orku/course_project_dmm/с одной зубчатой передчей/ЛИР-119А.docx

ЛИР-119А

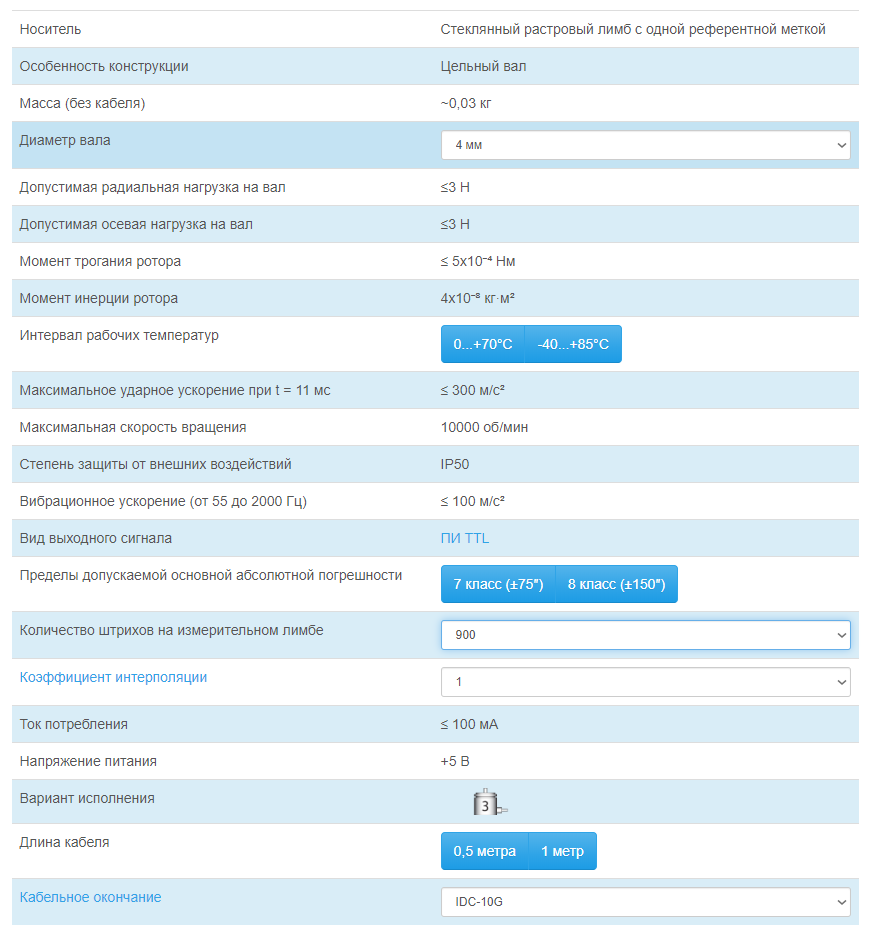
[picture p18: figure]
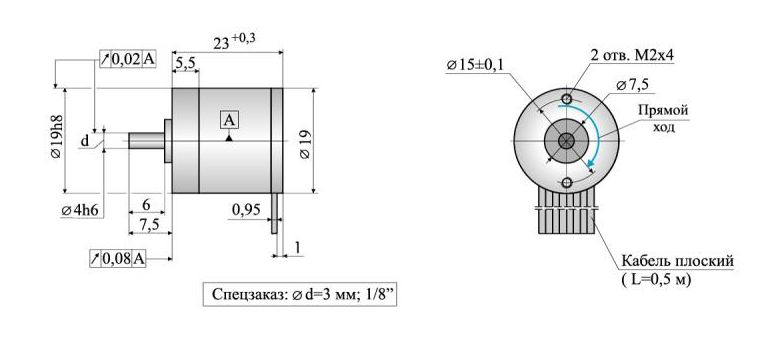
[picture p19: figure]
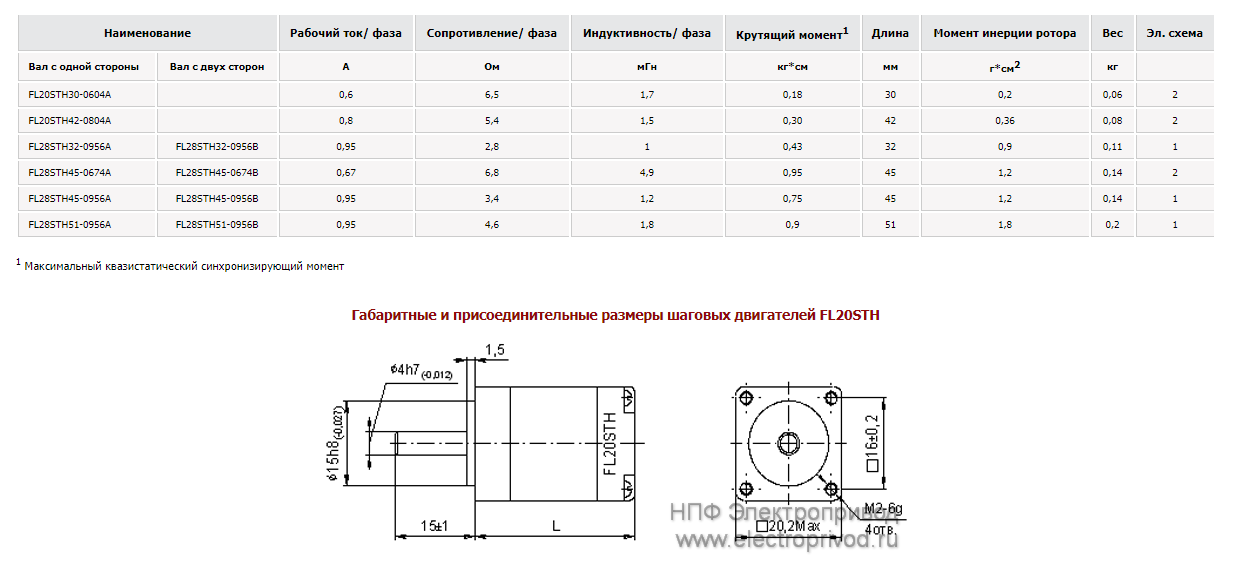
[picture p20: figure]
