orku/course_project_dmm/с одной зубчатой передчей/val/на жёчткость.docx

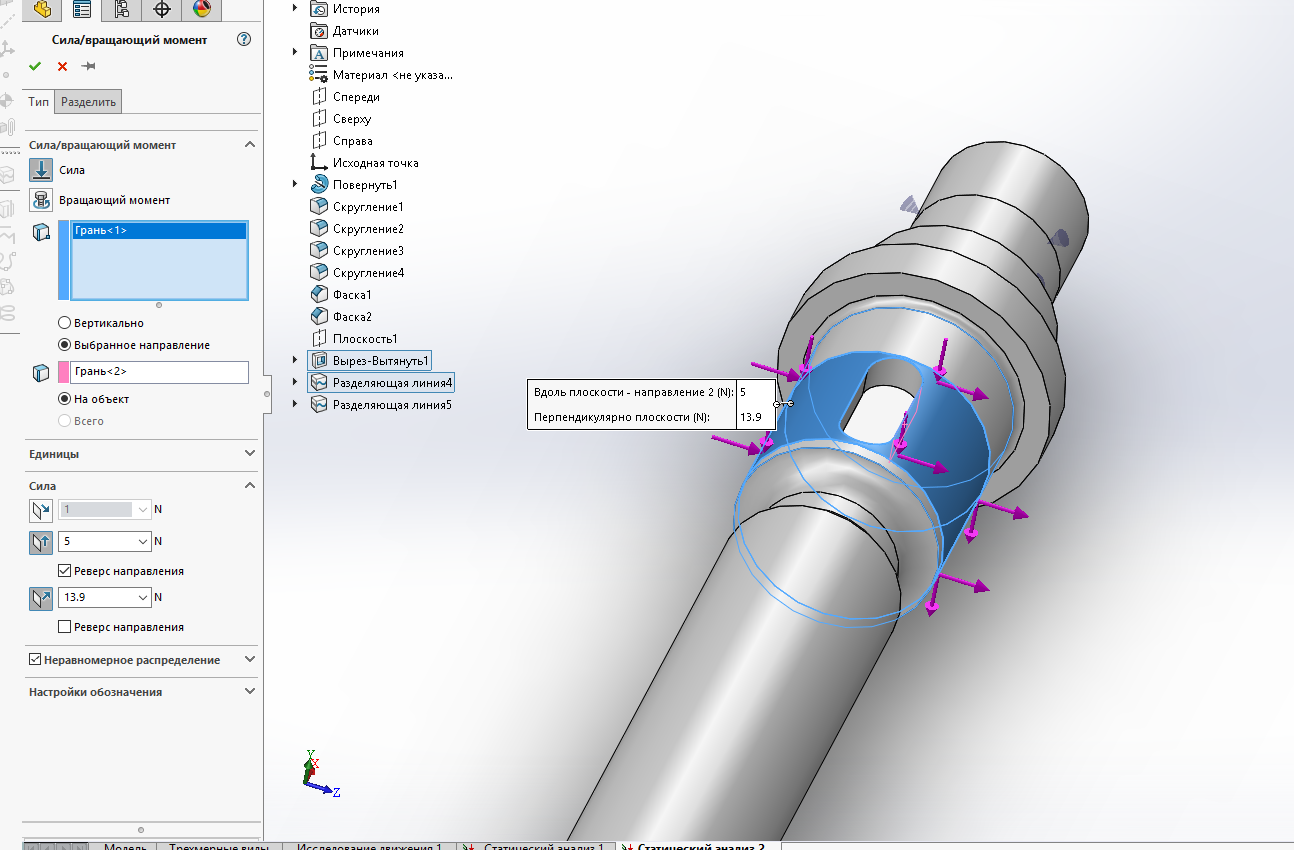
[picture p33: figure]
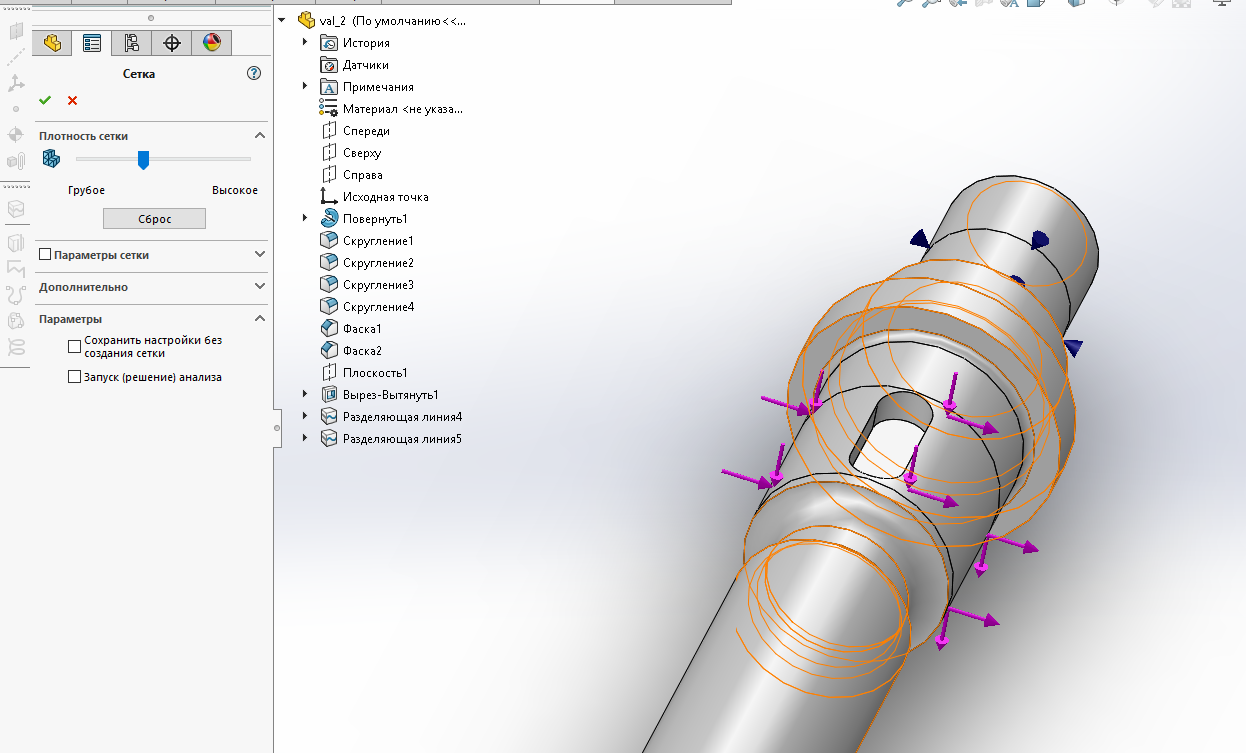
[picture p34: figure]
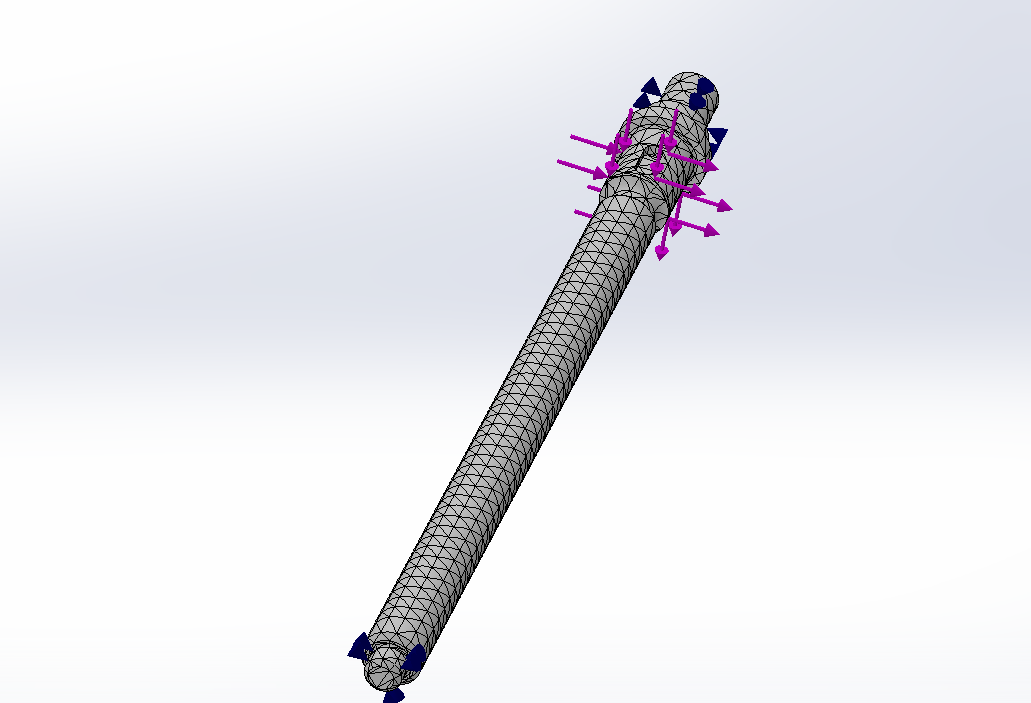
[picture p35: figure]
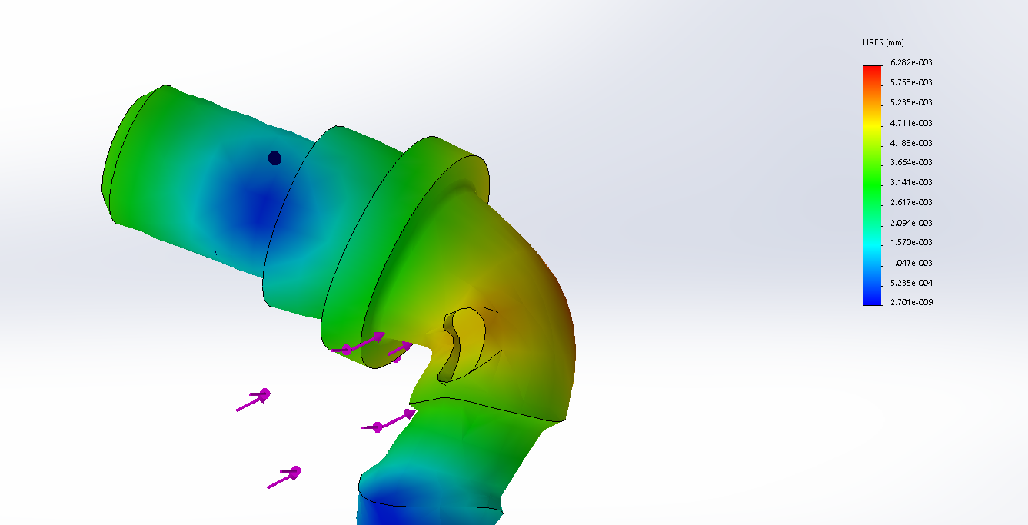
[picture p36: figure]
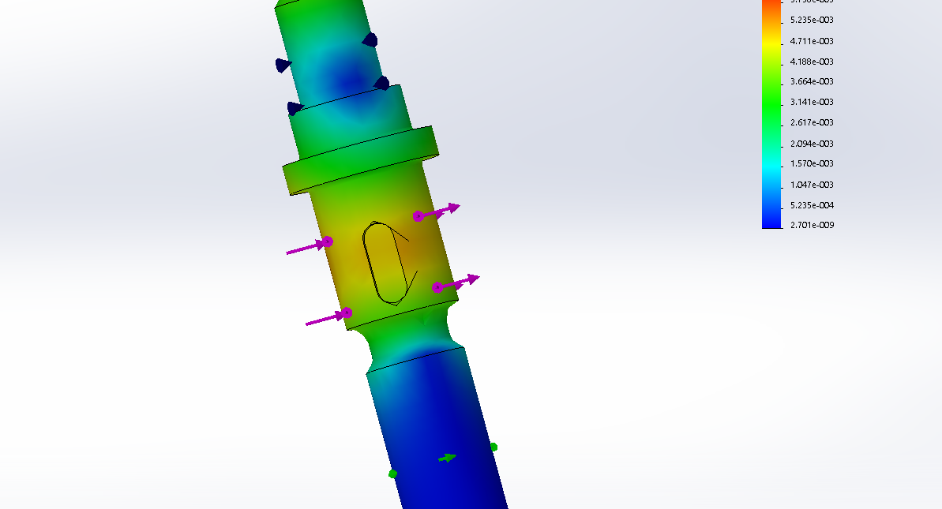
[picture p37: figure]
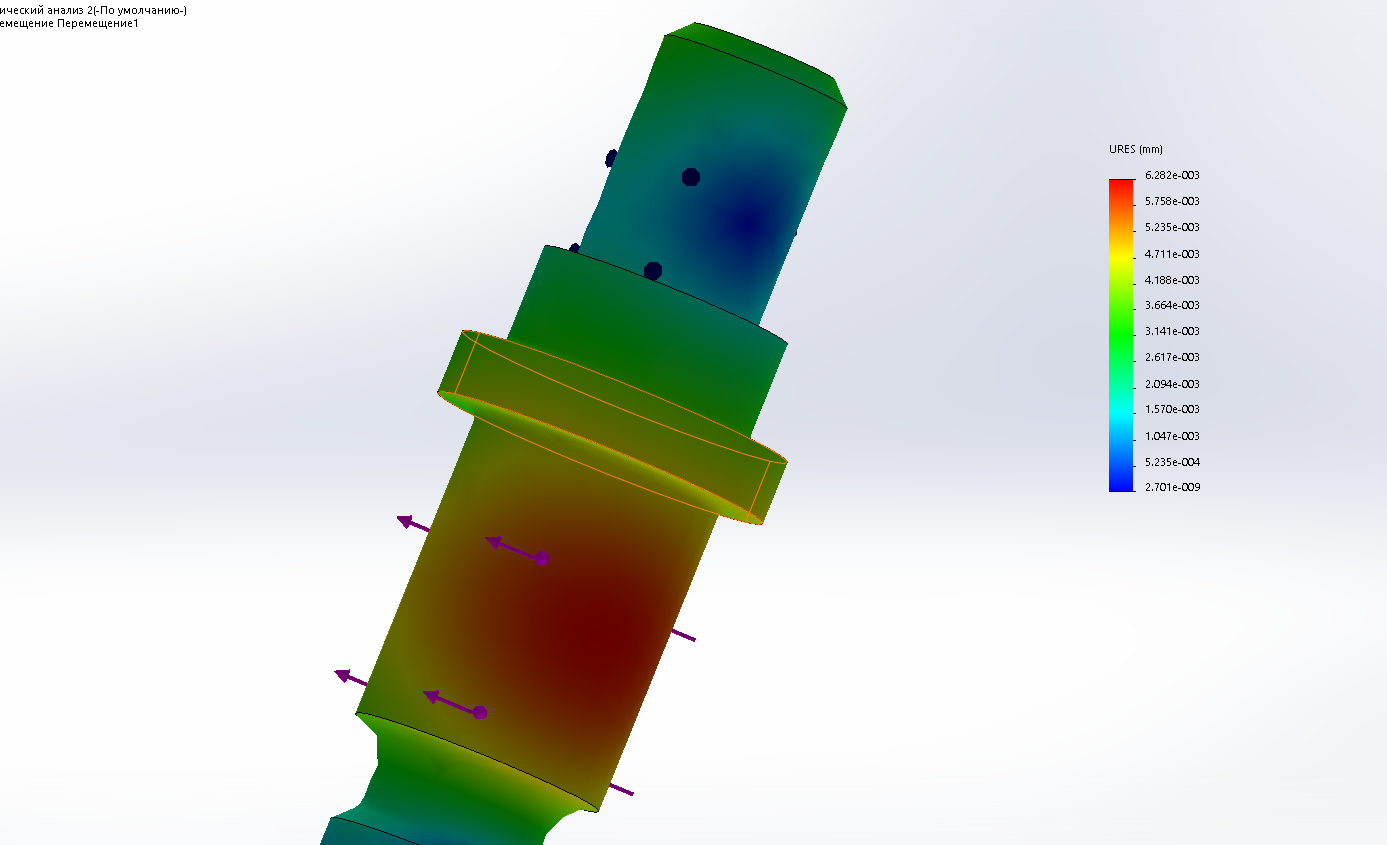
[picture p38: figure]
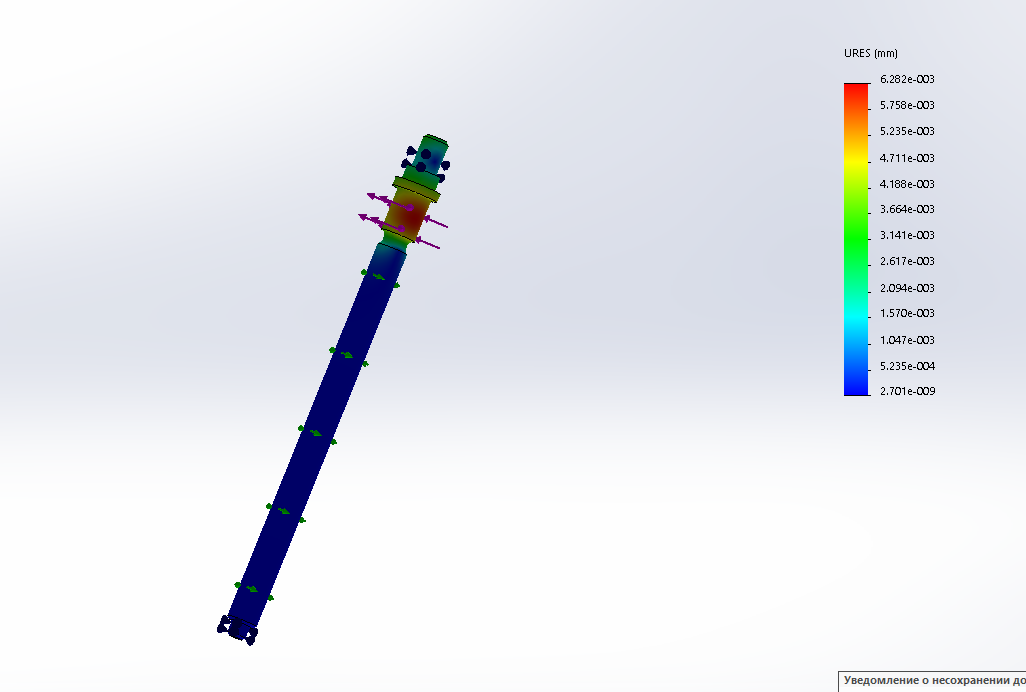
[picture p39: figure]
