orku/course_project_dmm/с одной зубчатой передчей/val/val_2-Статический анализ 1-1.docx

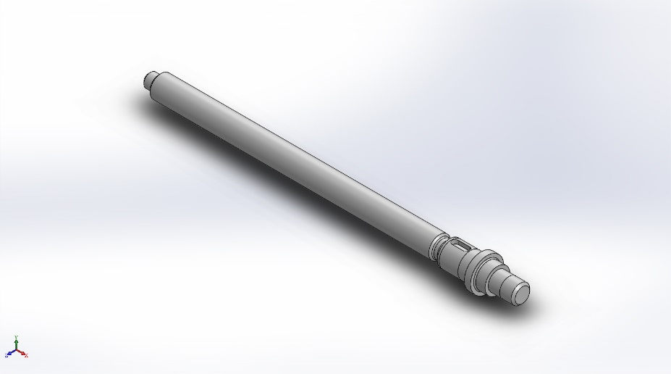
[picture p40: figure]

Симуляция val_2

Date: 21 мая 2020 г.
Создатель:: Шестаков А, А,

Имя исследования: Статический анализ 1

Тип анализа: Статический анализ
Описание Данные отсутствуют

# Допущения

# Информация о модели

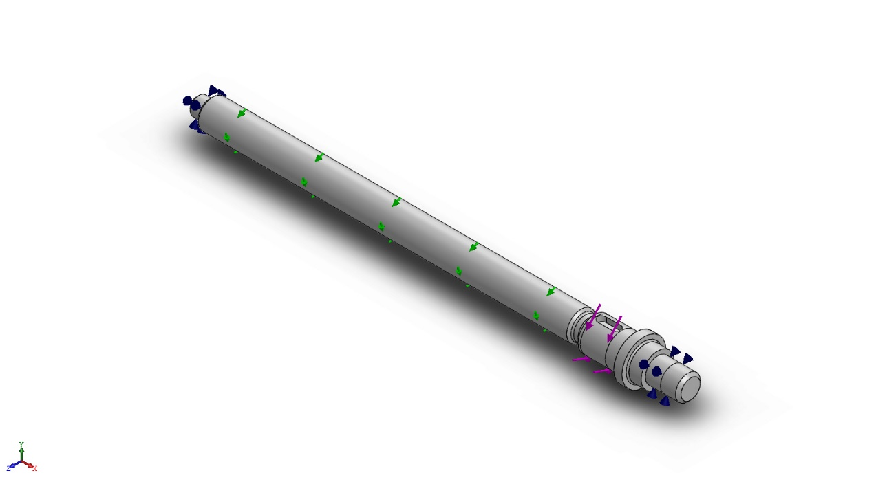
[picture p41: figure]

Имя модели: val_2

Активная конфигурация: По умолчанию

Твердые тела
Имя и ссылки документа | Рассматривается как | Объемные свойства | Путь документа/Дата изменения

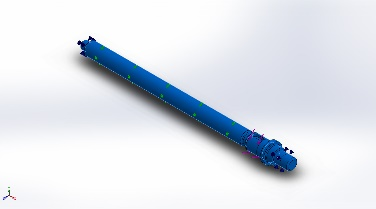
[picture p42: figure]

Разделяющая линия5 | Твердое тело | Масса:0.119673 kg Объем:1.57568e-005 m^3 Плотность:7595 kg/m^3 Масса:1.1728 N | C:\Users\asus\OneDrive\Курсач ДММ\course_project_dmm\с одной зубчатой передчей\val\val_2.SLDPRT May 21 02:11:37 2020

# Свойства исследования

Имя исследования | Статический анализ 1
Тип анализа | Статический анализ
Тип сетки | Сетка на твердом теле
Тепловой эффект: | Вкл
Термический параметр | Включить тепловые нагрузки
Температура при нулевом напряжении | 298 Kelvin
Включить эффекты давления жидкости из SOLIDWORKS Flow Simulation | Выкл
Тип решающей программы | FFEPlus
Влияние нагрузок на собственные частоты: | Выкл
Мягкая пружина: | Выкл
Инерционная разгрузка: | Выкл
Несовместимые параметры связи | Авто
Большие перемещения | Выкл
Вычислить силы свободных тел | Вкл
Трение | Выкл
Использовать адаптивный метод: | Выкл
Папка результатов | Документ SOLIDWORKS (C:\Users\asus\OneDrive\Курсач ДММ\course_project_dmm\с одной зубчатой передчей\val)

# Единицы

Система единиц измерения: | СИ (MKS)
Длина/Перемещение | mm
Температура | Kelvin
Угловая скорость | Рад/сек
Давление/Напряжение | N/m^2

# Свойства материала

Ссылка на модель | Свойства | Компоненты

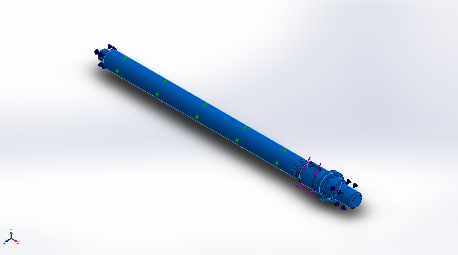
[picture p43: figure]

| Имя: Сталь 45 ГОСТ 1050-2013 Тип модели: Линейный Упругий Изотропный Критерий прочности по умолчанию: Максимальное напряжение von Mises Предел текучести: 6.4e+008 N/m^2 Предел прочности при растяжении: 5.9e+008 N/m^2 Предел прочности при сжатии: 3.75e+008 N/m^2 Модуль упругости: 2e+009 N/m^2 Коэффициент Пуассона: 0.394 Массовая плотность: 7595 kg/m^3 Модуль сдвига: 7.8e+009 N/m^2 | Твердое тело 1(Разделяющая линия5)(val_2)

Данные кривой:N/A

# Нагрузки и крепления

Имя крепления | Изображение крепления | Данные крепления

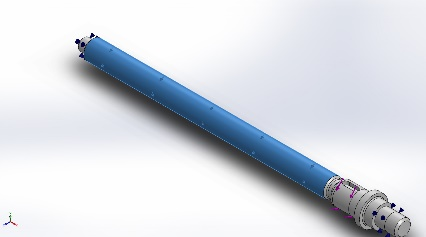
[picture p44: figure]

На цилиндрических гранях-1 | | Объекты: 1 грани Тип: На цилиндрических гранях Смещение: ---, 0 рад., --- Единицы измерения: mm

Результирующие силы

Компоненты | X | Y | Z | Результирующая
Сила реакции(N) | -2.80074e-007 | -0.0234661 | 4.933 | 4.93306
Реактивный момент(N.m) | 0 | 0 | 0 | 0

Имя нагрузки | Загрузить изображение | Загрузить данные

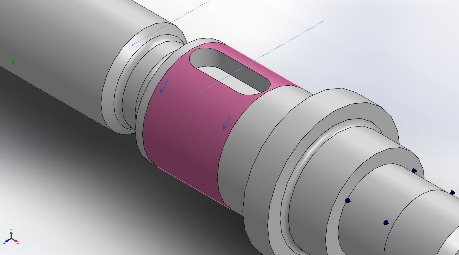
[picture p45: figure]

Вращающий момент-1 | | Справочный: Грань< 1 > Тип: Приложить вращающий момент Значение: 0.52 N.m

# Определения соединителей

Соединитель-шпилька/болт/подшипник

Ссылка на модель | Данные соединителя | Данные силы

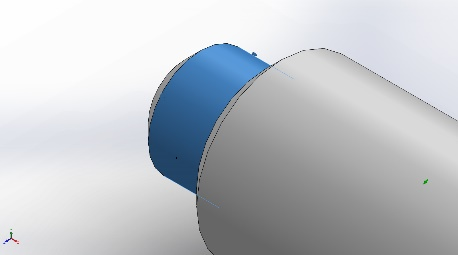
[picture p46: figure]

Опора подшипника-1 | Объекты: 1 грани Тип: Подшипник | Данные отсутствуют

Силы соединителя

Тип | X-составляющая | Y-составляющая | Z-составляющая | Результирующая
Осевое усилие (N) | 0.0024335 | 0 | 0 | 0.0024335
Поперечная сила (N) | 0 | -2.885e-006 | 4.2127e-006 | 5.1182e-006
Изгибающий момент (N.m) | 0 | 0 | 0 | 0

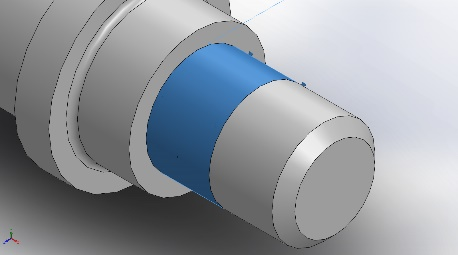
[picture p47: figure]

Опора подшипника-2 | Объекты: 1 грани Тип: Подшипник | Данные отсутствуют

Силы соединителя

Тип | X-составляющая | Y-составляющая | Z-составляющая | Результирующая
Осевое усилие (N) | -0.0024332 | -0 | -0 | -0.0024332
Поперечная сила (N) | 0 | 0.014527 | 1.9899 | 1.9899
Изгибающий момент (N.m) | 0 | 0 | 0 | 0

# Данные контакта

Данные отсутствуют

# Информация о сетке

Тип сетки | Сетка на твердом теле
Используемое разбиение: | Стандартная сетка
Автоматическое уплотнение сетки: | Выкл
Включить автоциклы сетки: | Выкл
Точки Якобиана | 4 Точки
Размер элемента | 3.38571 mm
Допуск | 0.169286 mm
Эпюра качества сетки | Высокая

## Информация о сетке - Детализация

Всего узлов | 6861
Всего элементов | 4013
Максимальное соотношение сторон | 10.452
% элементов с соотношением сторон < 3 | 91.3
% элементов с соотношением сторон > 10 | 0.0249
% искаженных элементов (Якобиан) | 0
Время для завершения сетки (hh;mm;ss): | 00:00:03
Имя компьютера:

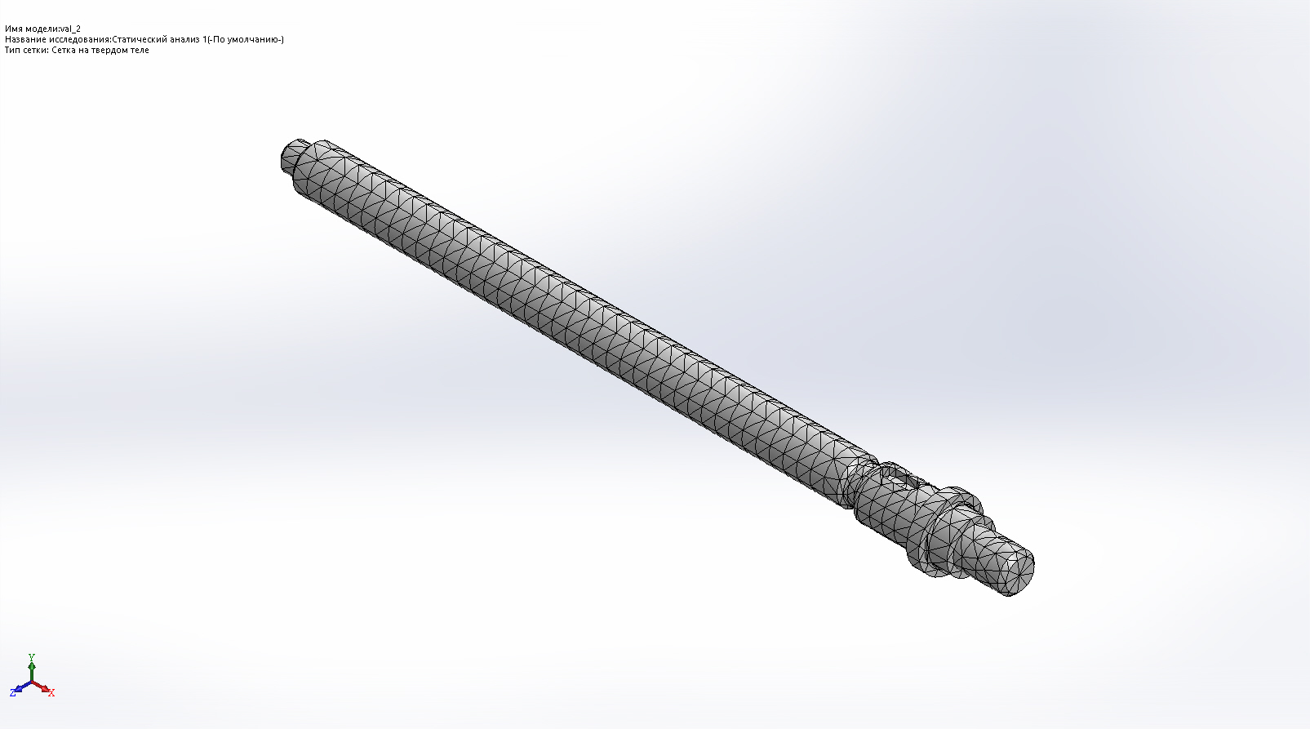
[picture p48: figure]

# Данные датчиков

Данные отсутствуют

# Результирующие силы

## Силы реакции

Выбранный набор | Единицы | Сумма X | Сумма Y | Сумма Z | Результирующая
всей модели | N | -2.80074e-007 | -0.0234661 | 4.933 | 4.93306

## Моменты реакции

Выбранный набор | Единицы | Сумма X | Сумма Y | Сумма Z | Результирующая
всей модели | N.m | 0 | 0 | 0 | 0

# Балки

Данные отсутствуют

# Результаты исследования

Имя | Тип | Мин | Макс
Напряжение1 | VON: Напряжение Von Mises | 2.979e+000N/m^2 Узел: 1397 | 1.019e+007N/m^2 Узел: 500

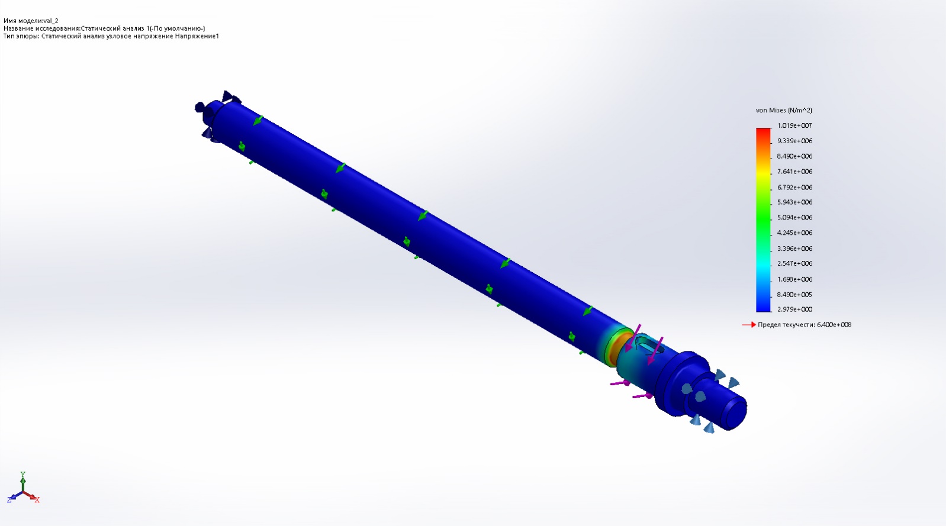
[picture p49: figure]

val_2-Статический анализ 1-Напряжение-Напряжение1

Имя | Тип | Мин | Макс
Перемещение1 | URES: Результирующее перемещение | 2.345e-010mm Узел: 507 | 7.798e-002mm Узел: 2746

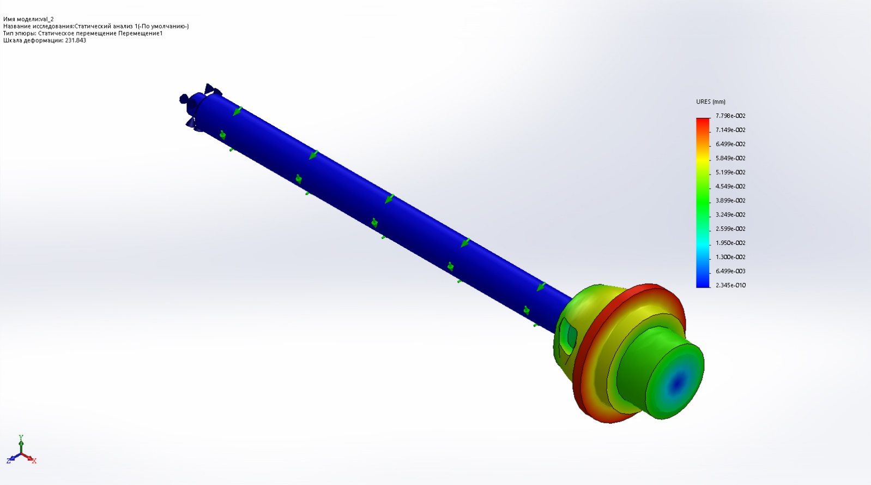
[picture p50: figure]

val_2-Статический анализ 1-Перемещение-Перемещение1

Имя | Тип | Мин | Макс
Деформация1 | ESTRN: Эквивалентная деформация | 2.664e-009 Элемент: 2767 | 3.871e-003 Элемент: 2362

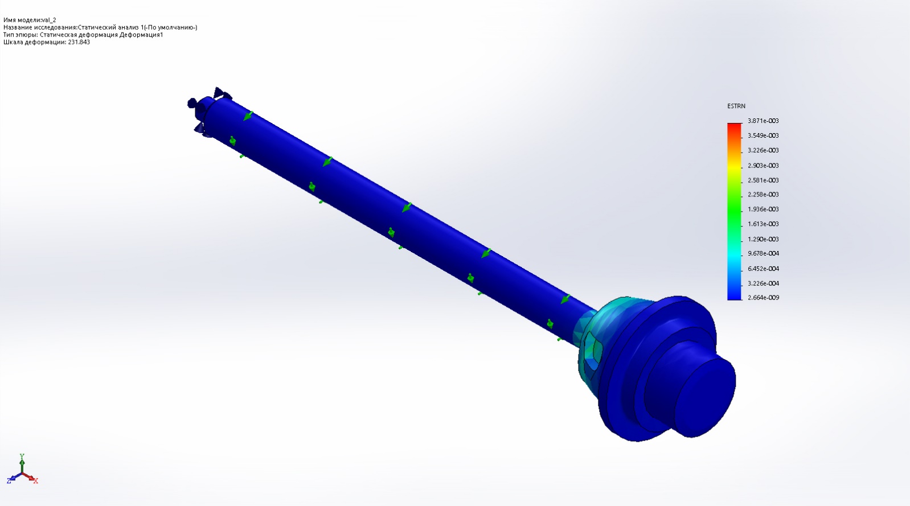
[picture p51: figure]

val_2-Статический анализ 1-Деформация-Деформация1

# Вывод

Проанализировано с помощью SOLIDWORKS Simulation Симуляция val_2 7

Проанализировано с помощью SOLIDWORKS Simulation Симуляция val_2 1

МГТУ им. Н. Э. Баумана СМ11-61Б Шестаков А, А, 21.05.2020

МГТУ им. Н. Э. Баумана СМ11-61Б
