orku/course_project_dmm/с одной зубчатой передчей/val/val_2-Статический анализ 1-2.docx

Симуляция val_2

Date: 21 мая 2020 г.
Создатель:: Шестаков А. А.

Имя исследования: Статический анализ 1

Тип анализа: Статический анализ
Описание Данные отсутствуют

# Допущения

# Информация о модели

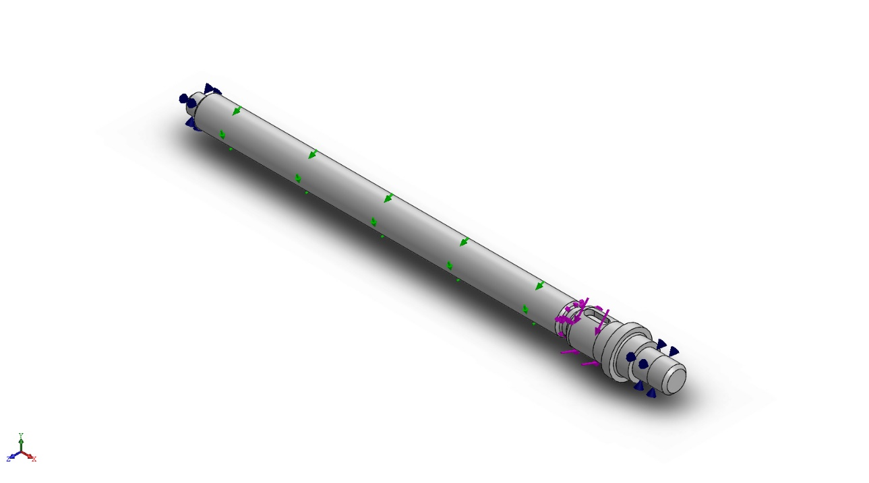
[picture p52: figure]

Имя модели: val_2

Активная конфигурация: По умолчанию

Твердые тела
Имя и ссылки документа | Рассматривается как | Объемные свойства | Путь документа/Дата изменения

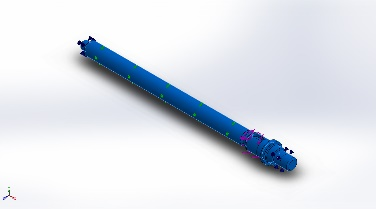
[picture p53: figure]

Разделяющая линия5 | Твердое тело | Масса:0.119673 kg Объем:1.57568e-005 m^3 Плотность:7595 kg/m^3 Масса:1.1728 N | C:\Users\asus\OneDrive\Курсач ДММ\course_project_dmm\с одной зубчатой передчей\val\val_2.SLDPRT May 21 02:11:37 2020

# Свойства исследования

Имя исследования | Статический анализ 1
Тип анализа | Статический анализ
Тип сетки | Сетка на твердом теле
Тепловой эффект: | Вкл
Термический параметр | Включить тепловые нагрузки
Температура при нулевом напряжении | 298 Kelvin
Включить эффекты давления жидкости из SOLIDWORKS Flow Simulation | Выкл
Тип решающей программы | FFEPlus
Влияние нагрузок на собственные частоты: | Выкл
Мягкая пружина: | Выкл
Инерционная разгрузка: | Выкл
Несовместимые параметры связи | Авто
Большие перемещения | Выкл
Вычислить силы свободных тел | Вкл
Трение | Выкл
Использовать адаптивный метод: | Выкл
Папка результатов | Документ SOLIDWORKS (C:\Users\asus\OneDrive\Курсач ДММ\course_project_dmm\с одной зубчатой передчей\val)

# Единицы

Система единиц измерения: | СИ (MKS)
Длина/Перемещение | mm
Температура | Kelvin
Угловая скорость | Рад/сек
Давление/Напряжение | N/m^2

# Свойства материала

Ссылка на модель | Свойства | Компоненты

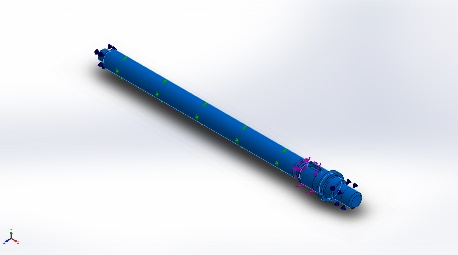
[picture p54: figure]

| Имя: Сталь 45 ГОСТ 1050-2013 Тип модели: Линейный Упругий Изотропный Критерий прочности по умолчанию: Максимальное напряжение von Mises Предел текучести: 6.4e+008 N/m^2 Предел прочности при растяжении: 5.9e+008 N/m^2 Предел прочности при сжатии: 3.75e+008 N/m^2 Модуль упругости: 2e+009 N/m^2 Коэффициент Пуассона: 0.394 Массовая плотность: 7595 kg/m^3 Модуль сдвига: 7.8e+009 N/m^2 | Твердое тело 1(Разделяющая линия5)(val_2)

Данные кривой:N/A

# Нагрузки и крепления

Имя крепления | Изображение крепления | Данные крепления

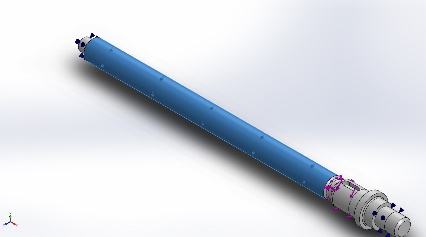
[picture p55: figure]

На цилиндрических гранях-1 | | Объекты: 1 грани Тип: На цилиндрических гранях Смещение: ---, 0 рад., --- Единицы измерения: mm

Результирующие силы

Компоненты | X | Y | Z | Результирующая
Сила реакции(N) | 1.59601e-007 | -0.00971296 | 4.93778 | 4.93779
Реактивный момент(N.m) | 0 | 0 | 0 | 0

Имя нагрузки | Загрузить изображение | Загрузить данные

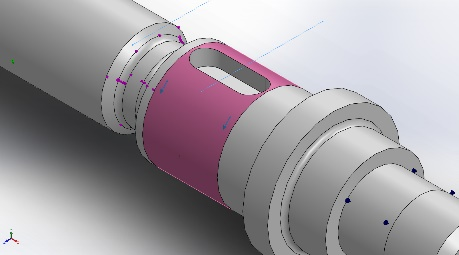
[picture p56: figure]

Вращающий момент-1 | | Справочный: Грань< 1 > Тип: Приложить вращающий момент Значение: 0.52 N.m

# Определения соединителей

Соединитель-шпилька/болт/подшипник

Ссылка на модель | Данные соединителя | Данные силы


Опора подшипника-1 | Объекты: 1 грани Тип: Подшипник | Данные отсутствуют

Силы соединителя

Тип | X-составляющая | Y-составляющая | Z-составляющая | Результирующая
Осевое усилие (N) | -0.00042492 | -0 | -0 | -0.00042492
Поперечная сила (N) | 0 | -4.0452e-007 | 1.1435e-007 | 4.1549e-007
Изгибающий момент (N.m) | 0 | 0 | 0 | 0


Опора подшипника-2 | Объекты: 1 грани Тип: Подшипник | Данные отсутствуют

Силы соединителя

Тип | X-составляющая | Y-составляющая | Z-составляющая | Результирующая
Осевое усилие (N) | 0.00042521 | 0 | 0 | 0.00042521
Поперечная сила (N) | 0 | 0.0013764 | 1.9081 | 1.9081
Изгибающий момент (N.m) | 0 | 0 | 0 | 0

# Данные контакта

Данные отсутствуют

# Информация о сетке

Тип сетки | Сетка на твердом теле
Используемое разбиение: | Стандартная сетка
Автоматическое уплотнение сетки: | Выкл
Включить автоциклы сетки: | Выкл
Точки Якобиана | 4 Точки
Размер элемента | 3.38571 mm
Допуск | 0.169286 mm
Эпюра качества сетки | Высокая

## Информация о сетке - Детализация

Всего узлов | 21614
Всего элементов | 13799
Максимальное соотношение сторон | 9.8607
% элементов с соотношением сторон < 3 | 96.8
% элементов с соотношением сторон > 10 | 0
% искаженных элементов (Якобиан) | 0
Время для завершения сетки (hh;mm;ss): | 00:00:02
Имя компьютера:

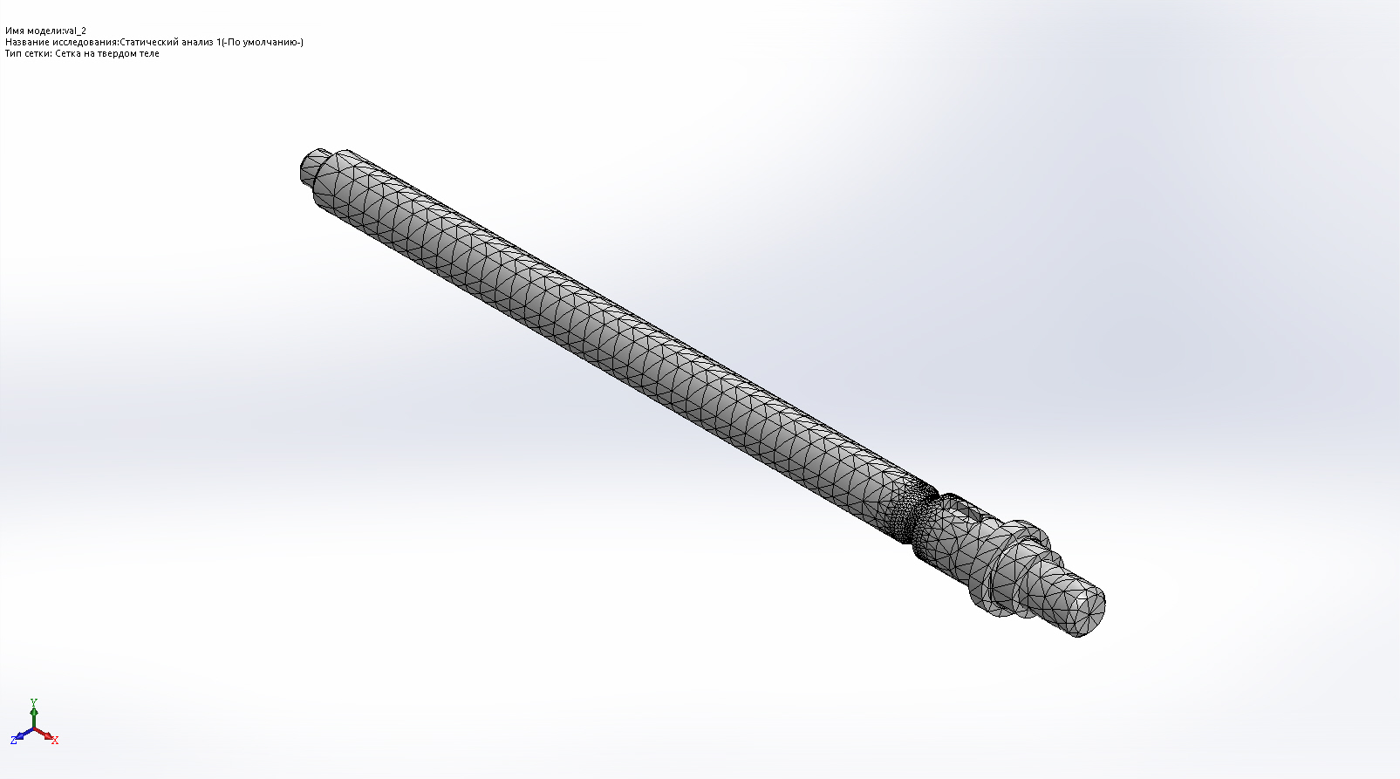
[picture p57: figure]

## Информация по управлению сеткой:

Имя управления сеткой | Изображение управления сеткой | Сведения об управлении сеткой

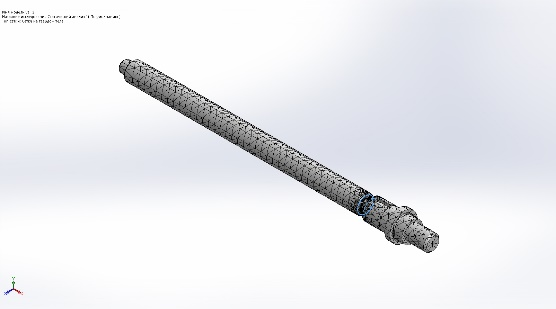
[picture p58: figure]

Управление-1 | | Объекты: 1 кромки, 5 грани Единицы измерения: mm Размер: 0.626984 Пропорция: 1.5

# Данные датчиков

Данные отсутствуют

# Результирующие силы

## Силы реакции

Выбранный набор | Единицы | Сумма X | Сумма Y | Сумма Z | Результирующая
всей модели | N | 1.59601e-007 | -0.00971296 | 4.93778 | 4.93779

## Моменты реакции

Выбранный набор | Единицы | Сумма X | Сумма Y | Сумма Z | Результирующая
всей модели | N.m | 0 | 0 | 0 | 0

# Балки

Данные отсутствуют

# Результаты исследования

Имя | Тип | Мин | Макс
Напряжение1 | VON: Напряжение Von Mises | 6.981e-001N/m^2 Узел: 1668 | 1.078e+007N/m^2 Узел: 14621

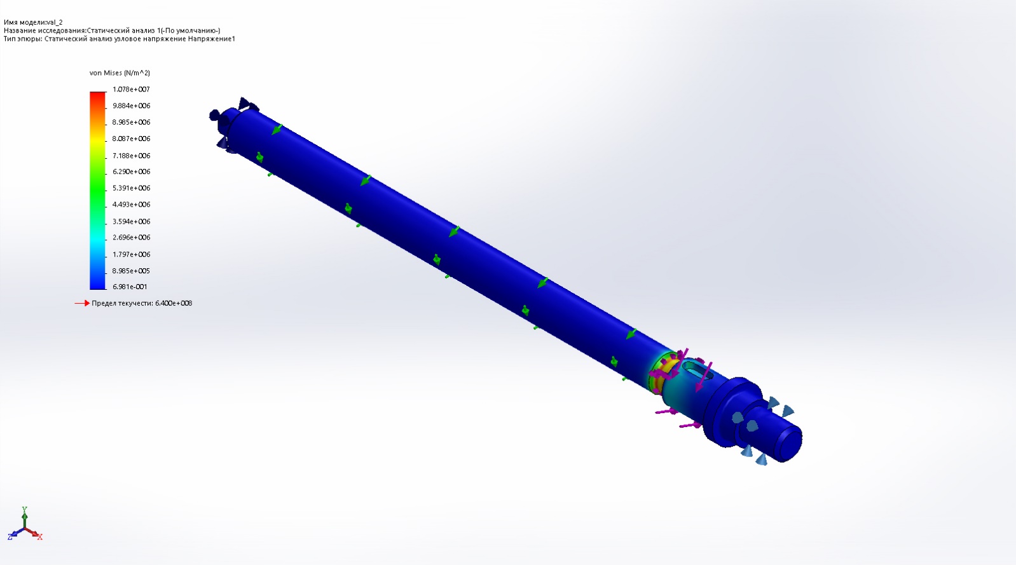
[picture p59: figure]

val_2-Статический анализ 1-Напряжение-Напряжение1

Имя | Тип | Мин | Макс
Перемещение1 | URES: Результирующее перемещение | 5.812e-011mm Узел: 21426 | 7.943e-002mm Узел: 11866

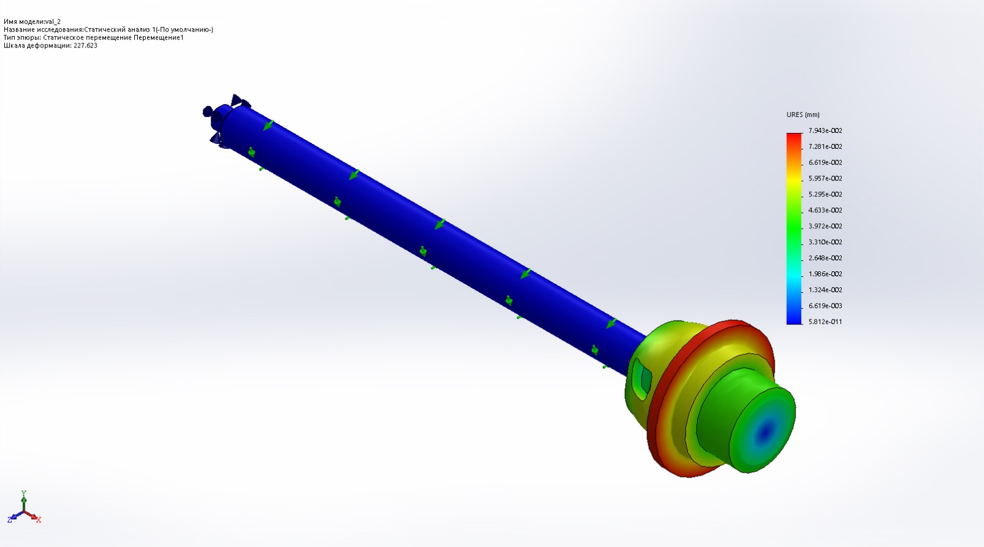
[picture p60: figure]

val_2-Статический анализ 1-Перемещение-Перемещение1

Имя | Тип | Мин | Макс
Деформация1 | ESTRN: Эквивалентная деформация | 4.122e-010 Элемент: 11133 | 4.569e-003 Элемент: 4695

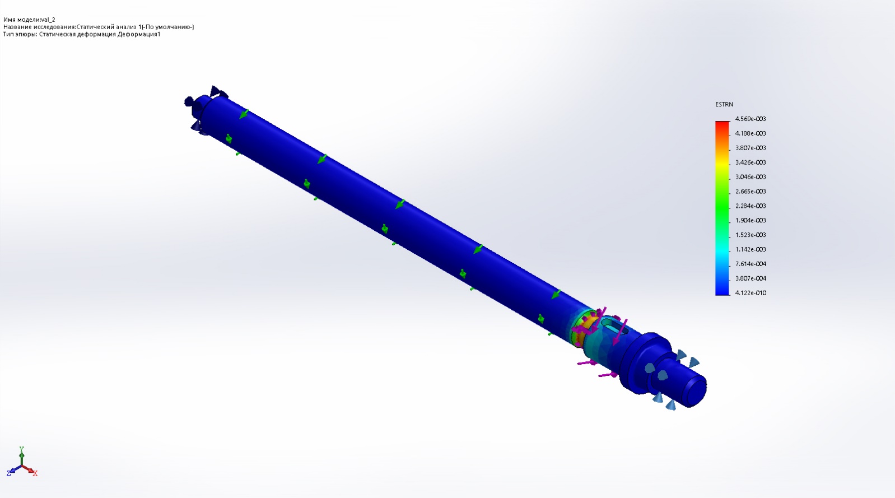
[picture p61: figure]

val_2-Статический анализ 1-Деформация-Деформация1

# Вывод

Проанализировано с помощью SOLIDWORKS Simulation Симуляция val_2 57

Проанализировано с помощью SOLIDWORKS Simulation Симуляция val_2 56

МГТУ им. Н. Э. Баумана СМ11-61Б Шестаков А. А. 21.05.2020

МГТУ им. Н. Э. Баумана СМ11-61Б
