orku/course_project_dmm/с одной зубчатой передчей/печать на консу 08.05.2020/переделываю рпз(оааааааааааааааааааапять).docx

# Оглавление

# Техническое задание

№ варианта | 4
Параметры
Сила на выходном звене F, Н | 150
Скорость движения выходного звена V, м/с | 0,012
Ход выходного звена S, мм | 90
Диаметр и шаг винта выходной пары d/p, d и p, мм* | 12/3
Тип предохранителя муфты | Фрикционная
Критерий проектирования | Min погрешности
Тип электродвигателя | По согласованию с преподавателем
Тип корпуса | По согласованию с преподавателем
Ограничитель движения | Механические упоры и микровыключатели
Вид крепления к основному изделию | По согласованию с преподавателем
Вывод выходного винта | По согласованию с преподавателем
Вид выходного конца | По согласованию с преподавателем
Условия эксплуатации | УХЛ 4.1
Тип кинематической схемы | По согласованию с преподавателем

# 1. Расчёт передачи винт-гайка

Используем трапецеидальную резьбу.

Табл. 1. Геометрические параметры резьбы

Номинальный диаметр резьбы d | Шаг p | Диаметр резьбы
| | наружный | | средний | Внутренний
| | d | D4 | d2=D2 | d3 | D1
12 | 3 | 12 | 12,5 | 10,5 | 8,5 | 9

В передачах винт-гайка скольжения для повышения износостойкости и снижения склонности к заеданию гайки изготавливают из материалов, обладающих антифрикционными свойствами, а материал винта должен обладать высокой твёрдостью. Поэтому для изготовления винтов применяют низколегированные стали 65Г, 40Х, 40ХГ с закалкой до твёрдости не менее 45 HRC и последующим шлифованием; стали 40ХФА, 18ХГТ с азотированием для уменьшения искажения формы и размеров винтов в результате закалки. Для тихоходных слабонагруженных винтов используют стали 30, 40, 45 и 50 ГОСТ 1050 – 88 без термической обработки. При малых скоростях вращения гайки изготавливают из малооловянной бронзы Бр.О6Ц6С3, безоловянной бронзы Бр.А9Ж3Л, а также из антифрикционных чугунов АЧВ – 1, АЧК – 1, или серых чугунов СЧ15 и СЧ20 ГОСТ 1412 – 85.

Винт изготавливаем из стали 45;

Гайку изготавливаем из Бр.А9Ж3Л;

Момент нагрузки на винте определяем по формуле:

М_н =F*(d_2)/2*tg(β+ ψ)

Где d_2 – внутренний диаметр резьбы;

ψ – угол подъёма резьбы, который определяется по формуле:

ψ=arctg(p*n)/(π*d_2)= arctg(3*1)/(π*10.5)= 5.2^0

Где р – шаг резьбы, n – число заходов.

β – угол трения, который определяется по формуле:

β=arctg(f')

f^(') = f/(cosα/2)

Где α – угол резьбы ( α=30^0 );

f – коэффициент трения скольжения передачи винт гайка.

Выберем материал винта и гайки соответственно сталь 45 и бронза Бр.А9Ж3Л . У таких материалов f=0.10 .

β=arctg(f^(') )=arctg(0.104)=5.7^0

f^(') = 0.1/(cos15^0)=0.104

Поскольку ψ < β – условие самоторможения выполнено, следовательно передача самотормозящаяся.

КПД винтовой передачи определим по формуле

η= (tg(ψ))/(tg(ψ+β))= (tg(5.7))/(tg(10.9))=0.51

Проверочный расчёт выполнять не будем, так как: во-первых допущения, которые влияют на проверочный расчёт мы не рассматриваем в курсовом проекте, поэтому он совпадает с проектировачным, во-вторых параметры передачи назначены такие, чтобы заведомо проходить проверочные расчёты.

# 2.Выбор двигателя

# 2.1Выбор двигателя по мощности

Двигатель следует выбрать с учётом расчётной мощности двигателя, которая должна быть достаточна для перемещения нагрузки в соответствии с техническим заданием.

Расчётная мощность электродвигателя определяется по формуле:

Pр=(ξ·Pн)/(ηо),

где Pр — расчётная мощность электродвигателя;

Pн — расчётная мощность нагрузки;

ηо = 0.5 … 0.95 — КПД цепи двигатель-нагрузка, выберем ηо = 0.50, ξ – коэффициент запаса, выберем ξ=2.5.

Расчётная мощность нагрузки вычисляется по формуле:

Pн = F*V,

где F — усилие на выходном звене;

V — скорость движения выходного звена.

Pн = 150*0.012=1.8 В,

Тогда расчётная мощность двигателя:

Pр=(2.3·1.8)/(0.51·0.9)=9 Вт.

Теперь выберем двигатель по мощности

Pдв =Мном ·ωдв, | | (1.4)

где Мном — номинальный крутящий момент электродвигателя;

ω – угловая скорость вращения двигателя, определяется по формуле:

ωдв= (2π)/60n

где n — частота двигателя.

Выбираем предварительно шаговый двигатель

Таблица 2. Паспортные данные FL39ST20-0404A

Угловой шаг | | 1.8 град
Момент инерции ротора | Jр | 11∙10⁻⁷ кг·м²
Масса | m | 0,12 кг
Гарантийная наработка двигателя
Ток фазы | | 0,4 А
Сопротивление фазы | | 6.6 Ом
Индуктивность фазы | | 7.5 мГн
Рабочая температура | | -20 до +50 °C
Максимальный нагрев двигателя | | 80 °C
Максимальная допустимая радиальная нагрузка на вал | | 28 Н
Максимальная допустимая осевая нагрузка на вал | | 10 Н


Из рис.1 выберем Мном = 0,070 Н·м, n = 1800 об/мин.

ωдв= (2π)/60n= (2π)/601800=188(рад)/с

Pдв =Мном ·ωдв= 0.070*188=13.2 Вт.

Условие Pдв >Pр выполняется: 13.2 Вт > 9 Вт, следовательно, по мощности двигатель выбран правильно.

# 2.2 Предварительная проверка выбора двигателя по моментам.

Для режима частых пусков двигатель должен удовлетворять условию:

Mном ≥ Mс.пр. + Mд.пр,

где Mном — номинальный момент на валу двигателя;

Mс. пр. — статический приведённый момент;

Mд. пр. — динамический приведённый момент.

Статический приведённый момент определяется по формуле:

Mс.пр.=(Mн)/(iо·ηпер),

где Mс. пр. — статический приведённый момент;

Mн — момент нагрузки;

iо — общее передаточное отношение;

ηпер = 0,9 — КПД механической передачи;

Момент нагрузки определяем по формуле:

М_н =F*(d_2)/2*tg(β+ ψ)

Где d_2 – внутренний диаметр резьбы;

М_н =150*(10.5* 10^(-3))/2*tg(10, 9^0 )=152 Нмм.

Определим i0:

ω_н =v(2π)/(pn)=12(2π)/(3*1)=25рад/с

i_0 = (ω_(дв))/(ω_н)=7.5

Динамический приведённый момент определяется по формуле:

Mд.пр.=εн·iо·((1+Kм)·Jр+(J_н)/(i_о^2))

где εн — угловое ускорение вращения на выходном звене(εн= 0, так как не дано по условию, тогда Mд.пр. = 0);

iо — общее передаточное отношение, i_0 =7.5

Kм — коэффициент, учитывающий инерционность собственного зубчатого механизма Kм = 0.7;

Jр — момент инерции ротора двигателя (из паспортных данных);

Jн — момент инерции нагрузки

εн – угловое ускорение нагрузки (примем εн = 0, потому что оно не задано)

Mс.пр.=152/(7.5·0.9)=22.5 Нмм

Выполним предварительную проверку по моментам:

70Нмм ≥ 22.5 Нмм + 0 | (1.3)

Проверка выполняется, следовательно – двигатель выбран правильно.

# 3. Кинематический расчёт

Целью расчёта является разработка кинематической схемы привода, разбиение передаточного отношения, определения числа зубьев зубчатых колес.

# 3.1 Определение общего передаточного отношения

Поскольку предварительно двигатель выбран, можно рассчитать передаточное отношение iо цепи двигатель-нагрузка.

i_о =(n_(дв))/(n_н)=(ω_(дв))/(ω_н) | (2.1)

где ω_(дв) — угловая скорость вращения вала двигателя;

ω_н — угловая скорость вращения винта.

i_0 = (ω_(дв))/(ω_н)=7.5

# 3.2 Разбиение общего передаточного отношения по ступеням

Согласно условию ТЗ проектирование будет осуществляться по критерию минимизации погрешности. При расчёте критерию минимизации погрешности число ступеней будет вычисляться по формуле:

n=(lgi_0)/(lgi_(max)),

где n — число ступеней;

i_0 — общее передаточное отношение цепи

i_(max) — максимальное передаточное отношение (7,5 … 10)

Передаточное отношение ступеней рассчитывается по формуле:

n=(lgi_0)/(lgi_(max))=(lg7.52)/(lg7.5)=1

где n — число ступеней;

i1<ii<in-1

Передаточные отношения ступеней сведены в таблицу 3

Таблица 3. Передаточные отношения

i12

7.5

# 3.3 Определение чисел зубьев зубчатых колес

Пусть число зубьев шестерни zш = 20.

Число зубьев колеса рассчитывается по формуле:

zк = zш·ij ,

где zк — число зубьев колеса;

zш — число зубьев шестерни;

ij —передаточное отношение одной ступени.

Учитывая рекомендованный ряд, назначаем количества зубьев колес и шестерен:

Таблица 4. Числа зубьев колес редуктора

№ колеса | 1 | 2
№ элементарной передачи | I
Число зубьев | 20 | 150

Уточним значения передаточных отношений:

Таблица 5. Уточненные передаточные отношения

i12

7.5

Тогда действительное значение передаточного отношения будет отличаться от расчётного на:

Δi=(|iд-iо|)/(iо),

где Δi — отличие действительного передаточного отношения от расчётного;

iд — действительное передаточное отношение;

iо — общее передаточное отношение цепи.

Действительное передаточное отношение рассчитывается по формуле:

iд = i_12 ·i_34 …

iд = 7.5 = 12.50

Δi=(|7.52-7.5|)/7.52=0.003

0.3% ≤ 1%

По критерию максимальной точности такое отклонение допустимо. В таком случае можно считать выбранные значения чисел зубьев колеса и шестерни подходящими.

Кинематическая схема приведена на рисунке:


# 4. Силовой расчёт

Целью силового расчёта является определение возникающих в каждой передаче моментов.

Моменты рассчитываются по формуле:

Mведущ=(Mведом)/(ij·ηj·ηподш)

где Mведущ — момент на ведущем звене;

Mведом — момент на ведомом звене;

ij — передаточное отношение ступени;

ηj — КПД передачи(ηj = 0,98);

ηподш — КПД подшипников(ηподш = 0,9).

Общий момент нагрузки рассчитывается по формуле:

М_Σ =М_н +М_д =М_н + Jн·εн ,

εн – угловое ускорение нагрузки (примем εн = 0, потому что оно не задано)

Jн — момент инерции нагрузки;

где Mн – момент нагрузки;

f – коэффициент трения скольжения передачи винт гайка

Mд – динамический момент нагрузки;

Jн – момент инерции нагрузки;

εн –угловое ускорение вращения выходного вала.

Тогда

М_Σ =М_н = 152 + 0= 152Нмм

MII=152/0.98=172 Нмм

MI=172/(0.9*0.98*7.5)=26 Нмм

Выполним предварительную проверку правильности выбора двигателя: Mпуск = Мдв.ном ≥ М1 По паспортным данным Мдв.ном = 70 Нмм, то есть 70 > 26.

Значит выбранный двигатель подходит.

# 5. Расчёт зубчатых колёс на прочность

Целью расчёта является определение модуля зацепления зубчатых колёс, обеспечивающего работоспособность в течение заданного срока службы.

# 5.1 Выбор материала

Для цилиндрической передачи открытого типа с небольшими окружными скоростями в качестве материала для шестерён будет использоваться углеродистая сталь 45, а в качестве материала для колёс — сталь 35 в соответствии с рекомендациями. Зубья шестерён будут выполнены из материалов с более высокой твёрдостью рабочих поверхностей по сравнению с колёсами для повышения долговечности зубчатой передачи.

Таблица 7. Характеристики используемых материалов

| Шестерня | Колесо
Материал | Сталь 45 | Сталь 35
Модуль упругости E, МПа | 2·10⁵
Коэффициент линейного расширения α·10⁻⁶, 1/°C | 12
Плотность ρ, г/см³ | 7,8
Твёрдость | 240НВ | 215НВ
Термообработка | поверхностная закалка
Предел прочности σв, МПа | 830 | 730
Предел текучести σт, МПа | 600 | 550

# 5.2 Расчёт допустимых напряжений

Расчётное число циклов нагружения определяется по формуле:

NН = 60·n·c·L,

где n — частота вращения зубчатого колеса;

c = 1 — число колёс, находящихся в зацеплении с рассчитываемым;

L — срок службы передачи.

N1 = 60·100·1·1800 = 4.3*10⁷

N2 = 60·100·1·1800/7.5 = 0.6*10⁷

Коэффициент долговечности определяется соотношением:

KFL=^m√((4·10^6)/(N_Н)),

где m = 6 — показатель степени для материалов с твёрдостью HB < 350 [2];

NН — расчётное число циклов нагружения.

При NН > 4·10⁶ принимают KFL = 1 [2]. Таким образом для каждой шестерни и для каждого колеса KFL = 1.

KFL1=⁶√((4·10^6)/(7.2∙10^7))=1

KFL2=⁶√((4·10^6)/(0.96∙10^7))=1

В таком случае можно определить допускаемое напряжение изгиба:

[σF]=(σFR·KFC·KFL)/(SF),

где σFR — предел выносливости при изгибе;

KFC = 0,65 — коэффициент, учитывающий цикл нагружения колеса для реверсивных передач;

KFL = 1 — коэффициент долговечности;

SF = 2,5 — коэффициент запаса прочности для особо ответственных передач.

Предел выносливости при изгибе рассчитывается из соотношения :

σFR=1,8·НВ, МПа

где HB — твёрдость материала колеса.

Допускаемые напряжения на изгиб для шестерен и колёс будут равны:

σFR1=432 МПа

σFR2=387 Мпа

[σF1]=(432*0.65*1)/2.5 = 112Мпа

[σF2]=(387*0.65*1)/2.5 = 100МПа

# 5.3 Расчёт зубчатых передач на изгибную прочность

Для открытых передач модуль зацепления определяется из изгибной прочности:

m=Km³√((M·YF·K)/(z·ψ_m ·[σF])),

где Km = 1,4 — коэффициент для прямозубых колёс [1];

M — крутящий момент, действующий на рассчитываемое колесо (по данным силового расчёта);

YF — коэффициент формы зуба для прямозубых цилиндрических колёс.

z — число зубьев рассчитываемого колеса;

K = 1,1 — коэффициент расчётной нагрузки [1];

ψm = 10 — коэффициент ширины зубчатого венца для мелкомодульных передач;

[σF] — допускаемое напряжение изгиба.

Для каждой передачи расчёт производится по тому зубчатому колесу (из пары шестерня – зубчатое колесо), для которого отношение YF/[σF] больше. Модуль зацепления для каждой пары колёс будет равен:

| 1 | 2
(Y_F)/([σ_F ]) | 4.15/112= 0.0371 | 3.73/100= 0.0373

Значение (Y_F)/([σ_F ]) больше для колеса номер 2 значит, расчёт модуля зацепления будет вестись по ним.

Тогда модули зацепления цилиндрических передач будут равны:

m_12 =1.4·³√((172 Н·мм·3.73·1.1)/(150·10·100 МПа))=0.24 мм

Значения модулей зацепления округляются в соответствии с ГОСТ 9563-60. Поскольку мы не учитываем динамический момент, то назначим модули колёс c запасом и выберем m12 = 0.5 мм.

# 6. Геометрический расчёт

Целью расчёта является определение основных размеров передач и их элементов.

Основные геометрические размеры цилиндрических зубчатых передач указаны на рисунке 2.


Рисунок 2 - Геометрические параметры цилиндрической зубчатой передачи

В данном приводе используются цилиндрические прямозубые передачи, поэтому угол наклона зубьев β = 0°.

Делительный диаметр определяется соотношением:

d=(m·z)/(cosβ),

где d — делительный диаметр;

m — модуль зацепления рассчитываемой пары колёс;

z — число зубьев рассчитываемого колеса;

β = 0° — угол наклона зубьев.

d_1 =0.5 мм·20=10.0 мм

d_2 =0.5 мм·150=75.0 мм

Диаметр вершин зубьев определяется по формуле:

da=(m·z)/(cosβ)+2m(h_a^(*) +x),

где da — диаметр вершин зубьев;

m — модуль зацепления рассчитываемой пары колёс;

β = 0° — угол наклона зубьев;

z — число зубьев;

h_a^(*) = 1 — коэффициент высоты головки зуба [1];

x = 0 — коэффициент смещения.

d_(a1) =10.0 мм+2·0.5 мм·(1+0)=11.0 мм

d_(a2) =75.0 мм+2·0.5 мм·(1+0)=76.0 мм

Диаметр впадин определяется по формуле:

df=(m·z)/(cosβ)-2m(h_a^(*) +c^(*) -x),

где df — диаметр впадин зубьев;

m — модуль зацепления рассчитываемой пары колёс;

z — число зубьев;

β = 0° — угол наклона зубьев;

h_a^(*) = 1 — коэффициент высоты головки зуба ;

c* = 0,25 — коэффициент радиального зазора 1.0 ≤ m ≤ 0,1 мм по ГОСТ 9587-81;

x = 0 — коэффициент смещения.

d_(f1) =10.0 м- 2·0.5 мм·(1+0.25+0)=8.75 мм

d_(f2) =75.0 мм-2·0.5 мм·(1+0.25-0)=73.75 мм

Окружной шаг определяется по формуле:

p=m·π ,

где p — окружной шаг;

m — модуль зацепления рассчитываемой пары колёс.

p_12 =0.5 мм*3.14=1.57 мм

Ширина колеса определяется по формуле:

bк=ψm·m,

где bк — ширина колеса;

ψm = 10 — коэффициент ширины зубчатого венца для мелкомодульных передач;

m — модуль зацепления рассчитываемой пары колёс.

Тогда ширина колёс будет равна:

b_2 = 6*0.5 мм=3 мм

Ширина шестерни определяется по формуле:

bш=bк+m,

где bш — ширина шестерни;

bк — ширина колеса;

m — модуль зацепления рассчитываемой пары колёс.

b_1 = 3+0.5 мм=3.5 мм

Межосевое расстояние определяется по формуле:

aω=(0,5·m·(zк+zш))/(cosβ),

где aω — делительное межосевое расстояние;

m — модуль зацепления рассчитываемой пары колёс;

zк — число зубьев колеса;

zш — число зубьев шестерни;

β = 0° — угол наклона зубьев.

aω12=0.5·0.5 мм·(20+75)=42.5 мм

В таблице 8 сведены все расчитанные геометрические параметры зубчатых колес

Таблица 8. Геометрические параметры зубчатых колес

Параметр № колеса | z | d, мм | da, мм | df, мм | b, мм | , мм
1 | 20 | 10 | 11 | 8.75 | 3.5 | 42.5
2 | 150 | 75 | 76 | 73.75 | 3

# 7. Проектный расчёт вала

Диаметр вала исходя из условия крутильной прочности определяется выражением:

d≥³√((M_(кр))/(0,2[τ]_(кр))),

где M_(кр) – крутящий момент на валу,

[τ]_(кр) – предельные крутильные напряжения:

[τ]_(кр) ≈0,56(σ_(-1))/n,

где σ_(-1) – предел выносливости при симметричном цикле нагружения,

n – коэффициент запаса.

Для изготовления вала выберем сталь 45 с σ_(-1) =412 МПа и коэффициент запаса n=2.

d_I ≥³√((0.026 Н·м)/(0.2·115 МПа))=1 мм

d_(II) ≥³√((0.172 Н·м)/(0.2·115 МПа))=1.9 мм

Выберем для d_(II) = 12 мм, поскольку это дано нам по условию, а на d_I = 5 мм, потому что это выходной вал двигателя.

# 8. Выбор подшипников

В качестве опор будет использоваться шарикоподшипники. Предварительный выбор шарикоподшипников будет осуществляться по диаметру цапфы. Предварительно диаметр цапфы для каждого вала можно определить из выражения

d_ц =d-(2..3)мм,

где d – диаметр вала.

Для выходного вала выберем подшипник: 1000099

Параметры подшипника : внутренний диаметр – 9 мм, наружный диаметр – 20 мм, высота – 6 мм, масса – 0,008 кг, грузоподъёмность статическая — 1050 Н, грузоподъёмность динамическая - 2680 Н.

# 9. Проектный расчёт муфты


Данный расчёт будет проводиться для предохранительной фрикционной муфты. Поставим эту муфту на 2 вал.

Предохранительный момент фрикционной муфты рассчитывается по следующей формуле:

М_(пр)^м =k∙М_(II) ,

где k – коэффициент запаса (k = 1,3)

М_(пр)^м =1,3∙0,172=0,224 Н∙м,

С другой стороны:

М_(пр)^м =М_(тр) ,

где Мтр – момент трения, рассчитывающийся по формуле:

М_(тр) =f_(тр) ∙F_2 ∙R_(пр) ,

где f –коэффициент трения в фрикционной паре (0,8 для пары сталь-металлокерамика без смазки [3]);

F2 – сила прижатия пружины;

R_(пр) =1/3∙(d^3 -d_0^3)/(d^2 -d_0^2),

где d – внешний диаметр фрикционного диска: (71 мм);

d=(3…6)d_(вала)

d0 – внутренний диаметр фрикционного диска (12 мм).
R_(пр) =1/3∙(71^3 -16^3)/(71^2 -16^2)=24.24 мм

Исходя из условий эксплуатации, выберем пружины II класса и 2 разряда. Их описывает ГОСТ 13771-86.

F_2 =1/n(М_(пр))/(f_(тр) ∙R_(пр) ∙10^(-3))=1/4(0,224)/(0,8∙24.24∙10^(-3))=2.84 Н

Где n – число пружин(4).

Сила пружины при максимальной деформации определяется соотношением:

F_3 =(F_2)/(1-δ) ,

где F_2 — сила пружины при рабочей деформации;

δ = 0,05…0,25 — относительный инерционный зазор пружины сжатия для пружин сжатия I и II классов.

Тогда:

F_3 =2.84/(1-0.05)…2.84/(1-0.25)=3…3.8

Найдём по ГОСТ 13771-86 подходящий виток.

Таблица 9. Основные параметры витка пружины

Из ГОСТ 13771-86 выберем подходящий виток по Fос: Виток №54
Fос , Н | d, мм | D, мм | C1, Н/м | S_3^(') , ММ
3,55 | 0.3 | 3,2 | 3,257 | 1,091


Средний диаметр пружины определяется соотношением:

D=D_1 -d,

где D_1 — наружный диаметр пружины;

d — диаметр проволоки.

Отсюда: D=3.2-0.3=2.9 мм

Индекс пружины определяется соотношением:

i =D/d ,

где D — средний диаметр пружины;

d — диаметр проволоки.

Отсюда:

i =2.9/(0,3)=9,67

Выберем рабочий ход h = 8 мм.

Тогда определим жёсткость пружины с:

c=(F_2 -F_1)/h=(3,17-0)/8=0,4Н/(мм)

Рабочее число витков пружины ищем:

n=(с_1)/с=3.257/(0,4)=8,25≃8,5

Уточнённая жёсткость пружины с*:

c^(*) =(с_1)/n=3.257/(8,5)=0,38 Н/мм

Пусть опорных витков n_2 =1,5 . Общее число витков определяется соотношением:

n_1 =n+n_2 ,

n_1 =8.5+1.5=10

Деформация пружины определяется соотношением:

s=(F_2)/c ,

Тогда предварительная деформация пружины:

s_1 =0/(0,38)=0

Рабочая деформация пружины:

s_2 =(3,17)/(0,38)=8,24 мм

Максимальная деформация пружины:

s_3 =(3,55)/(0,38)=9,23 мм

Длина пружины при максимальной деформации определяется по формуле:

l_3 =(n_1 +1-n_3 )∙d,

где n_1 — общее число витков;

n_3 =2 — число обработанных витков;

d — диаметр проволоки. Тогда:

l_3 =(10+1-2)∙0,3=2,7 мм

Длина пружины в свободном состоянии определяется по формуле:

l_0 =l_3 +s_3 ,

где l_3 — длина пружины при максимальной деформации;

Тогда:

l_0 =2.7+9.23=11.93 мм

Длина пружины при рабочей деформации определяется по формуле:

l_2 =l_0 -s_2 ,

где l_0 — длина пружины при максимальной деформации;

s_2 — рабочая деформация пружины.

Тогда:

l_2 =11.93-8.24=3.69 мм

Шаг пружины в свободном состоянии определяется по формуле:

t=s_3^(') +d,

где s_3^(') =1,091 мм — максимальная деформация одного витка пружины согласно;

d — диаметр проволоки.

Тогда:

t=1,091+0,3=1,391 мм.

# 10.Расчёт вида сопряжения

Выберем вид сопряжения из условия:

Jр≤Jn min

где jр — расчётное значение бокового зазора;

jn min — минимальное значение гарантированного бокового зазора для соответствующего вида сопряжения.

Расчётное значение бокового зазора определяется по формуле [1]:

Jр=J_n^t +Jс

где jр — расчётное значение бокового зазора;

j_n^t — боковой зазор, компенсирующий изменение рабочей температуре;

jс — боковой зазор, необходимый для размещения слоя смазки.

aw12 = 42,5мм Температурный диапазон из условий эксплуатации УХЛ4.1 Т = +1…+40 оС

Выбор материала:

Для зубчатых колёс – сталь Kтр = 12.4*10⁻⁶

Для корпуса – аллюминий Kтр = 22.2*10⁻⁶

При Т = +40 оС:

J^tn12 =0.684⋅42.5⋅[12.4⋅10^(-6) -22.2⋅10^(-6) ](40^о -20^о )=-5.7 мкм

J^tn12 = - 5.7 мкм

При Т = +1 оС

J^tn12 =0.684⋅42.5⋅[12.4⋅10^(-6) -22.2⋅10^(-6) ](1^о -20^о )=5,4 мкм

J^tn12 = 5.4 мкм

Для компенсации температурного диапазона +1…40°, необходим зазор

J^tn12 = 5.4 мкм

Значение зазора, необходимого для размещения смазки для быстроходных передач, определяется по формуле [1]:

Jс = 0.01 * m,

где m – модуль зацепления

Jс = 0.01 * 0.5 = 5 мкм

Тогда получим расчётное значение бокового зазора:

Jр=5.4+5=10,4 мкм


Назначим в соответствии с ГОСТ9178-81 вид сопряжения E.

# 11.Расчёт общей погрешности

# 11.1 Расчёт кинематической погрешности


Назначим 8 степень точности на зубатые колёса


Исходя их таблиц, подбираем значения допусков:

Допуски на кинематическую погрешность определяются по формуле:

F_i^(') =Fp+ff

где Fp — допуск на накопленную погрешность шага зубчатого колеса;

ff — допуск на погрешность профиля зуба.


F’i1 = Fp + ff = 19 + 9 = 28 мкм

Минимальное значение кинематической погрешности для передач 7-й степени точности определяется по формуле [1]:

F_(i0min)^(') =0,62·KS·Kφ·(F_(i1)^(') +F_(i2)^(') )

где KS — коэффициент фазовой компенсации;

Kφ — коэффициент учитывающий угол поворота ведомого колеса;

F’i2 = Fp + ff = 32 + 9 = 41 мкм

F’i0min12 = 0.71 * Ks * (F’i1+ F’i2) * Kφ= 0.71*0.99*(28+41)*1=48,5 мкм

φ2 >> 360, тогда Kφ12 = 1

Переведём получившиеся значения в угловые минуты.

Угловая погрешность элементарной передачи определяется по формуле:

Δφi0=6,88·(F_(i0)^('))/d

где F_(i0)^(') — кинематическая погрешность;

d — диаметр ведомого звена.

δφmin12 = (6.88*48.5)/75=4.4'

Теперь найдём максимальную кинематическую погрешность.

Максимальное значение кинематической погрешности определяется по формулам:

F_(i0max)^(') =K·Kφ·(√((F_(iш)^(') )^2 +E_(ΣM1)^2)+√((F_(iк)^(') )^2 +E_(ΣM2)^2)) ,

где K — коэффициент фазовой компенсации;

F_(iш)^(') и F_(iк)^(') — допуски на кинематическую погрешность шестерни и колеса;

Kφ — коэффициент учитывающий угол поворота ведомого колеса;

E_(ΣMш)^2 и E_(ΣMк)^2 =0— погрешности монтажа шестерни и колеса.

F’i0max12 = K * [ √(F’_(i1)^2 +0^2)+√(F’_(i2)^2 +0^2) ] * Kφ12 = 0.98*(28 + 41)*1 =67.6 мкм

Переведём получившиеся значения в угловые минуты:

δφmax12 = (6.88*67.6)/75=6.2'

# 11.2Расчёт погрешности мёртвого хода

Минимальная погрешность мёртвого хода определяется по следующей формуле

jt min=(jn min)/(cosα·cosβ)

где jn min — минимальное значение гарантированного бокового зазора соответствующей передачи;

α = 20° — угол исходного профиля колеса;

β = 0°— угол наклона боковой сто роны профиля.

Jtmin12 = (Jn12)/(cos20) = 30/cos20 = 31,9 мкм

Переведём в минуты:

Jφmin12 = (6.88*31.9)/75=2.9^(')


Максимальное значение мёртвого хода определяется по формуле:

jt max=0,7·(EHSш+EHSк)+√(0,5·(T_(Hш)^2 +T_(Hк)^2 )+2·f_a^2 +Δp_ш^2 +Δp_к^2)

где EHS — наименьшее смещение исходного контура зубчатого колеса;

TH — допуск на смещение исходного контура зубчатого колеса;

fa — допуск на отклонение межосевого расстояния передачи;

Δp — радиальный зазор в опорах зубчатого колеса.

Jtmax12 = 0.7(Ehs1+Ehs2) + √(0.5(Th1^2 +Th2^2 )+2fa^2 +Gr1^2 +Gr2^2) =

= 0.7(35 + 56)+ sqrt(0.5*(40^2+70^2) + 2*60^2 +0 + 13^2) =166,75 мкм

Теперь переведём в угловые минуты

Jφmax12 = (6.88*58.7)/75=15,3'

# 11.3Расчёт погрешности упругого мёртвого хода

Δφ=(2M_(kp) ⋅L)/(G⋅Ip)

где Mкр — крутящий момент на валу;

l — длина рабочего участка вала;

G = 8·10⁴ МПа — модуль упругости второго рода для стали;

Jp — полярный момент инерции сечения.

Полярный момент инерции определяется по формуле:

Jp≈0,1·d^4

где d — диаметр вала;

Произведём расчёт для всех валов:

Jp2 = 0.1 * 0.012⁴

Δφ_(II) =(2*0.172⋅0.11)/(8*10^4 *10^6 *0.1*0.012^4) = 2,3*10⁻⁴ рад

Δφ_I =0 рад.

В минутах:

Δφ_(II) =2,3*10^(-4) *180*60/3.1416=0,78'

Δφ_I =0

Δφ умх = 0,78'

# 11.4 Расчёт суммарной погрешности по методу минимумов максимумов

1) Суммарная кинетическая погрешность

δφ_Σ =δφ_(max12) =6,2'

2) Суммарная погрешность мёртвого хода

J_(φΣ) =1·J_(φmax12) =15,3'

Общая погрешность положения выходного вала ЭМП определённая по методу максимумов-минимумов задаётся выражением:

Δ_Σ =δφ_(ΣР) +δj_(ΣР) +Δφ_Σ^(΄) +Δφ_P^(ПР)

где δφ_(ΣР) — суммарная кинематическая по методу максимумов-минимумов;

δj_(ΣР) — суммарная погрешность мёртвого хода по методу максимумов-минимумов;

Δφ_Σ^(΄) — суммарная погрешность упругого мёртвого хода;

Δφ_P^(ПР) - приведённая погрешность шага двигателя.

Δφ_P^(ПР) = (Δφ_P)/(i_0)=(Δφ_P)/(i_0)=(5.4')/7.5 =0,72

Δ_Σ =6.2^(') +15,3^(') +0.78^(') +0,72^(') =23'

# 11.5 Погрешность передачи винт-гайка

Кинематическая погрешность:

F_(i0min)^(') =0,62∙δt_(∑) ; F_(i0min)^(') =0,62∙50=31мкм

F_(i0max)^(') =√(δt_(∑) ^2 +E_(∑M)^2); F_(i0max)^(') =√(50^2 +0)=50мкм

Где δt_(∑) - накопленная погрешность шага резьбы( δt_(∑) =50 мкм)

Погрешность мёртвого хода:

J_(tmin) =b^('') ⋅tgφ,

где b^('') - нижнее предельное отклонение среднего диаметра винта.

Из ГОСТ 9562-81 следует, что b^('') =180мкм

J_(tmin) =180⋅tg5.2=180∙tg5,2=16,4 мкм

J_(tmax) =b^(') ⋅tgφ+√(((b^('') -b^(') )∙tgφ)^2 +(btgφ)^2 +σ_(α1)^2 +σ_(α2)^2),

где b^(') =0 - верхнее предельное отклонение среднего диаметра винта;

b=236мкм - верхнее отклонение D_2 гайки;

J_(tmax) =0⋅tg5,2+√(((180-0)∙tg5,2)^2 +(236∙tg5,2)^2 +50^2)=56мкм

Суммарная погрешность передачи винт-гайка:

∆x_(В-Г) =J_(tmax) +F_(i0max)^(')

∆x_(В-Г) =56+50=106мкм

# 11.6 Общая погрешность

Переведем общую погрешность положения входного вала редуктора в общую погрешность положения каретки в мм:

Δх_р =(P∙Δ_Σ)/(z∙360∙60),

где P – шаг резьбы;

z – количество заходов резьбы;

Δ_Σ - общая погрешность положения выходного вала в минутах

Δх_р =(3∙23)/(1∙360∙60)= 3,1мкм

Общая погрешность положения каретки:

Δх_(∑) =Δх_р +∆x_(В-Г)

Δх_(∑) =3,1мкм+106мкм=109,1мкм

# 12.Проверочный силовой расчёт

1) Найдём уточнённое значение КПД передач

Уточнённые значения КПД цилиндрической зубчатой передачи рассчитаем по формуле:

η_(пер)^(*) =1-(πfCε_ν)/2(1/(z_1)+1/(z_2))

f–коэффициент трения

εν – коэффициент перекрытия, εν=1,5 (для приборостроения)

С- коэффициент нагрузки

C= (F+2.92)/(F+0.174)

где F=(2M)/d -окружная сила, действующая на зубчатое колесо.

Если F≥30 Н, то С=1

Произведём расчёт:

F =(2·M_(II))/(d_2)=(2·152)/75=4, 6 H=>c =(4,6+2.92)/(4,6+0.174)=1,58

η^(*) =1-π·f·ε_v ·c·0.5·(1/(z_1)+1/(z_2))

η_12^(*) =1-π·0.06·1.5·1.58·0.5·(1/20+1/150)=0.987

2) Найдём моменты инерций зубчатых колёс

J_2 =(π·b_2 ·ρ·d_2 ^4 ·10^(-12))/32=(π·5·7.8·75^4 ·10^(-12))/32=1,33·10^(-4) кг·м^2

J_1 =(π·b_1 ·ρ·d_1 ^4 ·10^(-12))/32=(π·5.5·7.8·10^4 ·10^(-12))/32=3,83·10^(-8) кг·м^2

3) Очевидно, что угловое ускорение имеет переменное значение по времени. Предположим, что максимальное значение угловое ускорение будет принимать в момент пуска двигателя.

Значение углового ускорения рассчитывается по формуле:

ε=(M_(ш.д.) -M_(ст.пр))/(J_(пр)^(*)),

где M_(ш.д.) =0,07Н∙м – момент шагового двигателя;

M_(с.пр)^(*) - приведённый уточнённый статический момент;

J_(пр)^(*) - приведённый момент инерции редуктора.

M_(с.пр)^(*) =(M_н)/(i_0 *η_(пер)^(*) *η_(подш))

η_(пер)^(*) =0.987

M_(с.пр)^(*) =(0,152∙10^3)/(7,5∙0.987∙0,99)=20,63Н∙мм

J_(пр)^(*) =J_p +J_(∑1) + J_(∑2) (J_2 +J_н)/(i_12^2)

где —момент инерции ротора, J_(∑ i) — суммарный момент инерции на валу двигателя.

J_(∑1) = J_1 =3,83·10^(-8) кг·м^2

J_(∑2) = (J_2 +J_(муфты) +J_н)/(i_12^2)

Где J_н – момент инерции нагрузки, J_(муфты) – момент инерции муфты

J_н =(m∙p∙z∙ϑ)/(2∙π),

Где m=0,15кг – масса каретки;

p – шаг резьбы:

z – число витков резьбы в каретке;

v – скорость движения каретки:

J_н =(0,150∙0,003∙5∙0,012)/(2∙π)=8.7∙10^(-7) кг∙м^2 ,

Момент инерции муфты примем равным моменту инерции зубчатого колеса, умноженному на коэффициент k. Выберем k = 2

J_(муфты) = J_2 *k=2,66·10^(-4) кг·м^2

J_(пр)^(*) =11∙10^(-7) +3,83∙10^(-8) +(3*1,33*10^(-4) +8.7∙10^(-7))/(7.5^2)=7,1∙10^(-6) кг∙м^2

ε=(0,07-0,02063)/(7,1∙10^(-6))=6.9∙10^3 (рад)/(с^2)

Уточнённый динамический приведённый момент рассчитывается по формуле:

M_(д.пр.)^(*) =J_(пр)^(*) ∙ε

M_(д.пр.)^(*) =7,1∙10^(-6) кг∙м^2 ∙6.9∙10^3 =0,04937 Н∙м

Проверим условие:

Mш.д. ≥ M_(с.пр)^(*) + M_(д.пр.)^(*) ,

70 Н·мм≥ 20,63 Н·мм+ 49,37 Н·мм

70 Н·мм≥ 70 Н·мм

Условие выполняется.

Значения уточнённых моментов на каждом валу:

ε_2 =ε/(i_0); ε_2 =(6.9∙10^3)/(7,5)=9,2∙10^2 (рад)/(с^2)

M_(II)^(*) =(( M_Н +J_н ∙ε_2 ))/(η_(подш))+ε_2 ∙(J_2 + J_(муфты) ),

M_(II)^(*) =(0,152+8,7∙10^(-7) ∙9,2∙10^2)/(0,99)+9,2∙10^2 ∙3∙ 1,33·10^(-4) =0,52 Н∙м

M_I^(*) =(M_(II)^(*))/(i_12 ∙η_12^(*) ∙η_(подш))+ε ∙(J_1 +J_р )

M_I^(*) =(M_(II)^(*))/(7.5∙0.987∙0.99)+9,2∙10^2 ∙(11∙10^(-7) +3,83·10^(-8) )=0,07 Н∙м

MII=0.172 Н·м M_(IIΣ)^(*) =0.52 Н·м

MI= 0.026 Н·м M_(IΣ)^(*) =0.070 Н·м

Вывод: видно, что полученные значения не совпадают со значениями в проектном расчёте, поэтому нужно проверить полученные значения модуля зубчатых колёс, диаметров валов и провести проектный расчёт муфты с новыми занчениями моментов. Выбранный в проектном расчёте двигатель FL28STH51-0956A походит.

# 13.Проверка значения модуля зубчатых колёс и диаметров валов.

модули зацепления цилиндрических передач будут равны:

m_12 =1.4·³√((0.52 Н·мм·3.73·1.1)/(150·10·100 МПа))=0.39 мм

Выбранный нами m = 0,5 мм, значит значение модуля зубчатых колёс менять не нужно.

Для изготовления вала выберем сталь 45 с σ_(-1) =412 МПа и коэффициент запаса n=2.

d_I ≥³√((0.07 Н·м)/(0.2·115 МПа))=1.4 мм

d_(II) ≥³√((0.52 Н·м)/(0.2·115 МПа))=2,8 мм

Выбранные диаметры валов также изменять не нужно.

Пересчёт муфты

Предохранительный момент фрикционной муфты рассчитывается по следующей формуле:

М_(пр)^м =k∙М_(II) ,

где k – коэффициент запаса (k = 1,1)

М_(пр)^м =1,1∙0 ,52=0,224 Н∙м,

С другой стороны:

М_(пр)^м =М_(тр) ,

где Мтр – момент трения, рассчитывающийся по формуле:

М_(тр) =f_(тр) ∙F_2 ∙R_(пр) ,

где f –коэффициент трения в фрикционной паре (0,8 для пары сталь-металлокерамика без смазки [3]);

F2 – сила прижатия пружины;

R_(пр) =1/3∙(d^3 -d_0^3)/(d^2 -d_0^2),

где d – внешний диаметр фрикционного диска: (71 мм);

d=(3…6)d_(вала)

d0 – внутренний диаметр фрикционного диска (12 мм).
R_(пр) =1/3∙(71^3 -16^3)/(71^2 -16^2)=24.24 мм

Исходя из условий эксплуатации, выберем пружины II класса и 2 разряда. Их описывает ГОСТ 13771-86.

F_2 =1/n(М_(пр))/(f_(тр) ∙R_(пр) ∙10^(-3))=1/4(0,224)/(0,8∙24.24∙10^(-3))=4,83 Н

Где n – число пружин(4).

Сила пружины при максимальной деформации определяется соотношением:

F_3 =(F_2)/(1-δ) ,

где F_2 — сила пружины при рабочей деформации;

δ = 0,05…0,25 — относительный инерционный зазор пружины сжатия для пружин сжатия I и II классов.

Тогда:

F_3 =(4,83)/(1-0.05)…(4,83)/(1-0.25)=5…6.4

Найдём по ГОСТ 13771-86 подходящий виток.

Таблица 9. Основные параметры витка пружины

Из ГОСТ 13771-86 выберем подходящий виток по Fос: Виток №87
Fос , Н | d, мм | D, мм | C1, Н/м | S_3^(') , ММ
5,60 | 0.36 | 3,4 | 5,876 | 0,954

Средний диаметр пружины определяется соотношением:

D=D_1 -d,

где D_1 — наружный диаметр пружины;

d — диаметр проволоки.

Отсюда: D=3.4-0.36=3,04 мм

Индекс пружины определяется соотношением:

i =D/d ,

где D — средний диаметр пружины;

d — диаметр проволоки.

Отсюда:

i =(3,04)/(0,36)=8,44

Выберем рабочий ход h = 8 мм.

Тогда определим жёсткость пружины с:

c=(F_2 -F_1)/h=(5,6-0)/8=0,7Н/(мм)

Рабочее число витков пружины ищем:

n=(с_1)/с=(5,876)/(0,7)=8,39≃8,5

Уточнённая жёсткость пружины с*:

c^(*) =(с_1)/n=(5,876)/(8,5)=0,69 Н/мм

Пусть опорных витков n_2 =1,5 . Общее число витков определяется соотношением:

n_1 =n+n_2 ,

n_1 =8.5+1.5=10

Деформация пружины определяется соотношением:

s=(F_2)/c ,

Тогда предварительная деформация пружины:

s_1 =0/(0,69)=0

Рабочая деформация пружины:

s_2 =(5,09)/(0,69)=7,36 мм

Максимальная деформация пружины:

s_3 =(5,60)/(0,69)=8,10 мм

Длина пружины при максимальной деформации определяется по формуле:

l_3 =(n_1 +1-n_3 )∙d,

где n_1 — общее число витков;

n_3 =2 — число обработанных витков;

d — диаметр проволоки. Тогда:

l_3 =(10+1-2)∙0,36=3,24 мм

Длина пружины в свободном состоянии определяется по формуле:

l_0 =l_3 +s_3 ,

где l_3 — длина пружины при максимальной деформации;

Тогда:

l_0 =3,24+8.10=11.34 мм

Длина пружины при рабочей деформации определяется по формуле:

l_2 =l_0 -s_2 ,

где l_0 — длина пружины при максимальной деформации;

s_2 — рабочая деформация пружины.

Тогда:

l_2 =11.34-7,36=3.99 мм

Шаг пружины в свободном состоянии определяется по формуле:

t=s_3^(') +d,

где s_3^(') =0,954 мм — максимальная деформация одного витка пружины согласно;

d — диаметр проволоки.

Тогда:

t=0,954+0,36=1,314 мм.

# 14.Проверочный расчёт на перегрузки

Расчет производится по следующим формулам:

σ_F ·K_п ≤[σ_(изг) ]_(max)

K_п =(M_(пуск))/(M_(I∑))

[σ_(изг) ]_(max) ≈0,8∙σ_т

σ_(изг) =(2∙M∙Y_F ∙K)/(z∙ψ_m ∙m^3)

Для стали 45: σ_T =355 МПа, [σ_(изг) ]_(max) ≈0,8·355=284 - у шестерней

Для стали 35: σ_T =315 МПа, [σ_(изг) ]_(max) ≈0,8·315=252 - у колёс

K_п =(M_п)/(M_(IΣ))=0.070/0.070=1

K_п ·σ_p ≤[σ_(изг) ]_(max) ≈0,8·σ_T

K_п ·σ_(p1) =1·(2·39 ·4.15·1.4)/(20·10·0.9^3)=31 МПа

K_п ·σ_(p2) =1·(2·258·3.73·1.4)/(88·10·0.9^3)=19 МПа

σ_н = Z_M Z_Н Z_ε √((K∙M_2 ∙(1+ i_12 )^2)/(d_2 ∙b∙a_ω ∙i_12))

Где z_H =1,77 – коэффициент, учитывающий форму соприкасающихся поверхностей

z_M - коэффициент, учитывающий механические свойства материала

z_ξ =0,9 – коэффициент, учитывающий влияние торцевого перекрытия.

√K∙σ_н ≤[σ_н ]_(max)

[σ_н ]_(max) ≈2.8∙σ_T =2.8∙315=882 МПа

√K∙σ_(н12) = √1∙ 190∙1.77∙0.9√((1.4∙258∙(1+ 7,5)^2)/(75∙10^(-3) ∙5∙10^(-3) ∙42,5∙10^(-3) ∙7,5))=496 МПа

K_п ·σ_(p1) <284 МПа

K_п ·σ_(p2) <252 МПа

√K∙σ_(н12) < 882 МПа

Вывод: выбранные материалы проходят данный расчёт, значит ничего менять в конструкции не надо.

# 15. Проверочный расчёт резьбы при срезе

Расчёт ведётся по формуле:

τ_(кр) ≤[τ_(кр) ]=0.2∙σ_в

Для стали 45, из которой сделан винт, σв = 840 МПа

[τ_(кр) ]=730*0.2=168МПа

τ_(кр) = (F_α)/(π*d_3 *z*b)

Где F_α – осевая сила ( F_α =150Н) ;

d_3 - внутренний диаметр резьбы (d3 = 8,5);

z – число витков резьбы в каретке (z = 5);

b – толщина витка резьбы при основании резьбы (b = 0.644*p = 0.644*0.003 = 0.002).

τ_(кр) = 150/(π*0.0085*5*0.002)=0.56МПа

Условие τ_(кр) ≤[τ_(кр) ] выполняется, значит расчёт пройден. В других проверочных расчётах нет надобности так как винт спроектирован так, чтобы заведомо их пройти.

# 15. Проверочный расчёт пружины на прочность

Расчёт ведётся по формуле:

τ_3 ≤[τ_3 ] τ_3 =K(8*F_3 *D)/(π*d^3)

Где K= (4*i-1)/(4*i-4)-0.65/i – коэффициент, учитывающий кривизну витков пружины (i = 9,67).

K= (4*9.67-1)/(4*9.67-4)-0.65/9.67= 1.02

τ_3 =K(8*3.55*2.9)/(π*0.3^3)=790 Н/мм^2

τ_3 ≤[τ_3 ]

По ГОСТ 9389-75 для проволоки с d = 0.3мм Rm = 3040 Н/мм²

Согласно ГОСТ 13764-86 для пружин II класса

[τ_3 ]=0.52Rm=1580 Н/мм^2

Условие τ_3 ≤[τ_3 ] выполняется, значит выбранный упругий элемент проходит этот расчёт. Вносить изменения в конструкция нет необходимости.

# 17. Проверочный расчёт вала.

Проведём расчёт в САПР системе SolidWorks.

Выберем материал

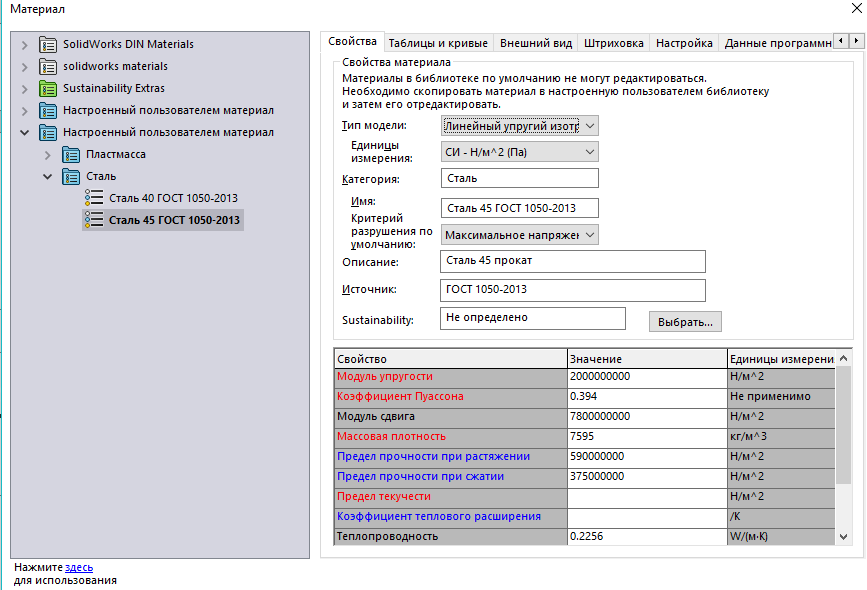
[picture p62: figure]

Настроим крепления – поставим подшипники на цапфы.

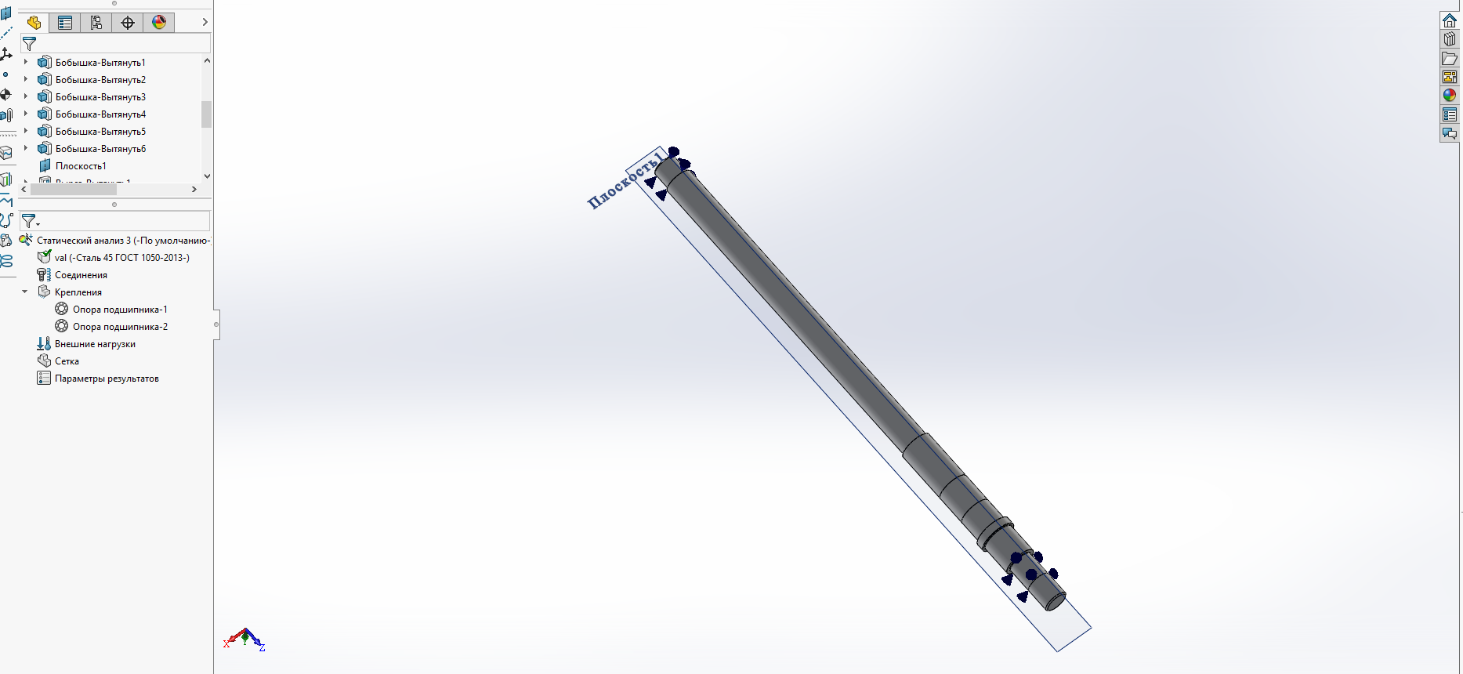
[picture p63: figure]

\

Нагрузим участок вала со шпонкой моментом M_(IIΣ)^(*) =0.52 Н·м .

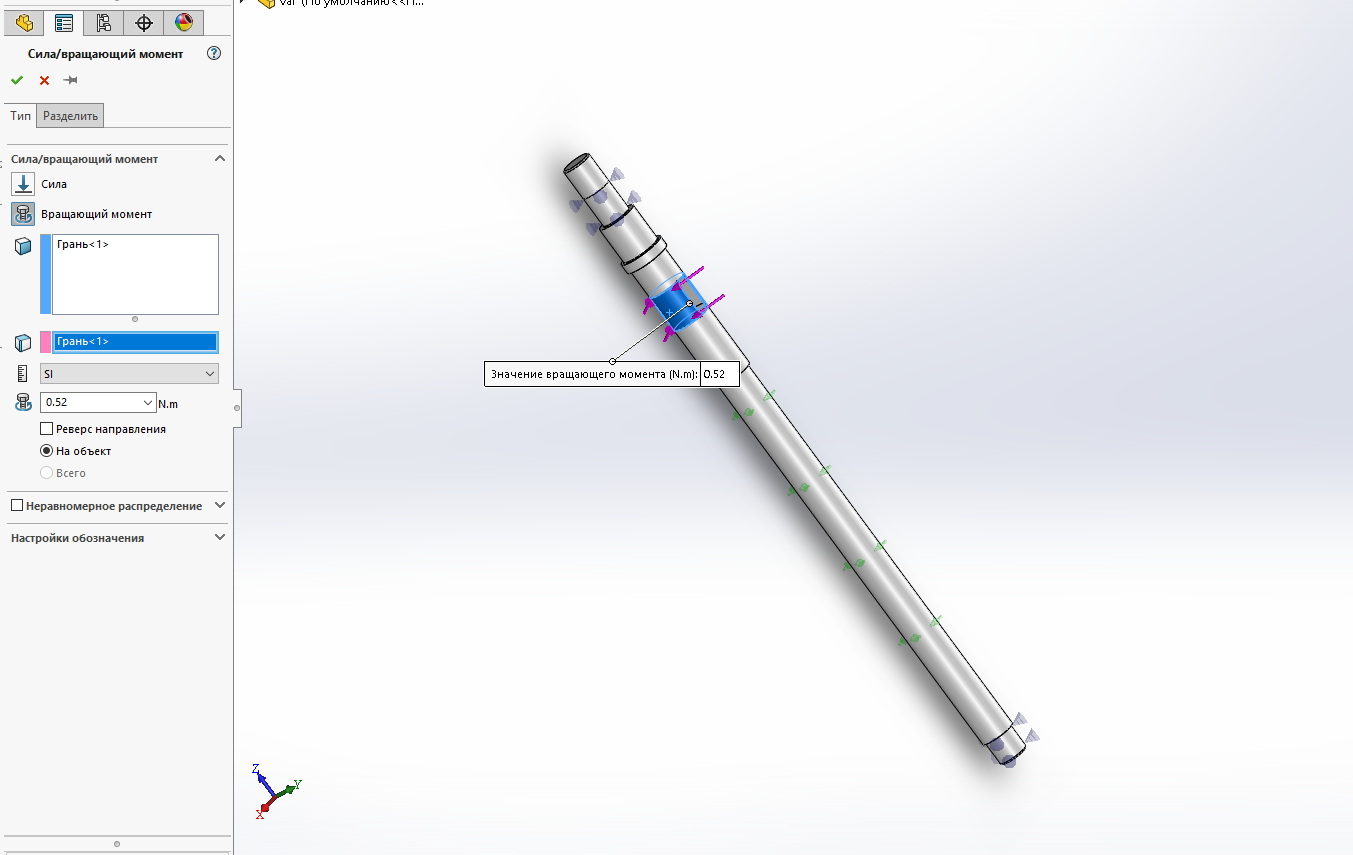
[picture p64: figure]

Запустим симуляцию.

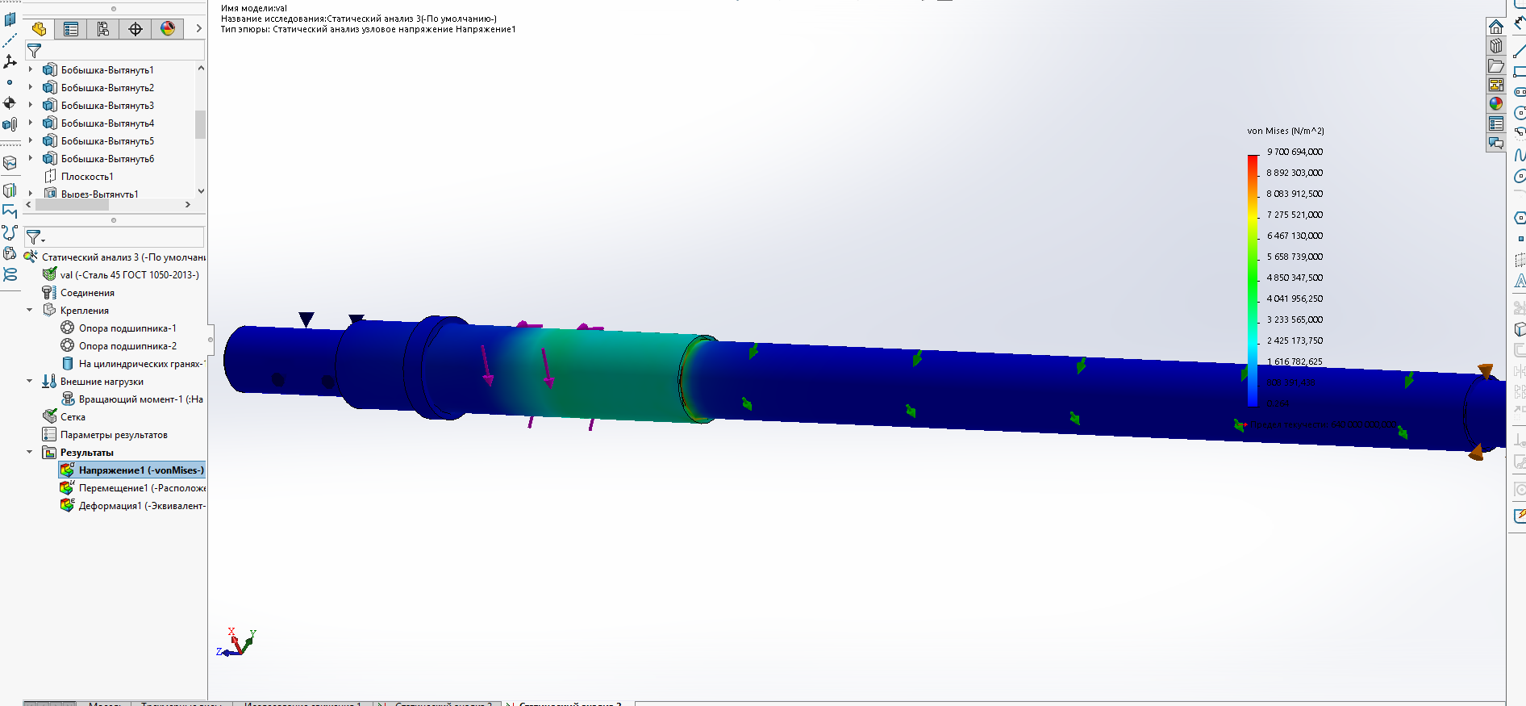
[picture p65: figure]

Видно, что опасное сечение находится в месте, где начинается резьба.

Увеличим в этом месте сетку

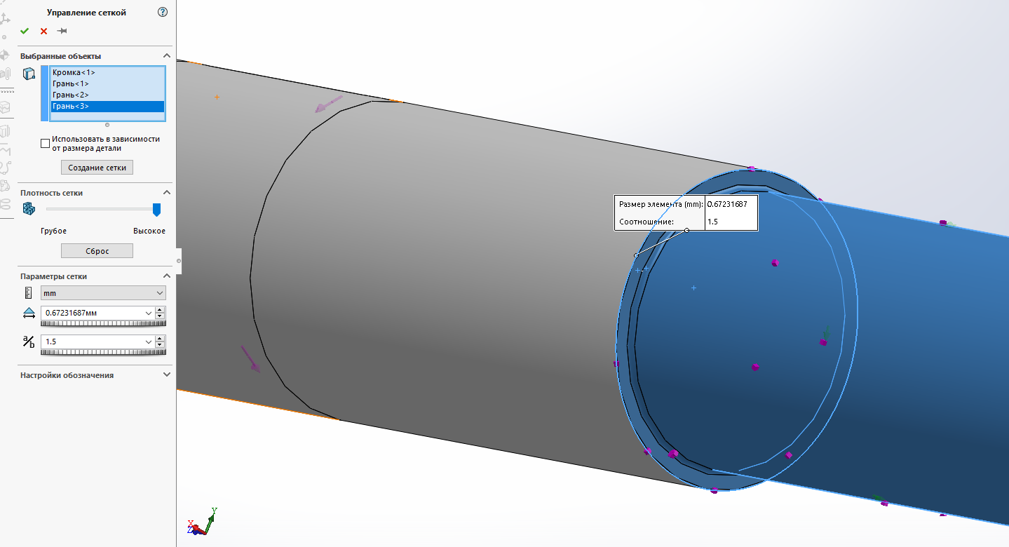
[picture p66: figure]

Запустим ещё раз симуляцию

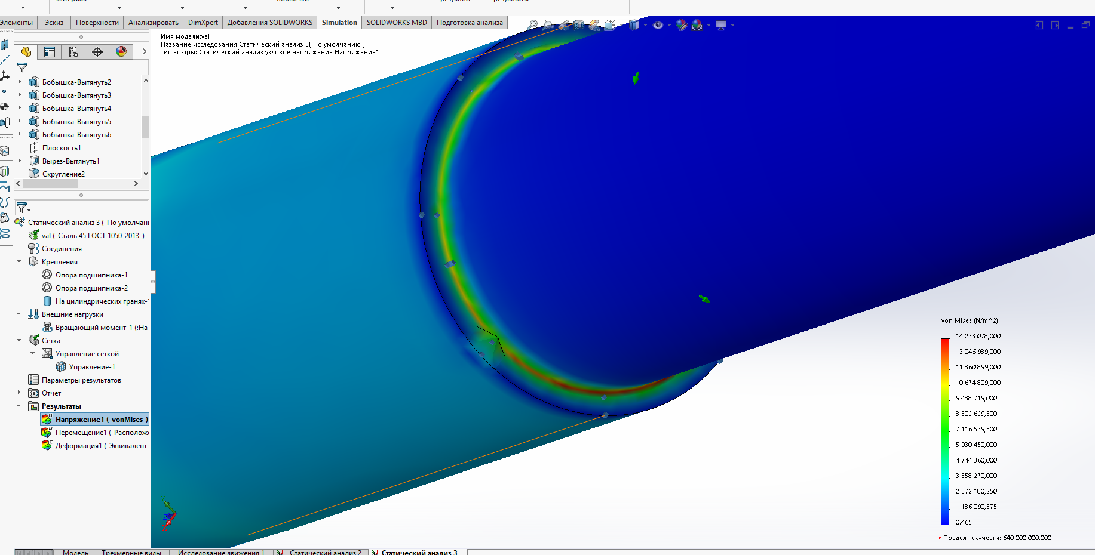
[picture p67: figure]
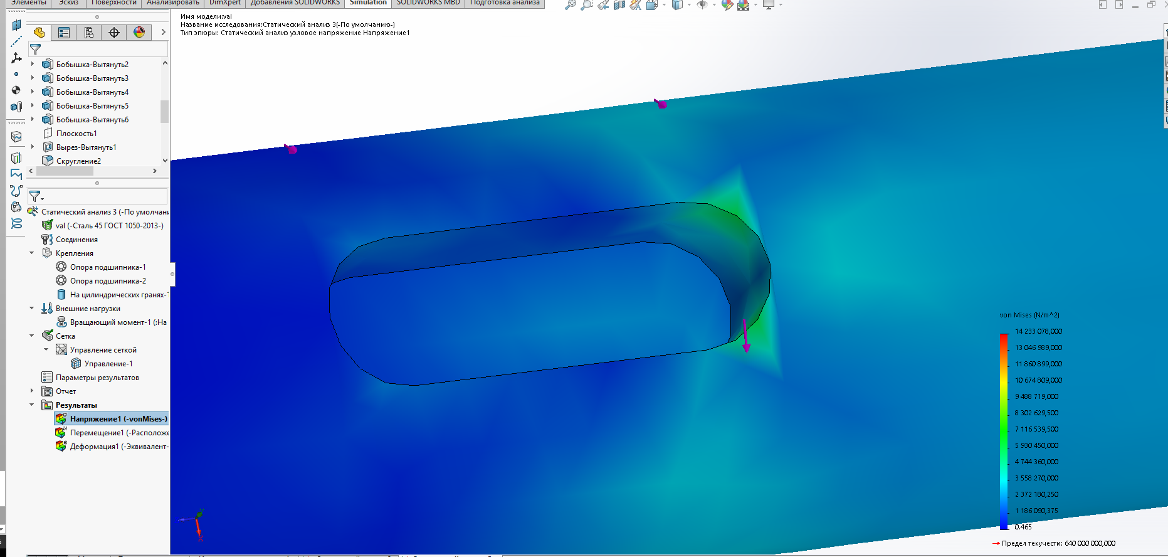
[picture p68: figure]

Вывод: максимальной напряжений σ_(max) = 14.8МПа, а σ_0.2 = 640МПа. Следовательно вал удовлетворяет условиям прочности с большим запасом.

# 18.Расчёт опор качения по динамической грузоподъемности.

Рассчитаем значения радиальной и осевой силы:

F_(окр) = (M_(II)^(*))/(75/2)= 520/(37,5)=13,87 Н

F_r = (F_(окр) *tgα)/(cosβ)= 5,07 Н

F_(ос) =F_(окр) *tgβ = 0 Н

Динамическую радиальную грузоподъёмность рассчитаем по формуле:

C_r = 2680 Н

Из паспорта.

Динамическая радиальная эквивалентная нагрузка подшипников рассчитывается по формуле:

P_r =X*F_r +Y*F_(ос) X = 1, Y = 0 ГОСТ 18855-2013

P_r =5,07 Н

Поскольку P_r < C_r то, номинальный ресурс вычисляем по формуле:

L_10 =((C_r)/(Р_r))^3 =10000 ч.

# Приложения

# Список литературы.

1. Кокорев Ю.А., Жаров В.А., Торгов А.М. Расчет электромеханического привода. Изд-во МГТУ, 1995, 132 с.

2. Расчет деталей машин на ЭВМ. Под ред. Решетова Д.Н. Высш. Школа, 1985.

3. И.С. Потапцев, А.А. Буцев, Е.В.Матвеенко Расчёт и конструирование элементов приборных устройств Конструирование приборных муфт. Издательство МГТУ им. Н.Э.Баумана, 2001
