orku/course_project_dmm/с одной зубчатой передчей/печать на консу 08.05.2020/Спецификация Шестаков А, А, СМ11-61Б.pdf

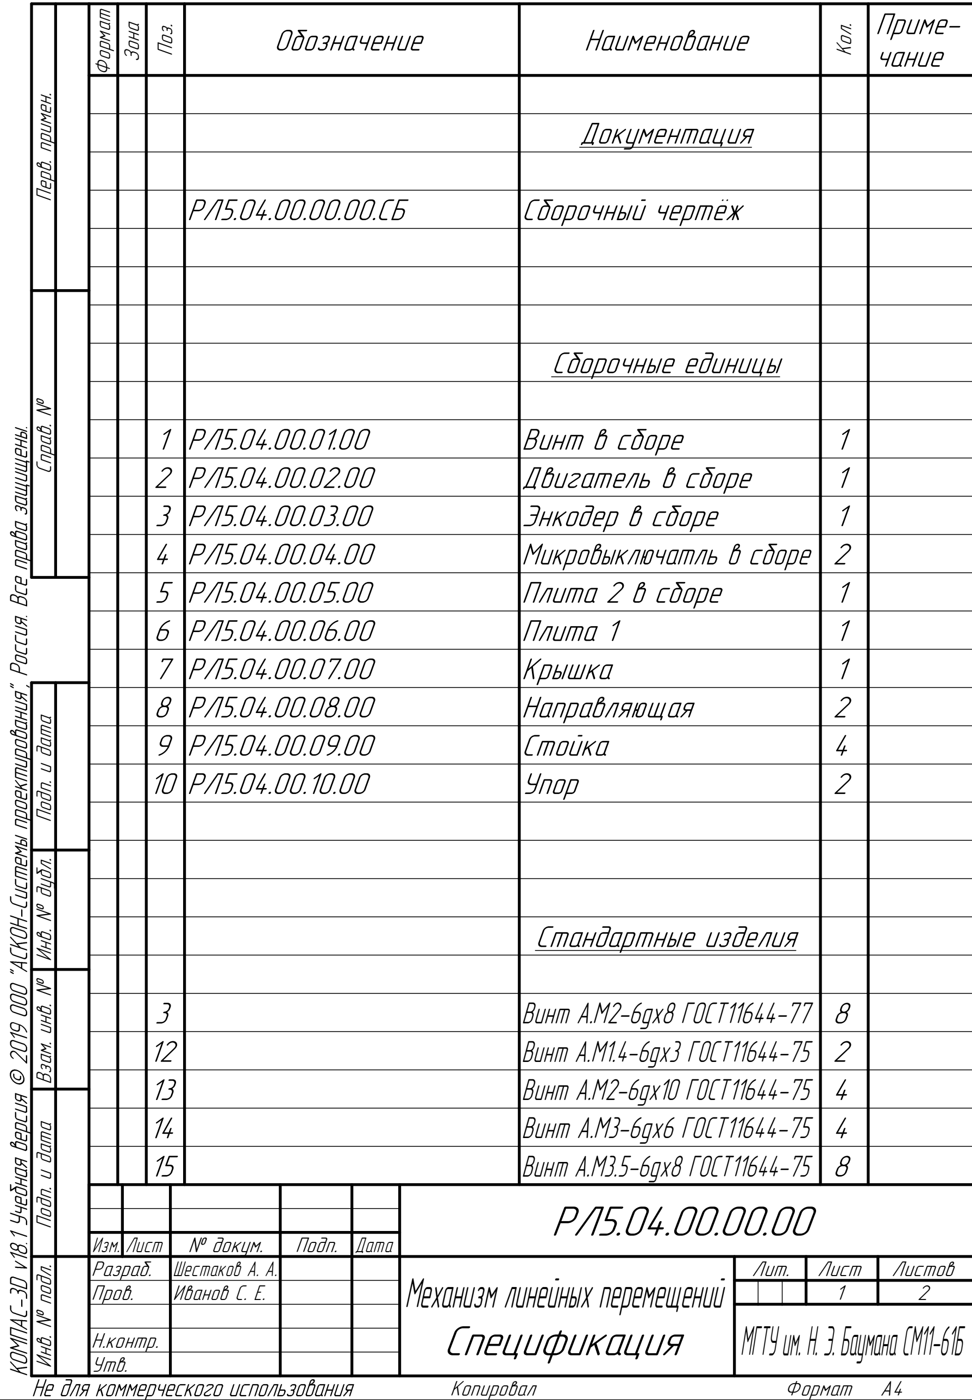
[picture p101: figure]
Изм. Лист; № докум.; Подп.; Дата; Разраб.; Шестаков А. А.; Механизм линейных перемещений Спецификация; Лит.; Лист; Листов; Пров.; Иванов С. Е.; Н.контр.; Сборочный чертёж; Сборочные единицы; Винт в сборе; Двигатель в сборе; Энкодер в сборе; Микровыключатль в сборе; Плита 2 в сборе; Плита 1; Крышка; Направляющая; Стойка; Упор; Стандартные изделия; Винт А.М2-6gx8 ГОСТ11644-77; Винт А.М1.4-6gx3 ГОСТ11644-75; Винт А.М2-6gx10 ГОСТ11644-75; Винт А.М3-6gx6 ГОСТ11644-75; Зона; 15 Поз.; Обозначение; Винт А.М3.5-6gx8 ГОСТ11644-75 Наименование; 8 Формат Кол.; Приме-; чание; Копировал; Формат A4

Утв. | МГТУ им. Н. Э. Баумана СМ11-61Б Инв. № подл. Подп. и дата Взам. инв. № Инв. № дубл. Подп. и дата Справ. № Перв. примен. | Документация

РЛ5.04.00.00.00 | Лист

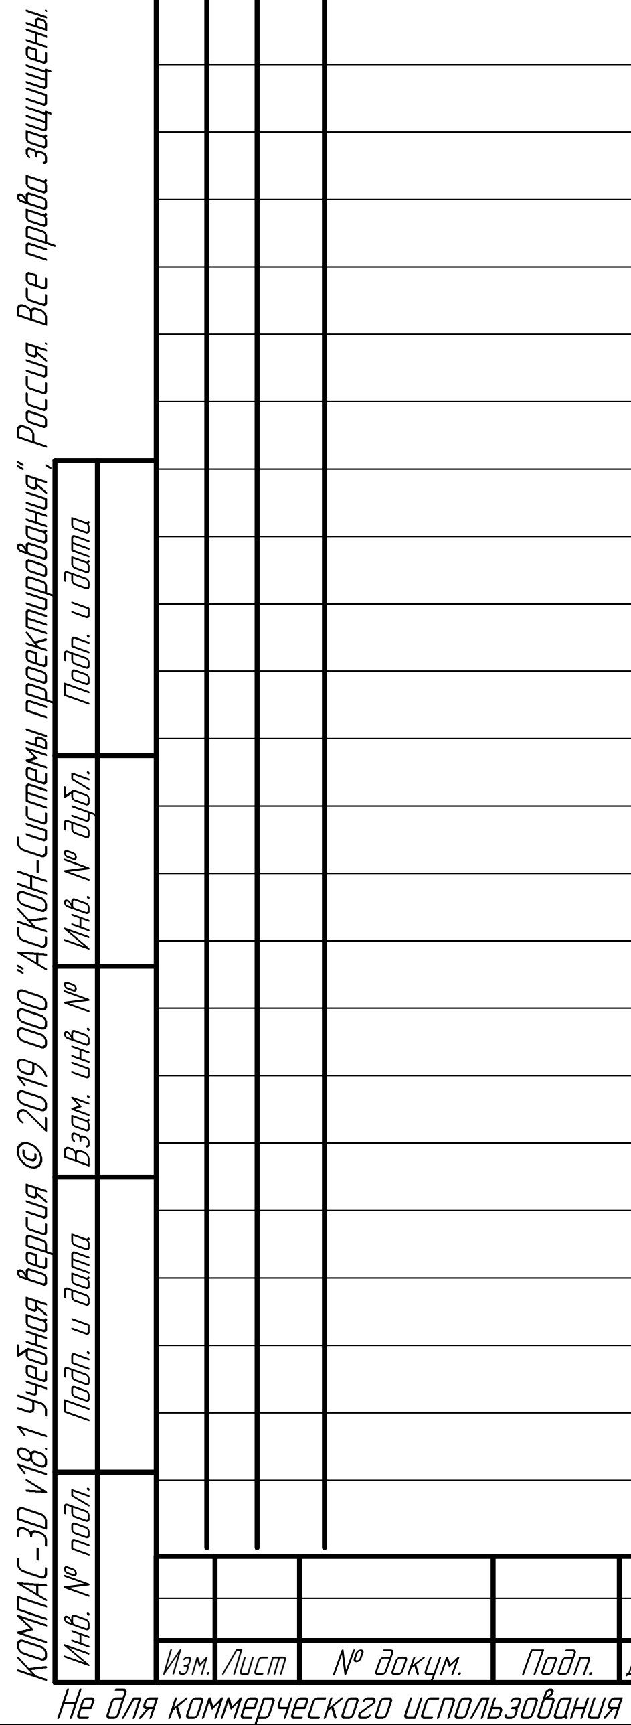
[picture p102: figure]

2 Инв. № подл. Подп. и дата Взам. инв. № Инв. № дубл. Подп. и дата | Изм. Лист | № докум. | Подп. | Дата
Зона | 18 Поз. | Обозначение | Гайка М2 шестигранная низкая ГОСТ 4036 Наименование | 4 Формат Кол. | Приме-чание
| 16 | | Шайба М2 ГОСТ 6978-58 | 4
| 17 | | Шайба М3 ГОСТ 6978-58 | 8
Копировал | Формат A4
