orku/course_project_dmm/с одной зубчатой передчей/мусор/Спецификация.pdf

| РЛ5.04.00.00.00

Спецификация

Изм. Лист | № докум. | Подп. | Дата Разраб. | Шестаков А, А, | Механизм линейных перемещений
Лист | Листов Пров. | Иванов С. Е. | Лит. | 1 | 2
Н.контр. Утв. | МГТУ им. Н. Э. Баумана СМ11-61Б Инв. № подл. Подп. и дата Взам. инв. № Инв. № дубл. Подп. и дата Справ. № Перв. примен. | Документация РЛ5.04.00.00.00.СБ | Сборочный чертёж

Сборочные единицы

РЛ5.04.00.01.00 | Винт в сборе | 1 РЛ5.04.00.02.00 | Двигатель в сборе | 1 3 РЛ5.04.00.03.00 | Энкодер в сборе | 1 РЛ5.04.00.04.00 | Микровыключатель в сборе 2
РЛ5.04.00.05.00 | Плита 2 в сборе | 1 РЛ5.04.00.06.00 | Плита 1 | 1 РЛ5.04.00.07.00 | Крышка | 1 РЛ5.04.00.08.00 | Направляющая | 2
9 РЛ5.04.00.09.00 | Стойка | 4
РЛ5.04.00.10.00 | Упор | 2

Стандартные изделия

11 | Винт А.М2-6gx8 ГОСТ11644-77 8
12 | Винт А.М1.4-6gx3 ГОСТ11644-75 2
13 | Винт А.М2-6gx10 ГОСТ11644-75 4
14 | Винт А.М3-6gx8 ГОСТ11644-75 4
15 | Винт А.М3.5-6gx8 ГОСТ11644-75 8 Поз. | Обозначение | Наименование | Кол. | Приме-
чание
Копировал | Формат A4

10

8

7

6

54

2

1

РЛ5.04.00.00.00 | Лист
2 Инв. № подл. | Изм. Лист № докум. | Подп. Дата Подп. и дата Взам. инв. № Инв. № дубл. Подп. и дата | 16 | Шайба М2 ГОСТ 6978-58 4
17 | Шайбка М3.5 ГОСТ 6978-58 8
18 | Гайка М2 шестигранная низкая ГОСТ 4036 4 Поз. | Обозначение | Наименование | Кол. | Приме-
чание
Копировал | Формат A4

ВЫПОЛНЕНО В СТУДЕНЧЕСКОЙ ВЕРСИИ ПРОГРАММЫ AUTODESK ВЫПОЛНЕНО В СТУДЕНЧЕСКОЙ ВЕРСИИ ПРОГРАММЫ AUTODESK

РЛ5.04.00.00.00
Изм. Лист | № докум. | Подп. | Дата Разраб. | Шестаков А, А, | Механизм линейных перемещений

## Спецификация

Лист | Листов Пров. | Иванов С. Е. | Лит. | 1 | 2
Н.контр. Утв. | МГТУ им. Н. Э. Баумана СМ11-61Б Инв. № подл. Подп. и дата Взам. инв. № Инв. № дубл. Подп. и дата Справ. № Перв. примен. | Документация РЛ5.04.00.00.00.СБ | Сборочный чертёж

Сборочные единицы

РЛ5.04.00.01.00 | Винт в сборе | 1
РЛ5.04.00.02.00 | Двигатель в сборе | 1
3 РЛ5.04.00.03.00 | Энкодер в сборе | 1
РЛ5.04.00.04.00 | Микровыключатель в сборе | 2
РЛ5.04.00.05.00 | Плита 2 в сборе | 1
РЛ5.04.00.06.00 | Плита 1 | 1
РЛ5.04.00.07.00 | Крышка | 1
РЛ5.04.00.08.00 | Направляющая | 2
9 РЛ5.04.00.09.00 | Стойка | 4
РЛ5.04.00.10.00 | Упор | 2

Стандартные изделия

11 | Винт А.М2-6gx8 ГОСТ11644-77 | 8
12 | Винт А.М1.4-6gx3 ГОСТ11644-75 | 2
13 | Винт А.М2-6gx10 ГОСТ11644-75 | 4
14 | Винт А.М3-6gx8 ГОСТ11644-75 | 4
15 | Винт А.М3.5-6gx8 ГОСТ11644-75 | 8 Поз. | Обозначение | Наименование | Кол. | Приме-
чание
Копировал | Формат A4

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
ВЫПОЛНЕНО В СТУДЕНЧЕСКОЙ ВЕРСИИ ПРОГРАММЫ AUTODESK ВЫПОЛНЕНО В СТУДЕНЧЕСКОЙ ВЕРСИИ ПРОГРАММЫ AUTODESK

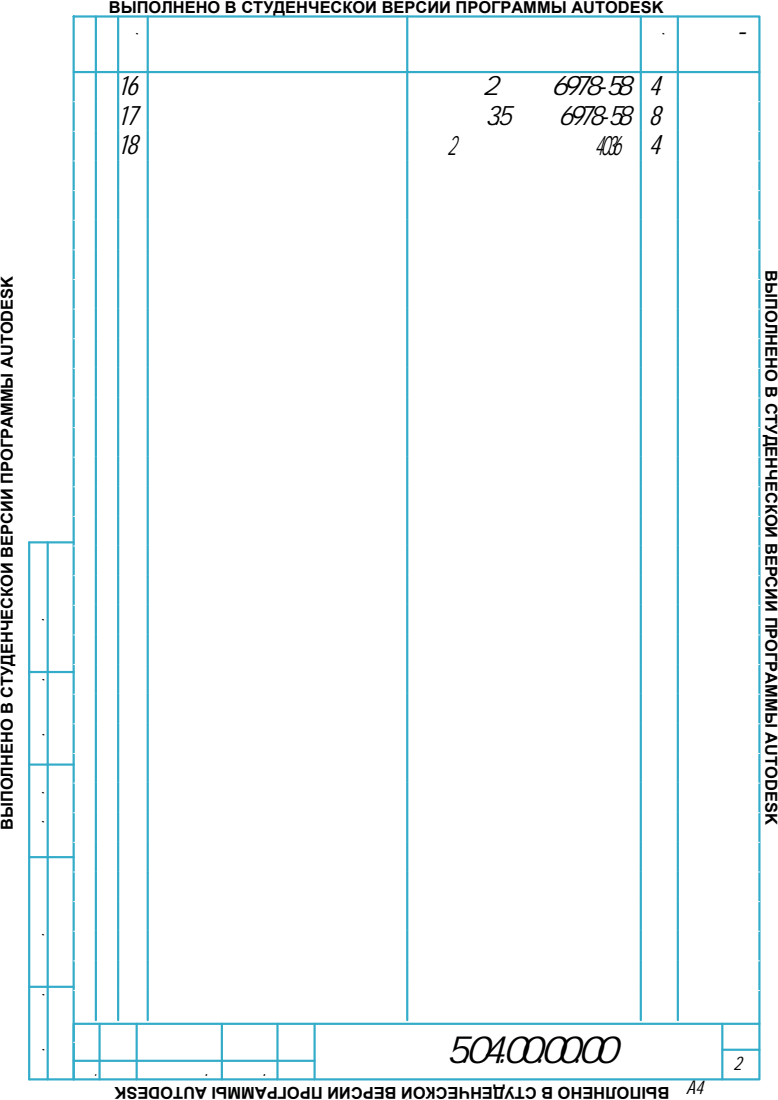
[picture p103: page 3]
2 Инв. № подл.; Изм. Лист; № докум.; Подп.; Дата Подп. и дата Взам. инв. № Инв. № дубл. Подп. и дата; Гайка М2 шестигранная низкая ГОСТ 4036; 4 Поз.; Обозначение; Наименование; Кол.; Приме-; Копировал; Формат A4

ВЫПОЛНЕНО В СТУДЕНЧЕСКОЙ ВЕРСИИ ПРОГРАММЫ AUTODESK

16 | Шайба М2 ГОСТ 6978-58 | 4
17 | Шайбка М3.5 ГОСТ 6978-58 | 8
