orku/course_project_dmm/с одной зубчатой передчей/финишная прямая/на защиту/Спецификация винт в сборе.pdf

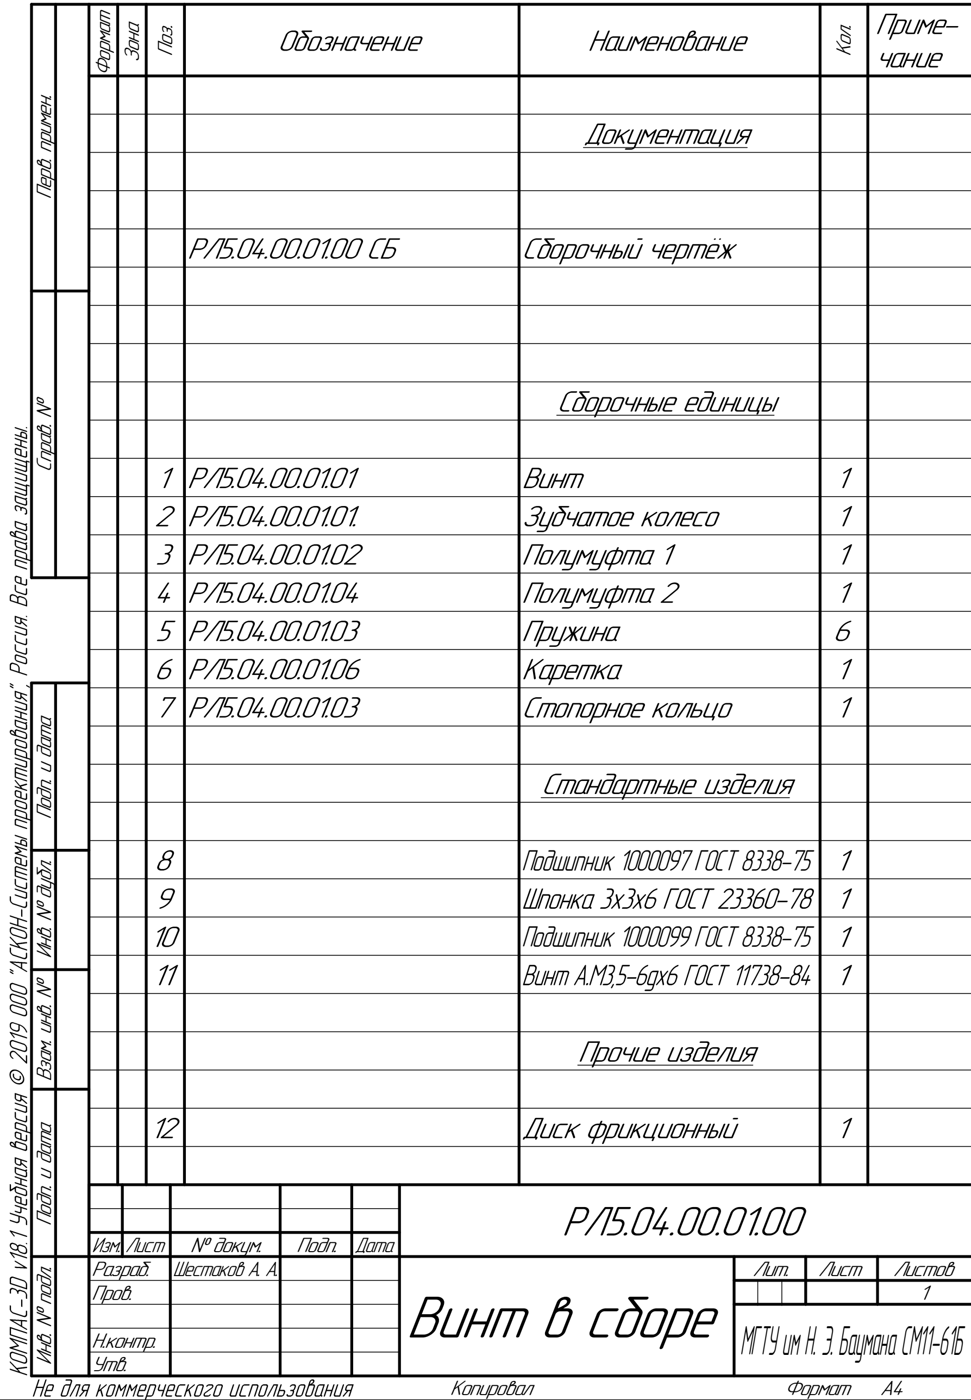
[picture p104: figure]
Изм. Лист; № докум.; Подп.; Дата; Разраб.; Шестаков А. А.; Винт в сборе; Лит.; Лист; Листов; Пров.; Н.контр.; Сборочный чертёж; Сборочные единицы; Винт; Зубчатое колесо; Полумуфта 1; Полумуфта 2; Пружина; Каретка; Стопорное кольцо; Стандартные изделия; Подшипник 1000097 ГОСТ 8338-75; Шпонка 3х3х6 ГОСТ 23360-78; Подшипник 1000099 ГОСТ 8338-75; Винт А.М3,5-6gx6 ГОСТ 11738-84; Прочие изделия; Диск фрикционный; 1 Формат; Зона; Поз.; Обозначение; Наименование; Кол.; Приме-; чание; Копировал; Формат A4

Утв. | МГТУ им Н. Э. Баумана СМ11-61Б Инв. № подл. Подп. и дата Взам. инв. № Инв. № дубл. Подп. и дата Справ. № Перв. примен. | Документация
