orku/course_project_dmm/с одной зубчатой передчей/финишная прямая/на защиту/Спецификация к двигатель в сборе.pdf

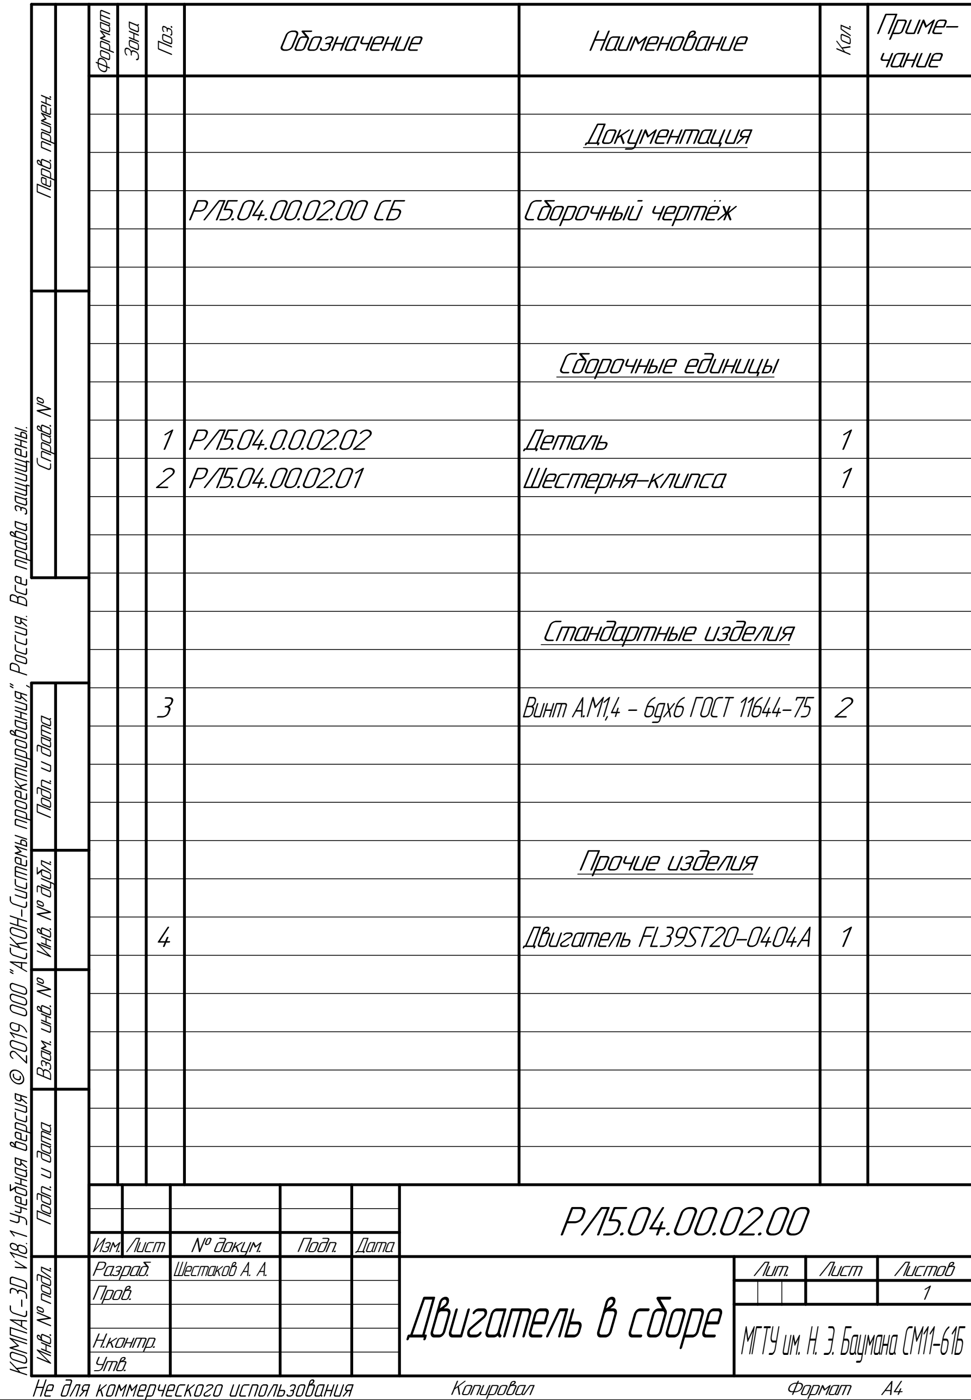
[picture p105: figure]
Изм. Лист; № докум.; Подп.; Дата; Разраб.; Шестаков А. А.; Двигатель в сборе; Лит.; Лист; Листов; Пров.; Н.контр.; Сборочный чертёж; Сборочные единицы; Деталь; Шестерня-клипса; Стандартные изделия; Винт А.М1,4 - 6gx6 ГОСТ 11644-75; Прочие изделия; Зона; 4 Поз.; Обозначение; Двигатель FL39ST20-0404A Наименование; 1 Формат Кол.; Приме-; чание; Копировал; Формат A4

Утв. | МГТУ им. Н. Э. Баумана СМ11-61Б Инв. № подл. Подп. и дата Взам. инв. № Инв. № дубл. Подп. и дата Справ. № Перв. примен. | Документация
