orku/course_project_dmm/с одной зубчатой передчей/финишная прямая/на защиту/Спецификация сборочный чертёж.pdf

Утв. | МГТУ им. Н. Э. Баумана СМ11-61Б Инв. № подл. Подп. и дата Взам. инв. № Инв. № дубл. Подп. и дата Справ. № Перв. примен. | Документация
РЛ5.04.00.00 СБ | Сборочный чертёж

Сборочные единицы

Зона | 15 Поз. 1 РЛ5.04.00.01.00 | Обозначение | Винт А.М1.4-3gx8 ГОСТ11644-75 Наименование Винт в сборе | 2 Формат Кол. 1 | Приме-
чание

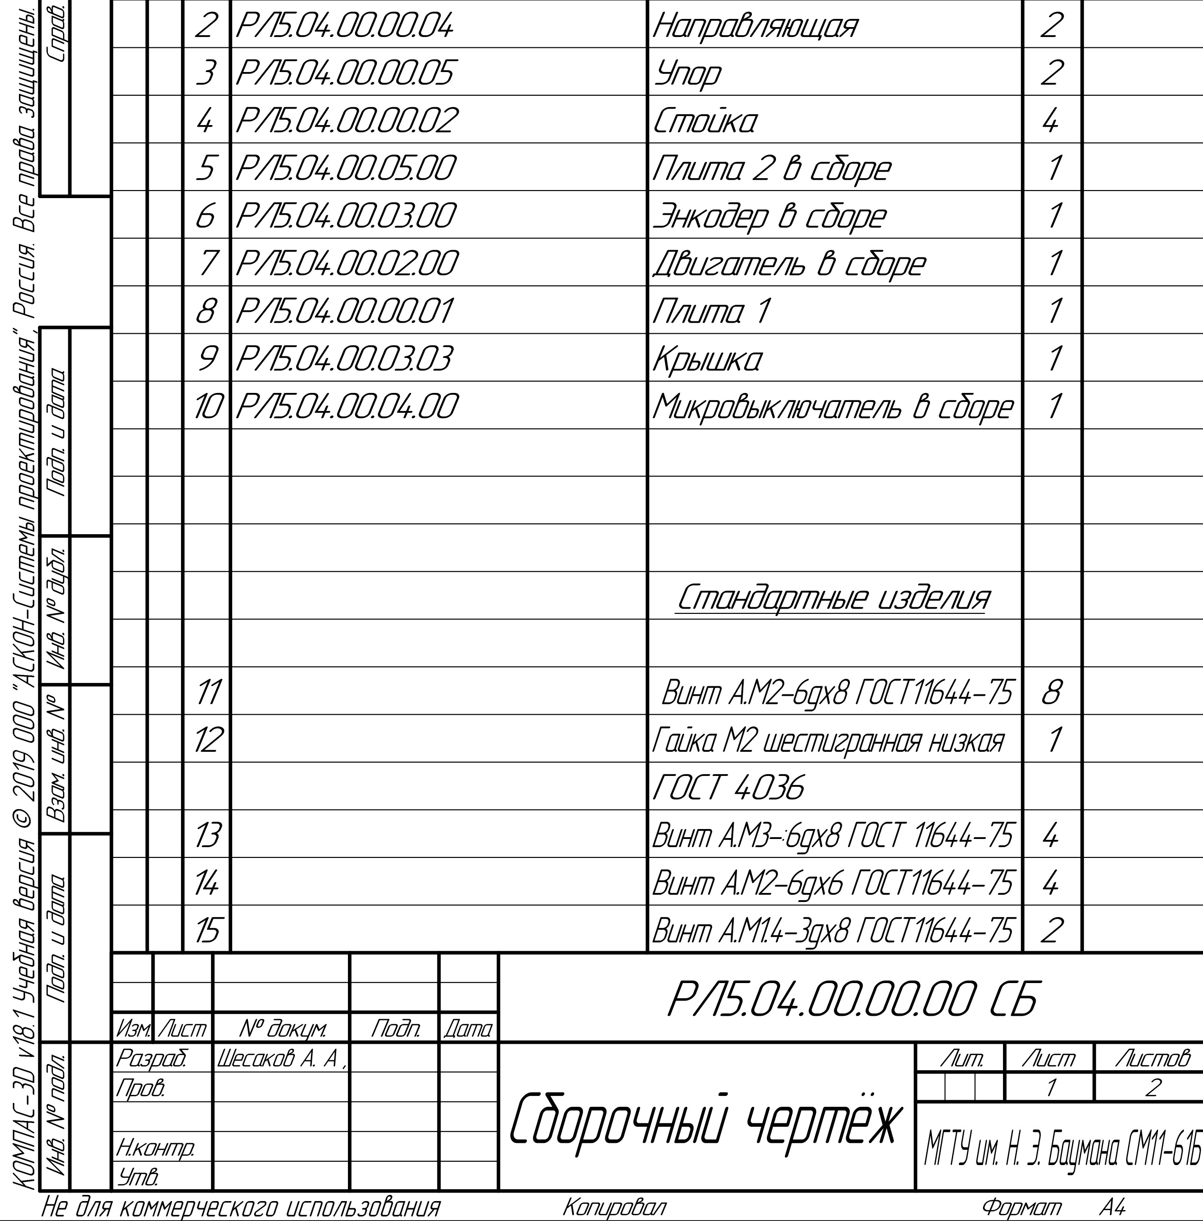
[picture p106: figure]
Изм. Лист; № докум.; Подп.; Дата; Разраб.; Шесаков А. А ,; Сборочный чертёж; Лит.; Лист; Листов; Пров.; Н.контр.; Направляющая; Упор; Стойка; Плита 2 в сборе; Энкодер в сборе; Двигатель в сборе; Плита 1; Крышка; Микровыключатель в сборе; Стандартные изделия; Винт А.М2-6gx8 ГОСТ11644-75; Гайка М2 шестигранная низкая; ГОСТ 4036; Винт А.М3-:6gx8 ГОСТ 11644-75; Винт А.М2-6gx6 ГОСТ11644-75; Копировал; Формат A4

РЛ5.04.00.00.00 СБ | Лист
| 2

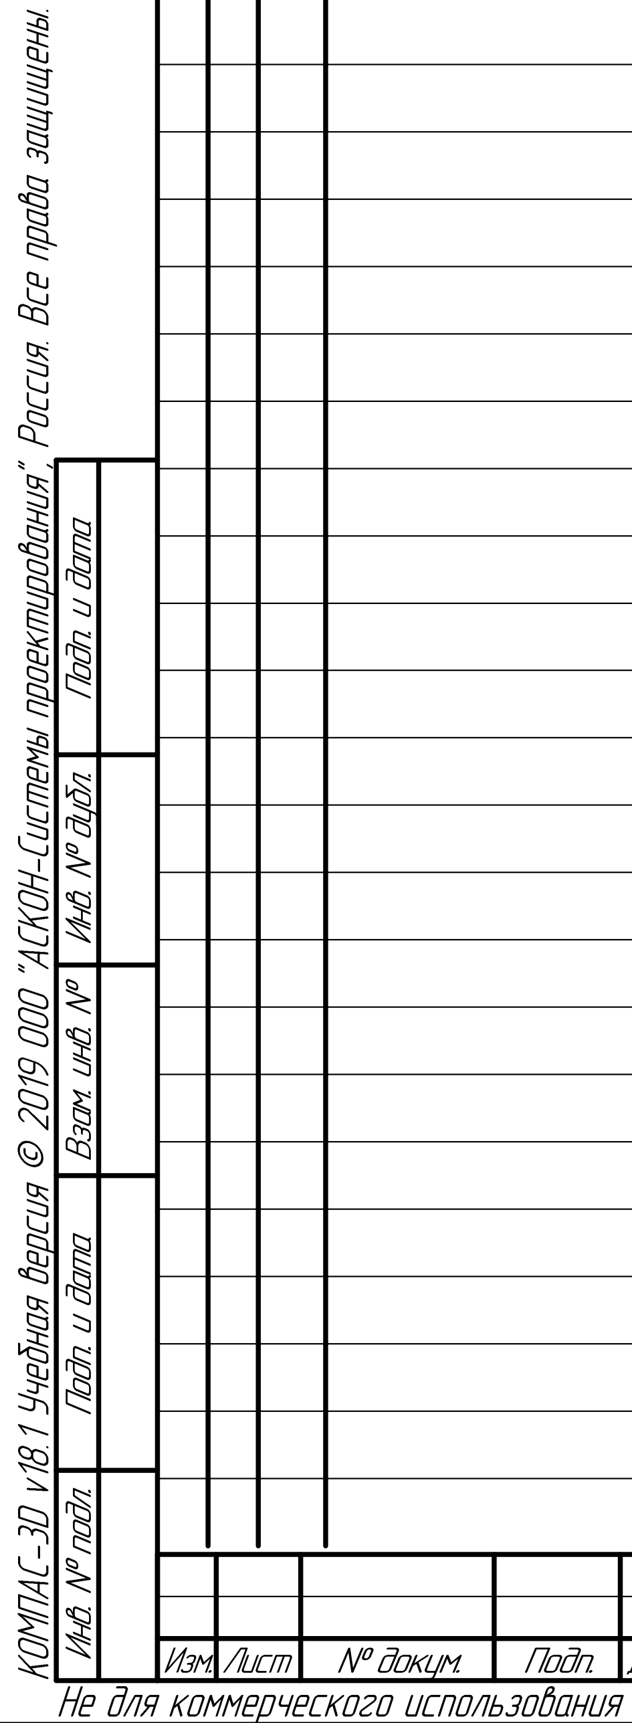
[picture p107: figure]

Изм. Лист | № докум. | Подп. | Дата Инв. № подл. Подп. и дата Взам. инв. № Инв. № дубл. Подп. и дата
Зона | 18 Поз. | Обозначение | Шайба М2 ГОСТ 6978-58 Наименование | 4 Формат Кол. | Приме-чание
| 16 | | Винт А.М3.5-6gx8 ГОСТ11644-75 | 8
| 17 | | Шайба М3.5 ГОСТ 6978-58 | 8
Копировал | Формат A4
