orku/course_project_dmm/с одной зубчатой передчей/val/val_2-Статический анализ 1-Изображение-3.jpg

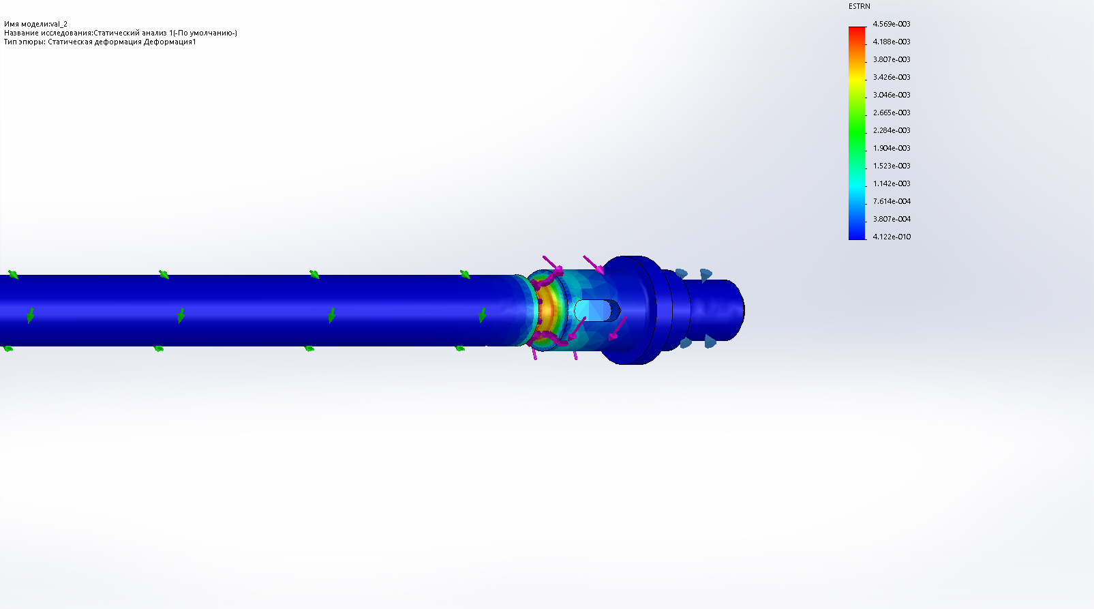
с одной зубчатой передчей/val/val_2-Статический анализ 1-Изображение-3.jpg
