orku/course_project_dmm/с одной зубчатой передчей/val/val_2.SLDPRT

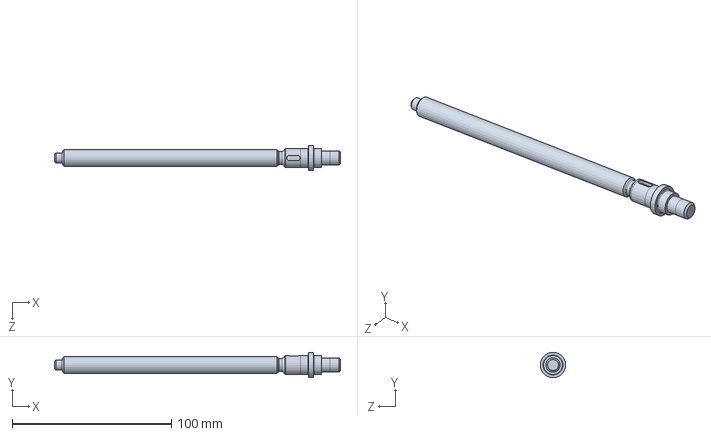
[picture p109: CAD file, 2020-05-26]
с одной зубчатой передчей/val/val_2.SLDPRT
179.8 x 16.0 x 16.0 mm
