orku/course_project_dmm/с одной зубчатой передчей/val/val.SLDPRT

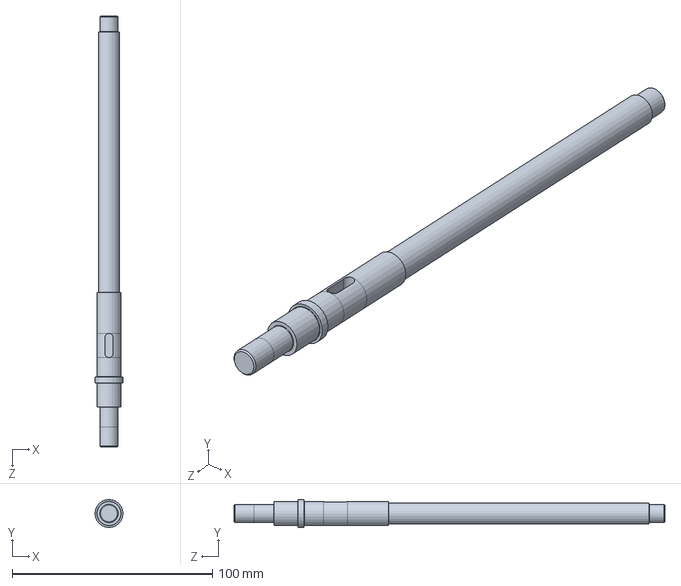
[picture p110: CAD file, 2020-05-18]
с одной зубчатой передчей/val/val.SLDPRT
14.0 x 14.0 x 215.0 mm
