orku/course_project_dmm/(list of files, cad)

Other CAD files:
принципиальная_кин_схема_2.dwg
с одной зубчатой передчей/мусор/схема сборки_1_4138_8a844f9d.sv$.dwg
с одной зубчатой передчей/ужос.dwg
с одной зубчатой передчей/финишная прямая/ГАБАРИТНЫЙ ЧЕРТЁЖ.dwg
принципиальная_кин_схема.dwg
с одной зубчатой передчей/Кириллу пружина А4.dwg
с одной зубчатой передчей/мусор/ВО_2_листа.dwg
с одной зубчатой передчей/финишная прямая/чертёж стойкиА3.dwg
рамка А2.dwg
с одной зубчатой передчей/габаритный.dwg
с одной зубчатой передчей/мусор/ВО_странный___12_1_9777.dwg
с одной зубчатой передчей/финишная прямая/ГБ А1.dwg
кин_схема.dwg
с одной зубчатой передчей/габаритный-2.dwg
с одной зубчатой передчей/мусор/ВО_странный___12.dwg
с одной зубчатой передчей/финишная прямая/вал в сборе А2.dwg
с одной зубчатой передчей/мусор/ВО_странный.dwg
с одной зубчатой передчей/с 1 листом ВО.dwg
с одной зубчатой передчей/финишная прямая/Плита А2 исправленная.dwg
с одной зубчатой передчей/мусор/ВО_странный))).bak.dwg
с одной зубчатой передчей/с 1 листом ВО_1_4296_32a8caf2.sv$.dwg
с одной зубчатой передчей/финишная прямая/ЗК А3.dwg
с одной зубчатой передчей/мусор/компонов_очка чистовая.dwg
с одной зубчатой передчей/Спецификация.dwg
с одной зубчатой передчей/финишная прямая/Двигатель в сборе А3.dwg
с одной зубчатой передчей/мусор/ВО.dwg
с одной зубчатой передчей/финишная прямая/перень элементов.dwg
с одной зубчатой передчей/мусор/кин_схема.dwg
с одной зубчатой передчей/финишная прямая/вал А2.dwg
с одной зубчатой передчей/мусор/М2х8.dwg
с одной зубчатой передчей/финишная прямая/Антону.dwg
с одной зубчатой передчей/мусор/компонов_очка.dwg
с одной зубчатой передчей/финишная прямая/габаритный_1_11322А2.dwg
с одной зубчатой передчей/финишная прямая/плита 1А2.dwg
с одной зубчатой передчей/финишная прямая/упор А4.dwg
с одной зубчатой передчей/финишная прямая/схема сборки.dwg
с одной зубчатой передчей/финишная прямая/Каретка.dwg
с одной зубчатой передчей/финишная прямая/ВО А1.dwg
с одной зубчатой передчей/финишная прямая/Чертеж пружины А4.dwg
с одной зубчатой передчей/финишная прямая/принципиальная_кин_схема_2 А2.dwg
с одной зубчатой передчей/финишная прямая/с 1 листом ВО_1_5252 А1.dwg
с одной зубчатой передчей/финишная прямая/с 1 листом ВО.dwg
