orku/course_project_dmm/с одной зубчатой передчей/Антону-Модель.pdf

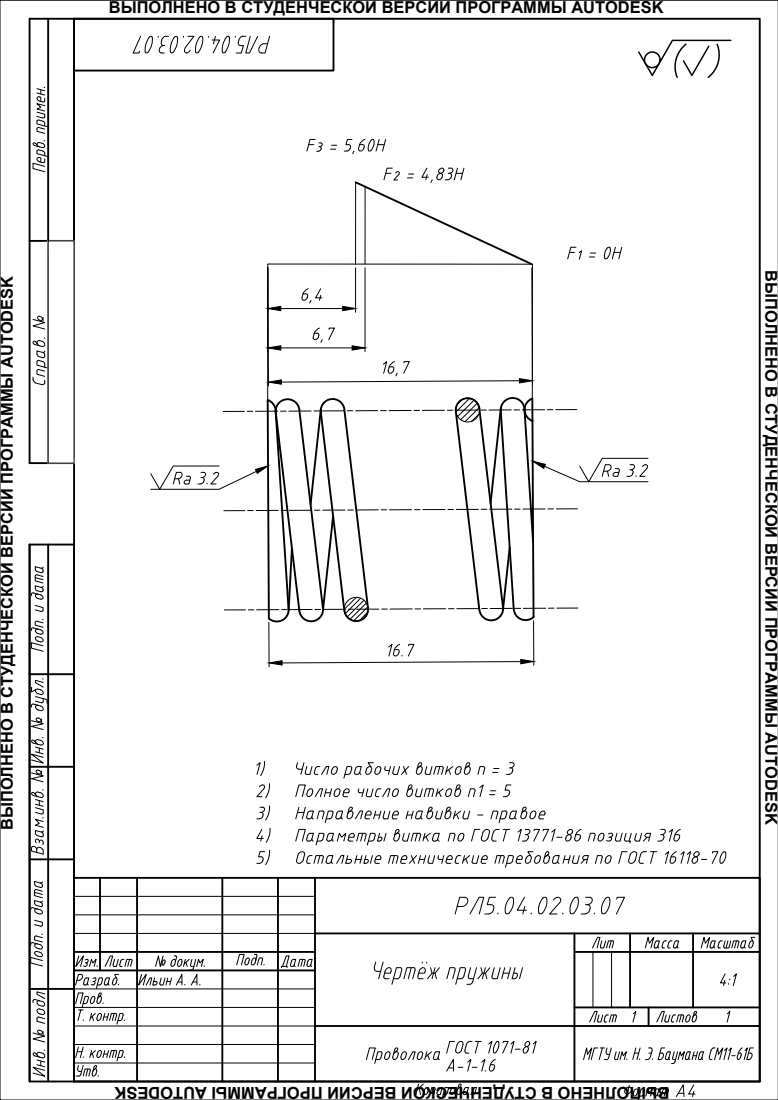
[picture p111: page 1]

ВЫПОЛНЕНО В СТУДЕНЧЕСКОЙ ВЕРСИИ ПРОГРАММЫ AUTODESK
