orku/course_project_dmm/с одной зубчатой передчей/Кириллу пружина А4-Лист1.pdf

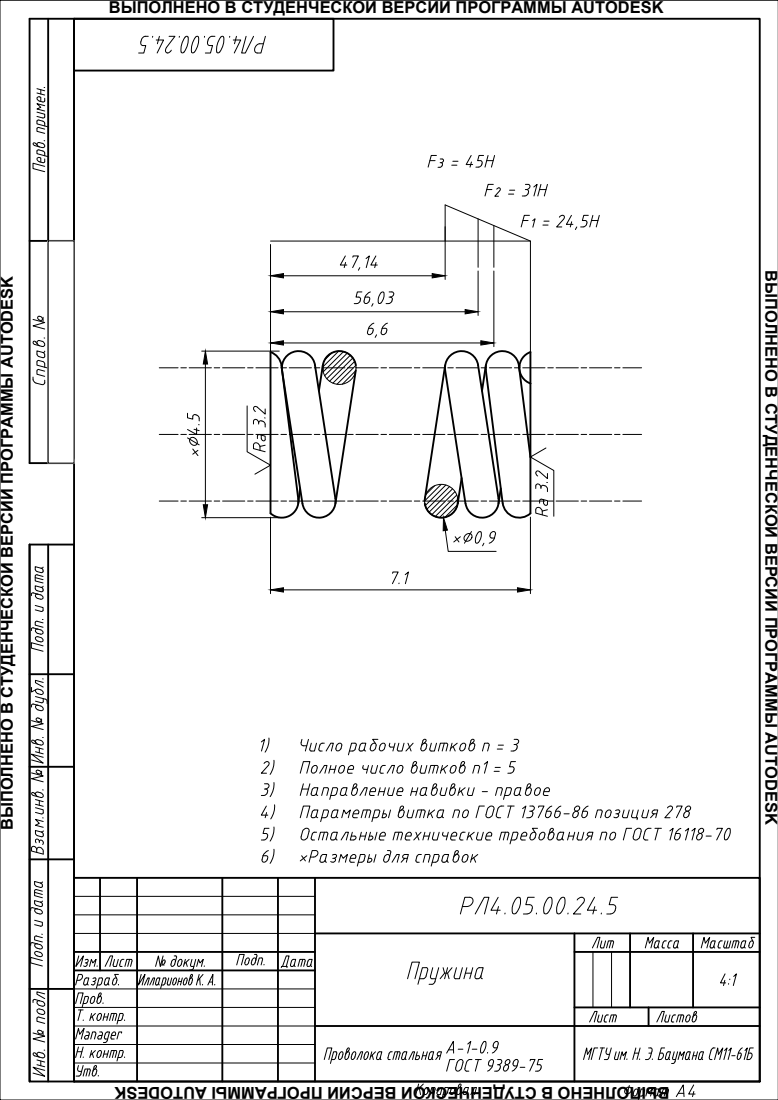
[picture p112: page 1]

ВЫПОЛНЕНО В СТУДЕНЧЕСКОЙ ВЕРСИИ ПРОГРАММЫ AUTODESK
