orku/course_project_dmm/с одной зубчатой передчей/печать на консу 08.05.2020/габаритный-Модель.pdf

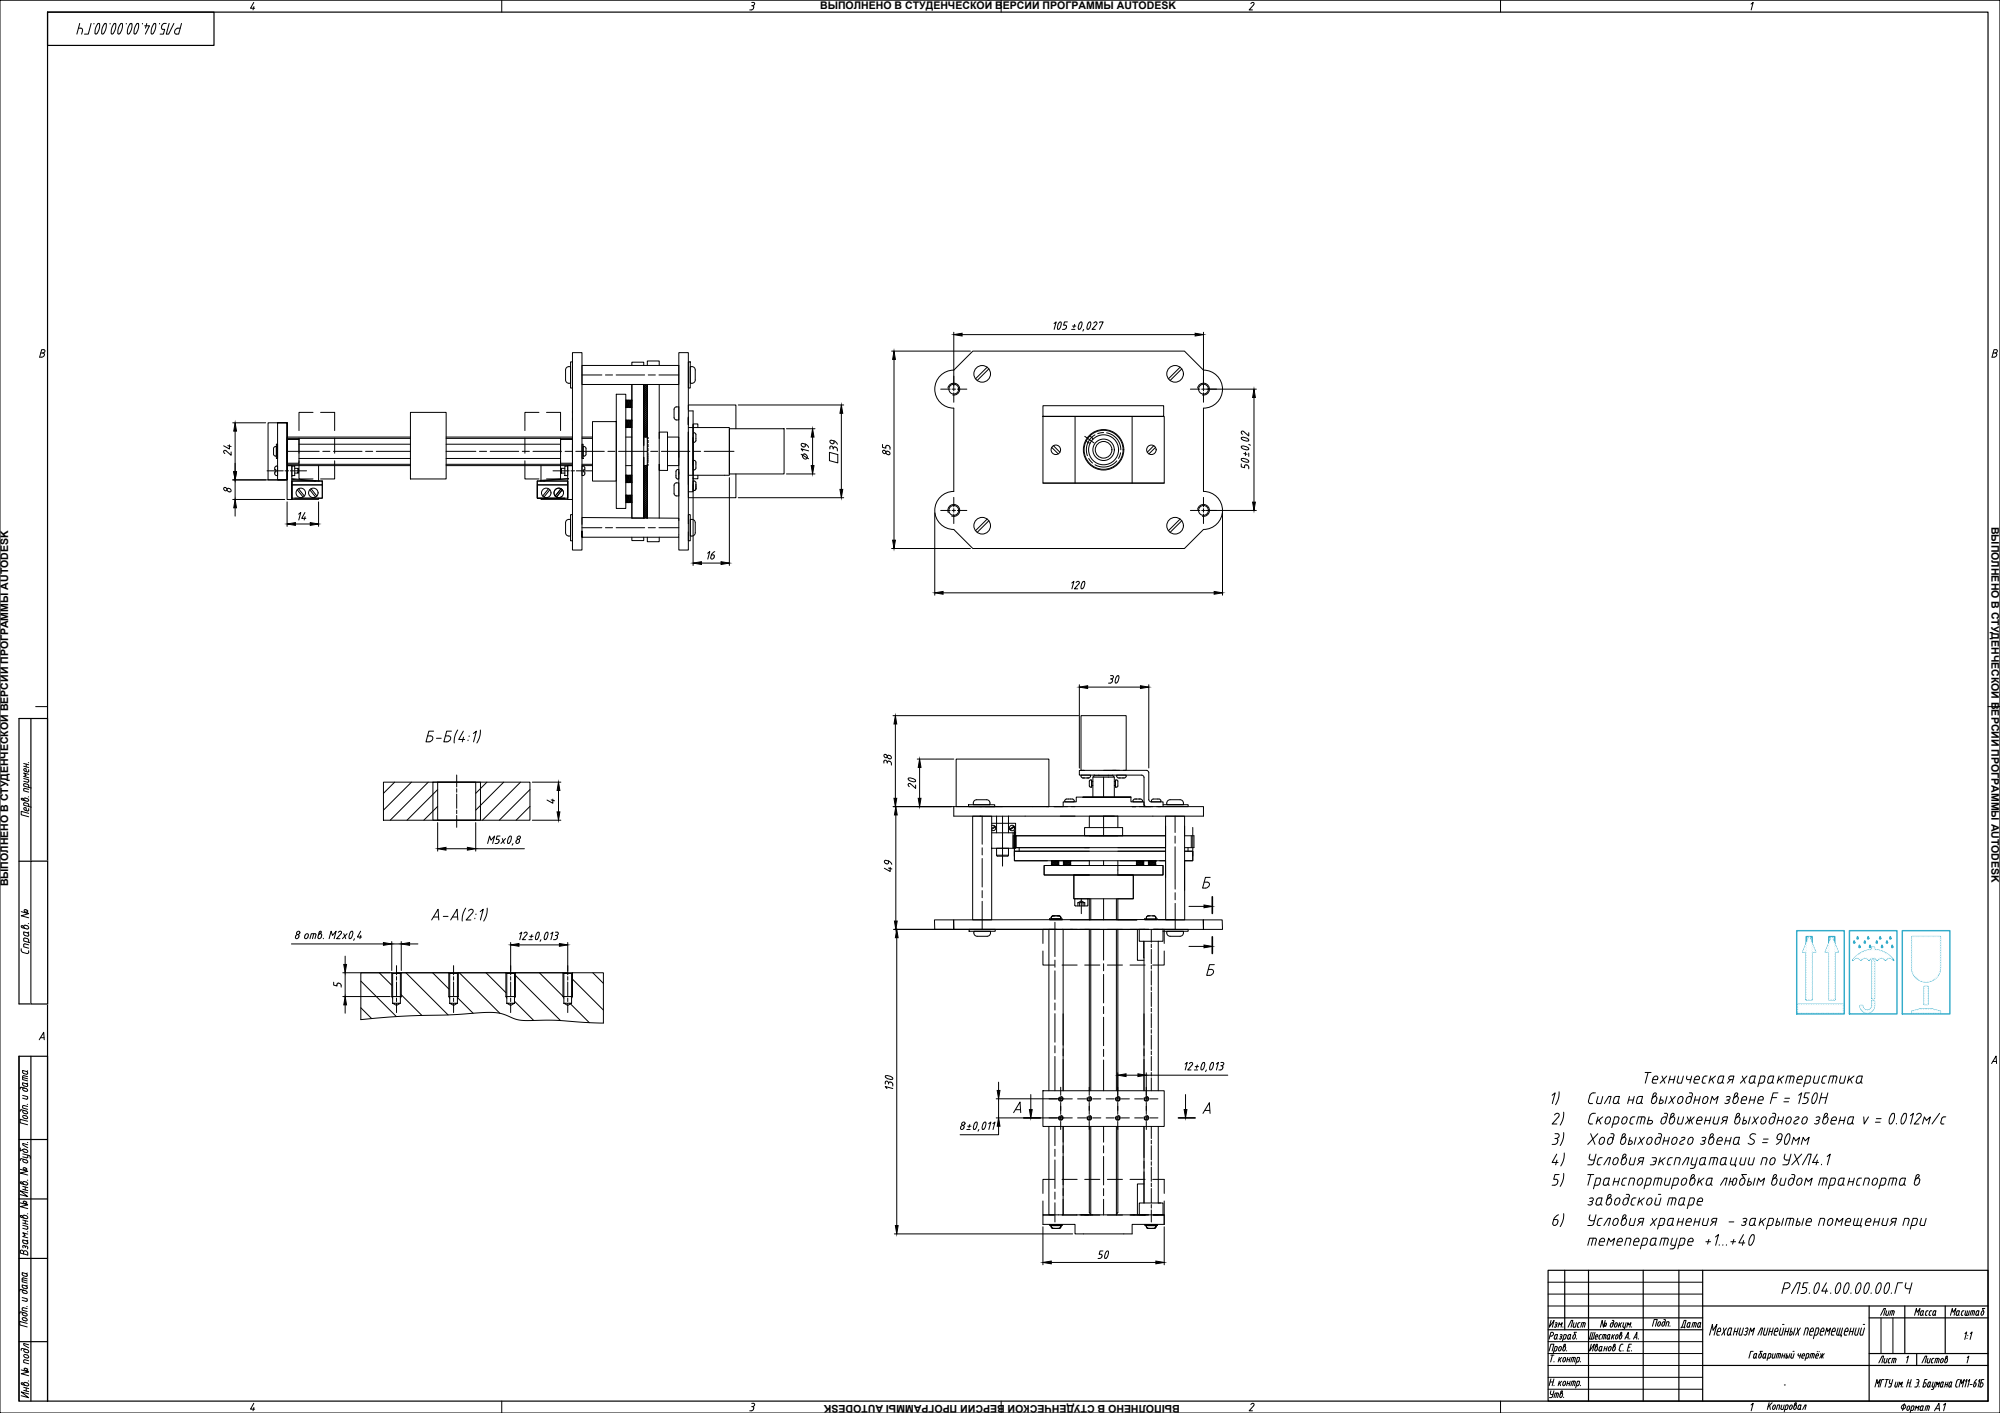
[picture p120: page 1]

ВЫПОЛНЕНО В СТУДЕНЧЕСКОЙ ВЕРСИИ ПРОГРАММЫ AUTODESK
