orku/course_project_dmm/с одной зубчатой передчей/финишная прямая/Антону-Модель.pdf

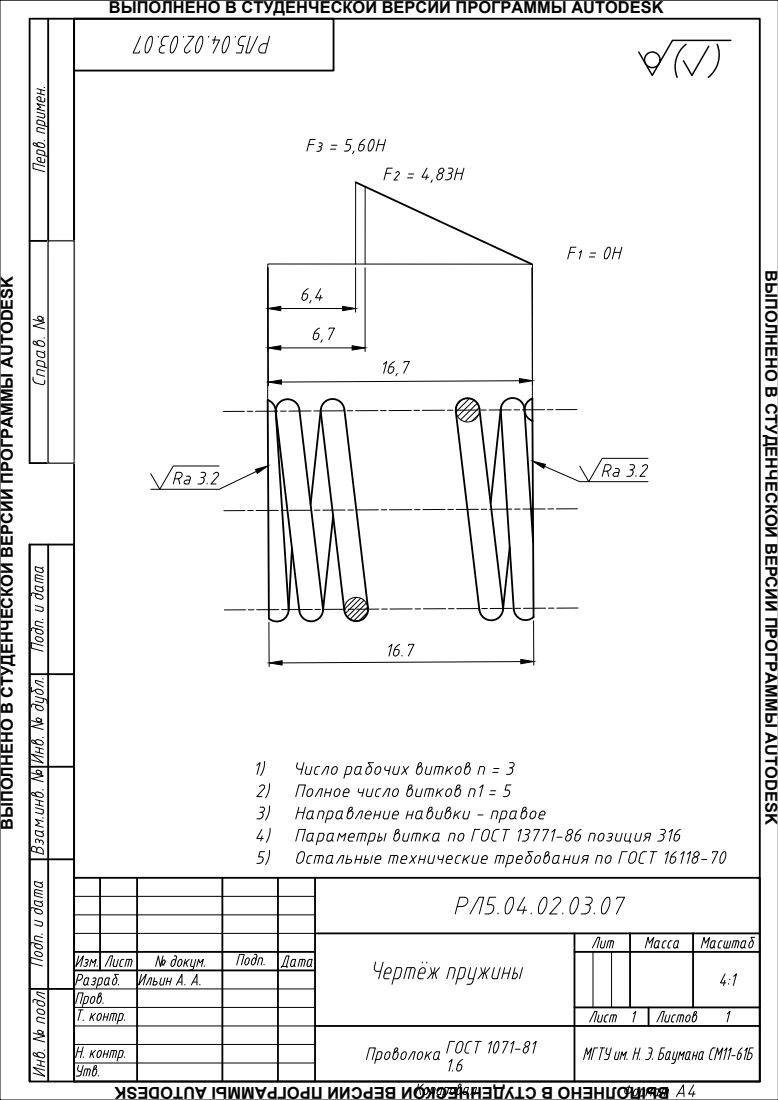
[picture p121: page 1]

ВЫПОЛНЕНО В СТУДЕНЧЕСКОЙ ВЕРСИИ ПРОГРАММЫ AUTODESK
