orku/course_project_dmm/с одной зубчатой передчей/печать на консу 08.05.2020/ВО, ГЧ, Е1, СБ Шестаков А, А, СМ11-61Б.pdf

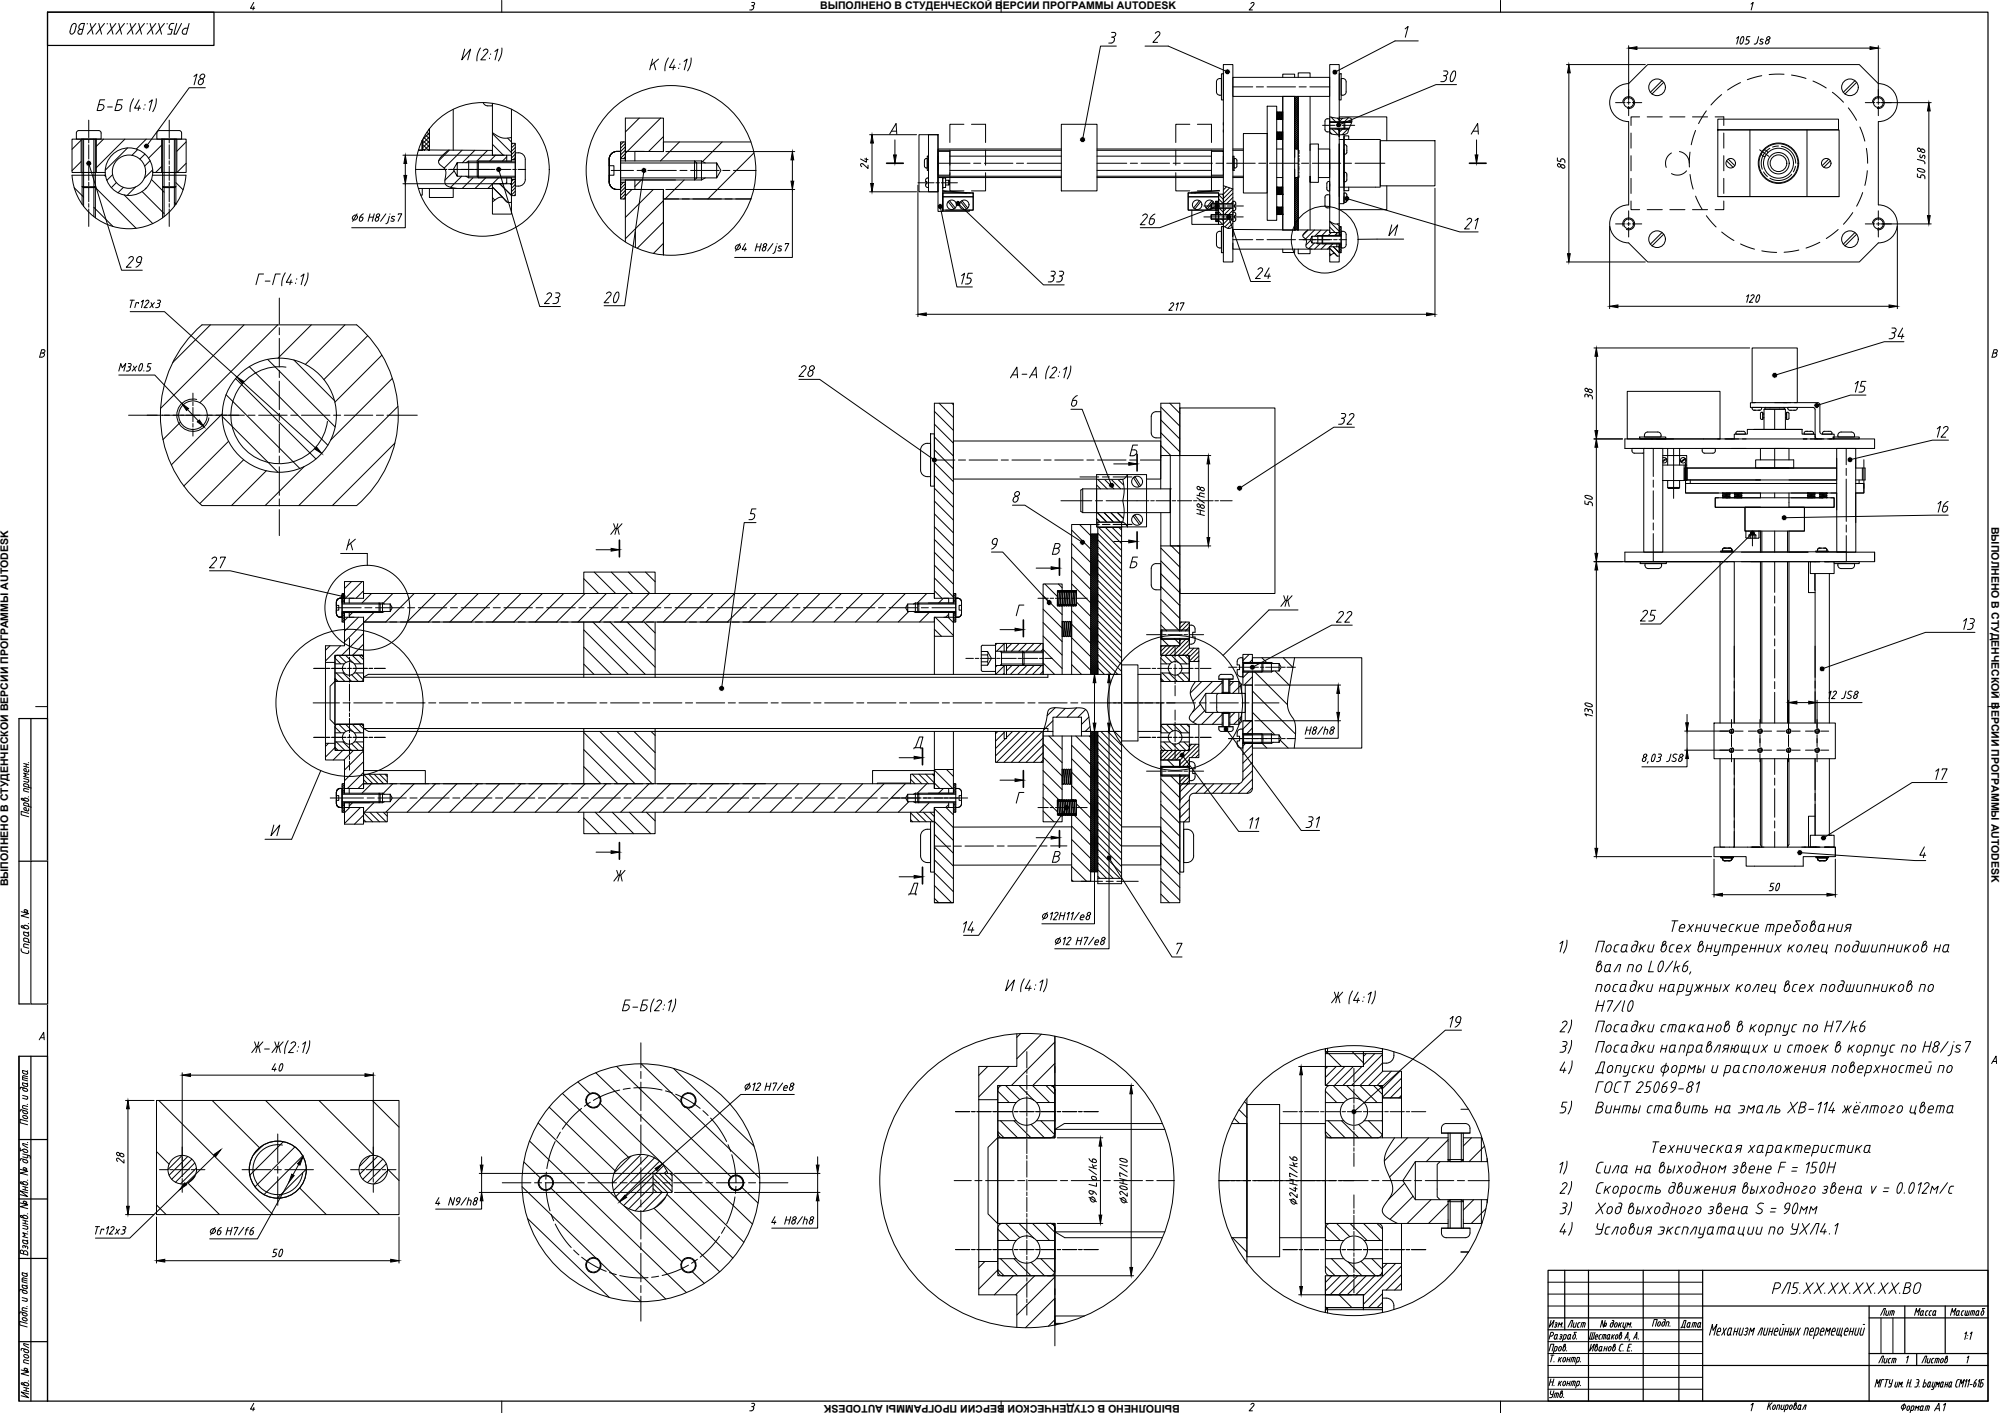
[picture p122: page 1]

ВЫПОЛНЕНО В СТУДЕНЧЕСКОЙ ВЕРСИИ ПРОГРАММЫ AUTODESK

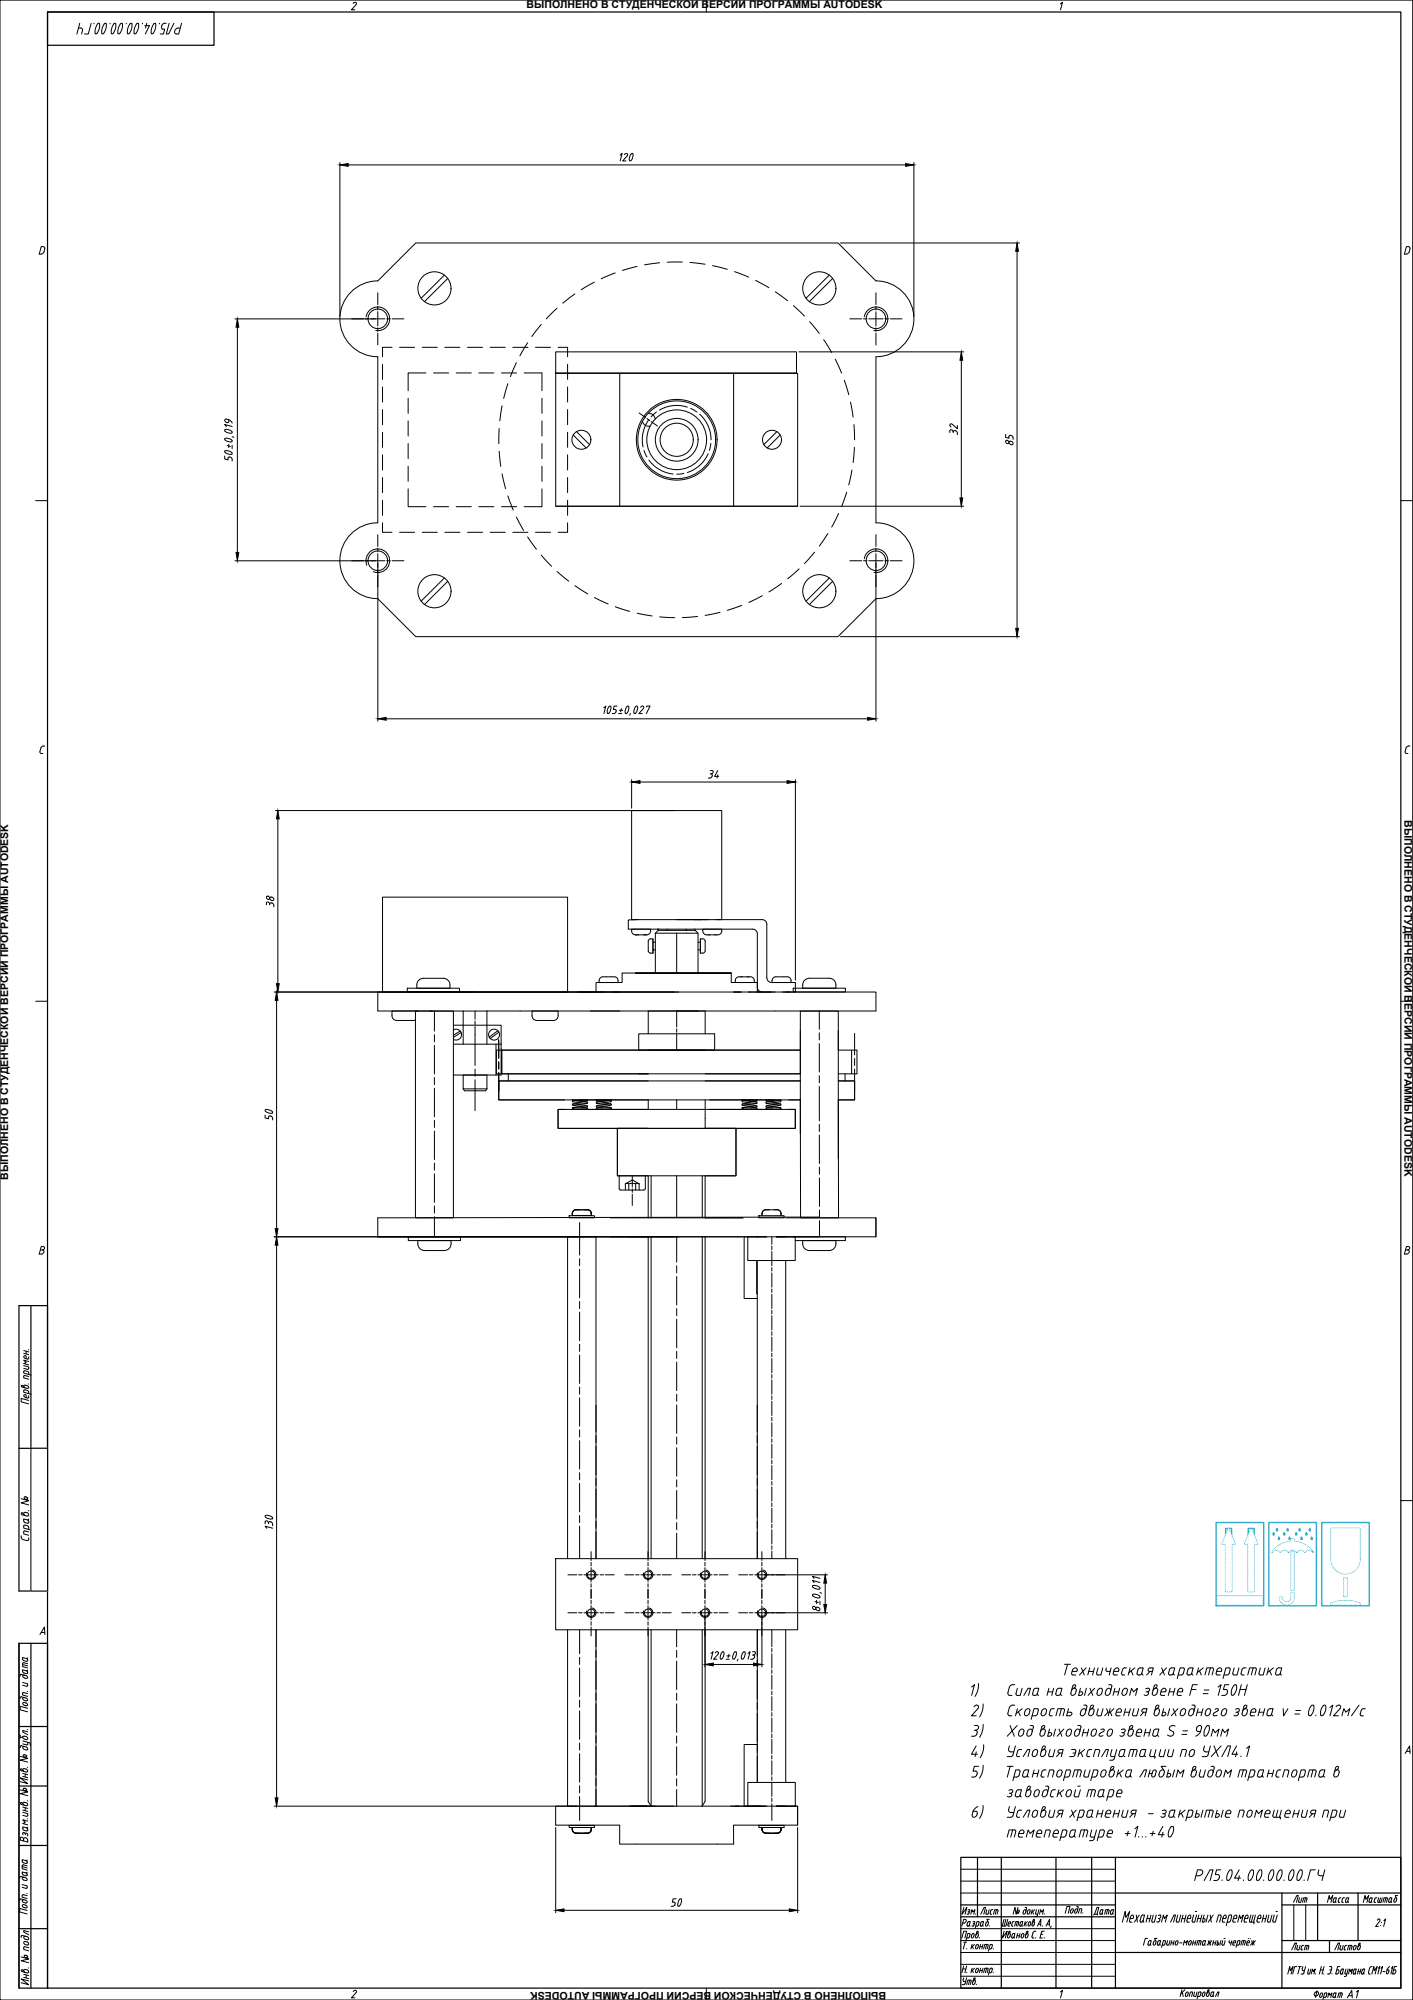
[picture p123: page 2]

ВЫПОЛНЕНО В СТУДЕНЧЕСКОЙ ВЕРСИИ ПРОГРАММЫ AUTODESK

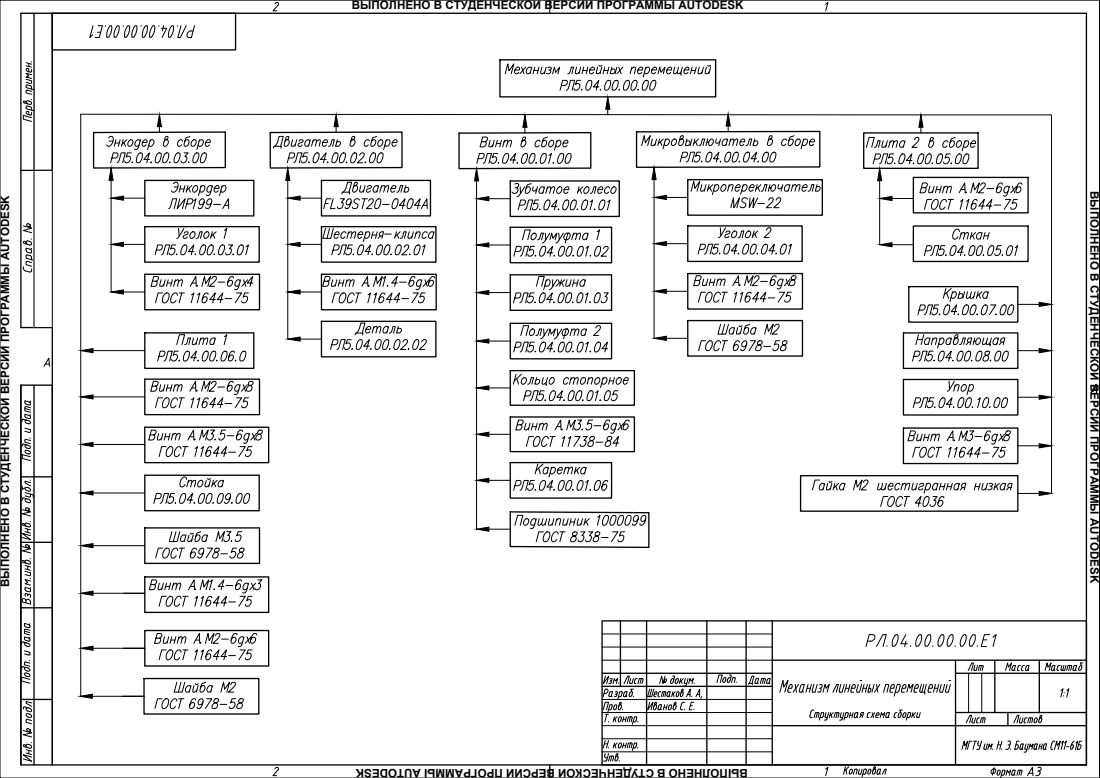
[picture p124: page 3]

ВЫПОЛНЕНО В СТУДЕНЧЕСКОЙ ВЕРСИИ ПРОГРАММЫ AUTODESK

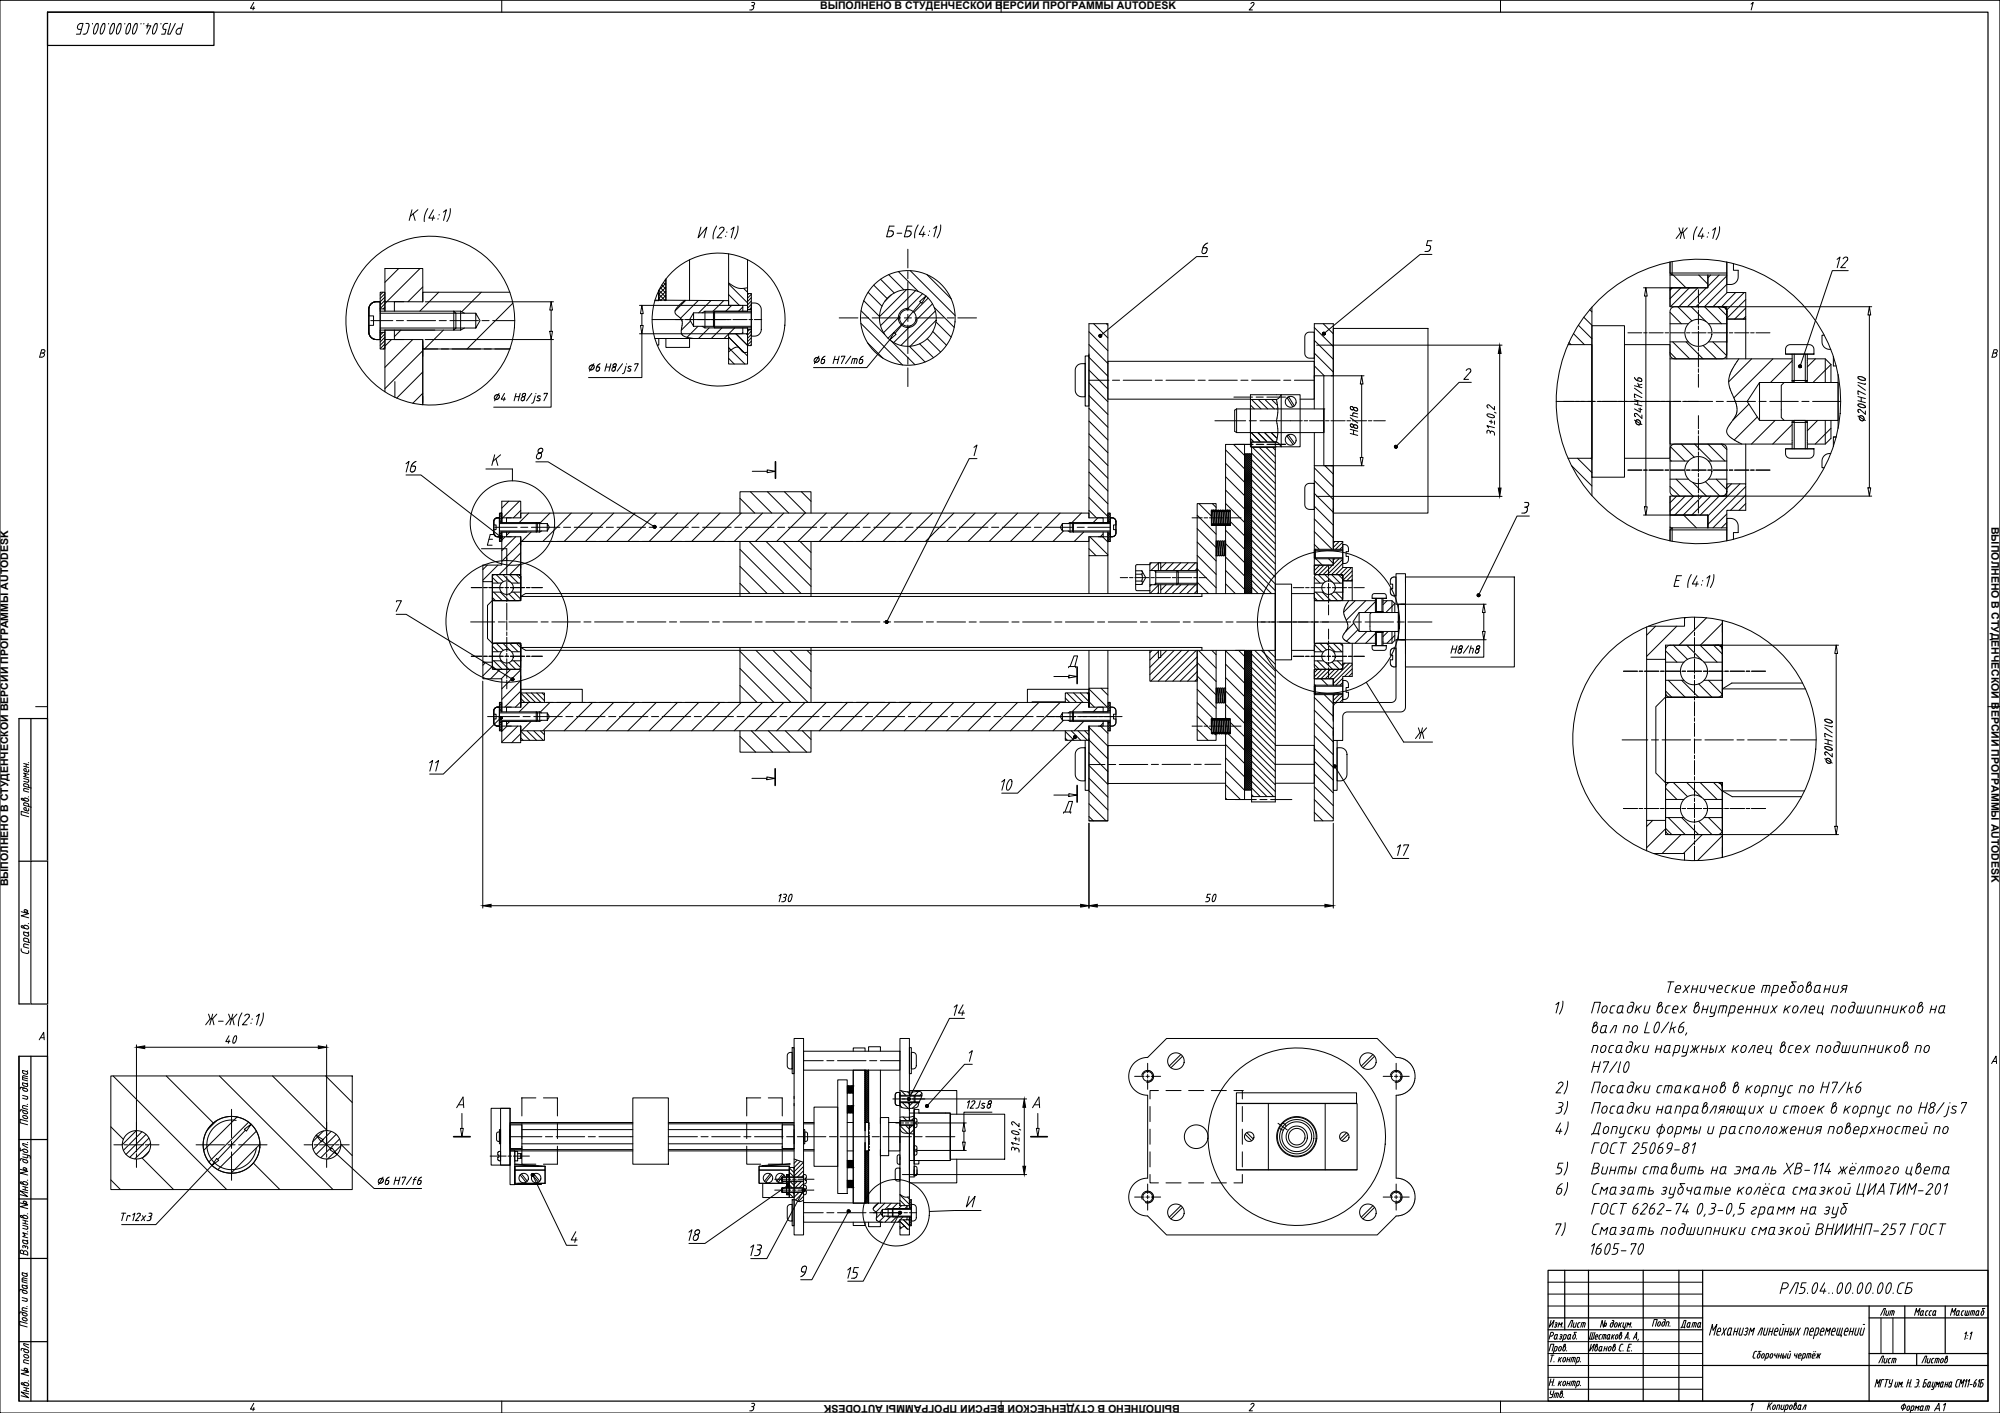
[picture p125: page 4]

ВЫПОЛНЕНО В СТУДЕНЧЕСКОЙ ВЕРСИИ ПРОГРАММЫ AUTODESK
