orku/course_project_dmm/с одной зубчатой передчей/печать на консу 08.05.2020/Кинематическая схема Шестаков А, А, СМ11-61Б.pdf

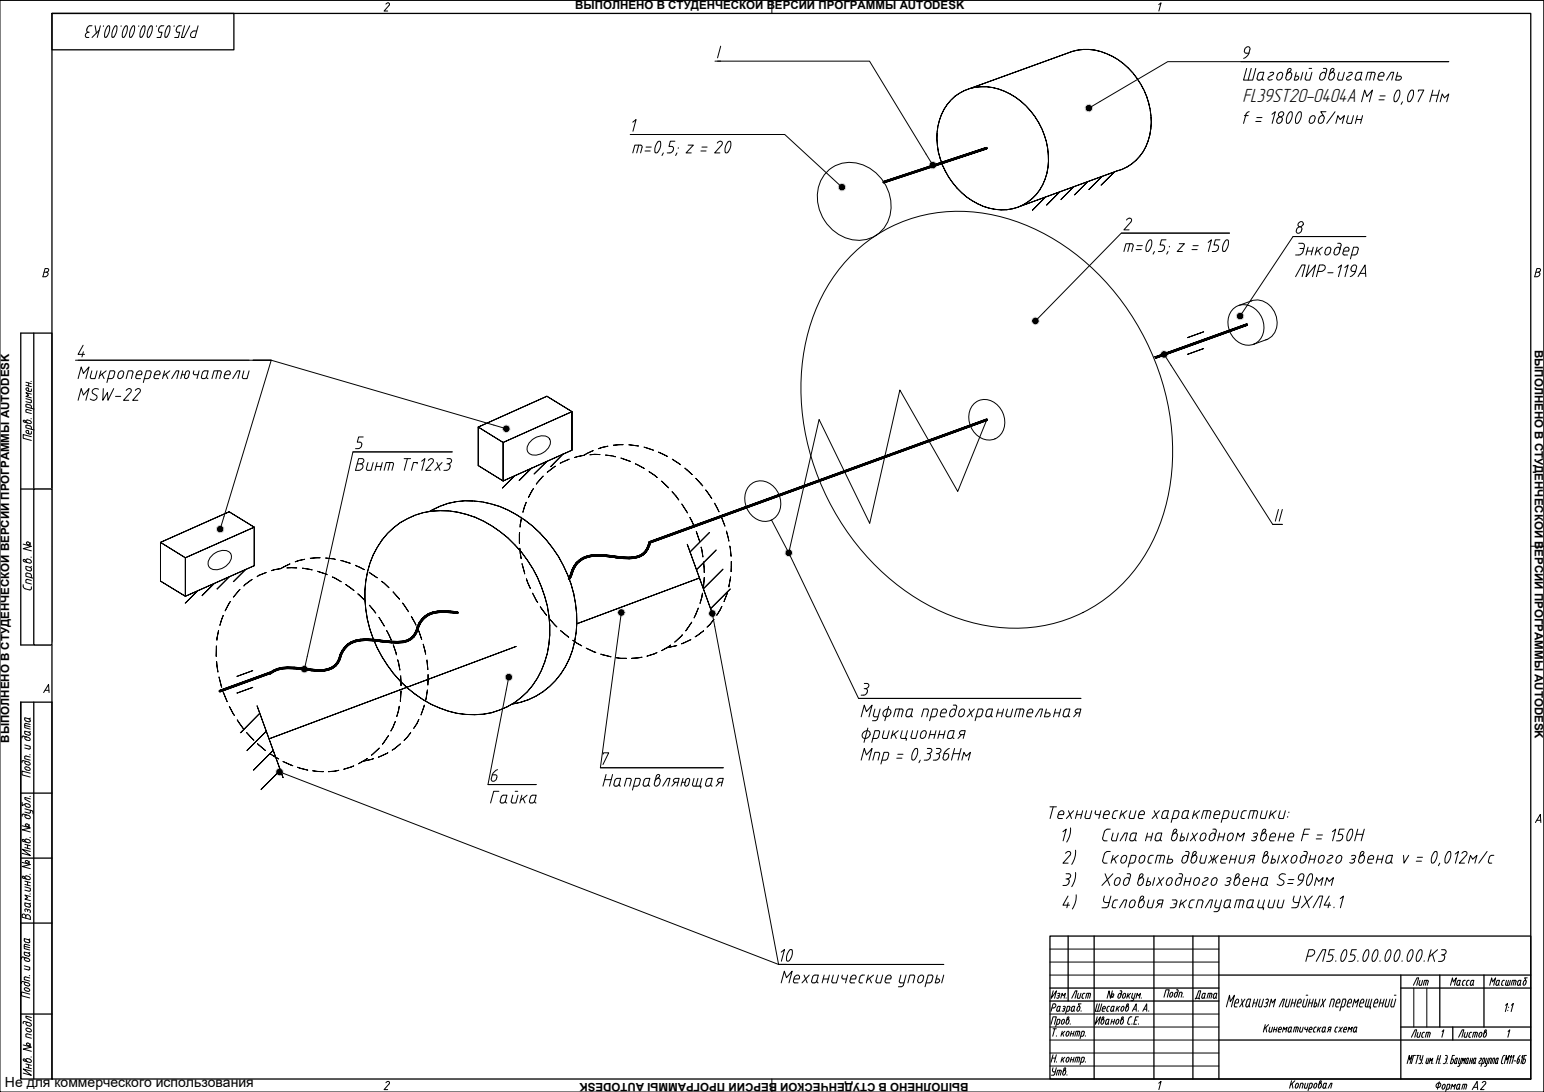
[picture p126: page 1]

ВЫПОЛНЕНО В СТУДЕНЧЕСКОЙ ВЕРСИИ ПРОГРАММЫ AUTODESK

Не для коммерческого использования
