orku/course_project_dmm/с одной зубчатой передчей/печать на консу 08.05.2020/ПЭ Шестаков А. А. СМ11-61Б.pdf

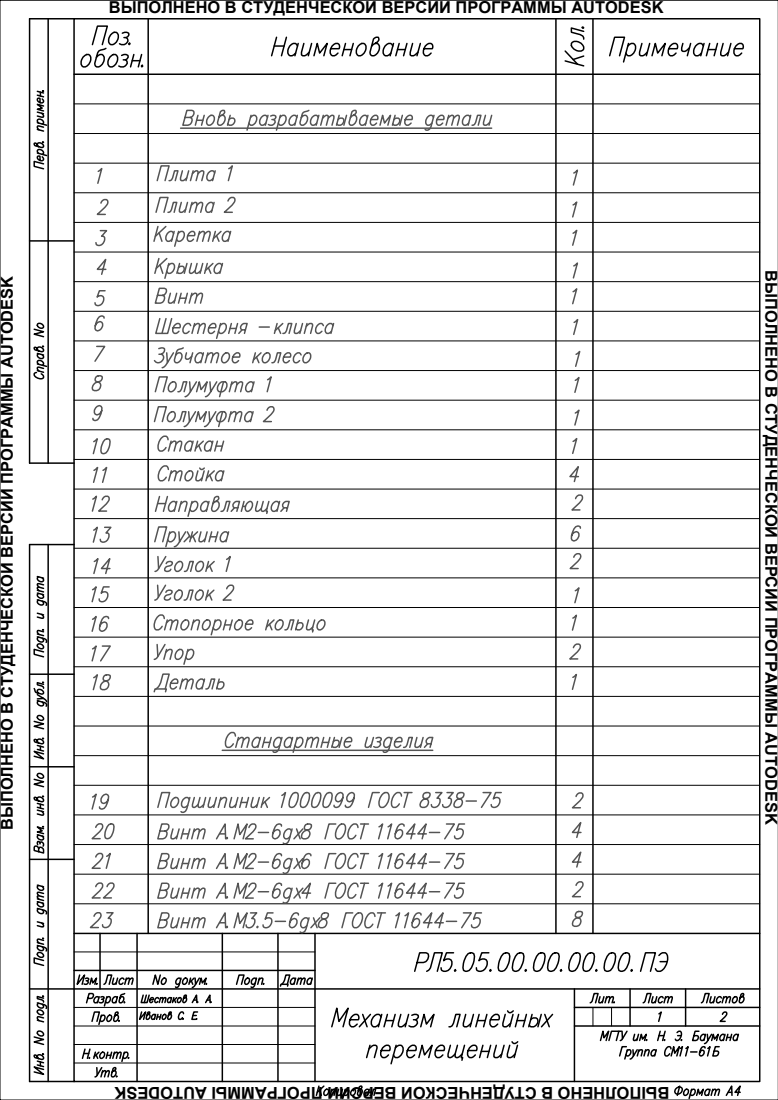
[picture p127: page 1]

ВЫПОЛНЕНО В СТУДЕНЧЕСКОЙ ВЕРСИИ ПРОГРАММЫ AUTODESK

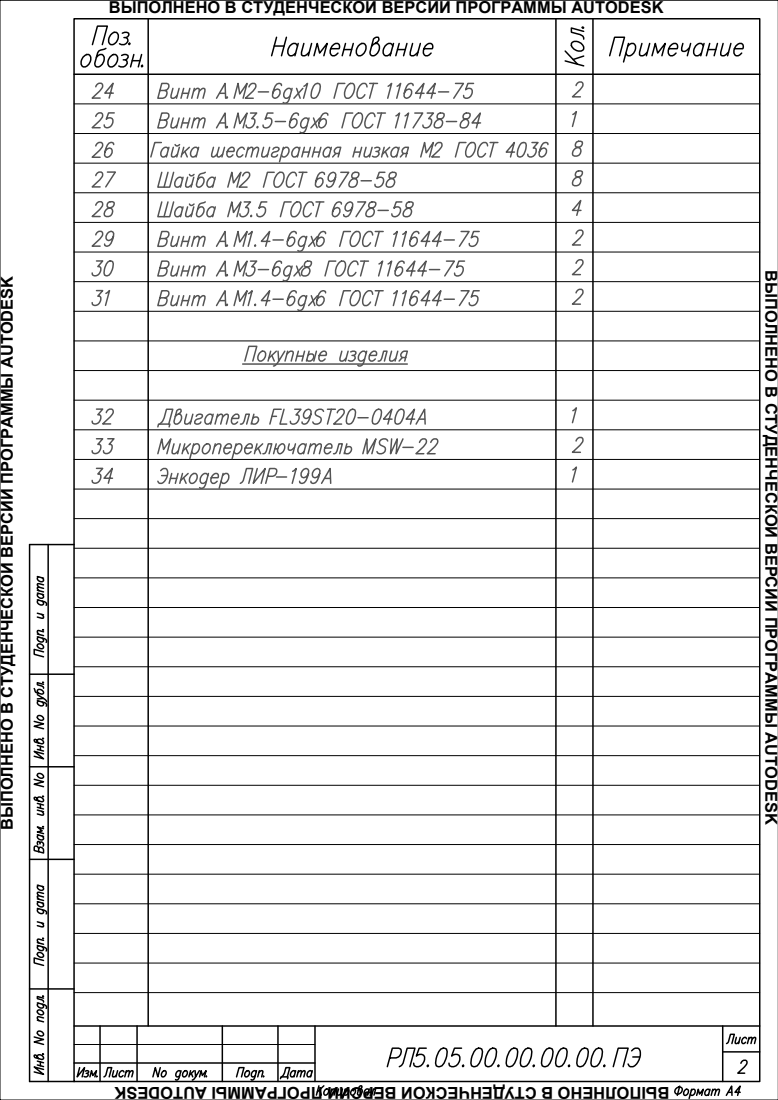
[picture p128: page 2]

ВЫПОЛНЕНО В СТУДЕНЧЕСКОЙ ВЕРСИИ ПРОГРАММЫ AUTODESK
