orku/course_project_dmm/с одной зубчатой передчей/мусор/ВО Шестаков А. А.СМ11-61Б.pdf

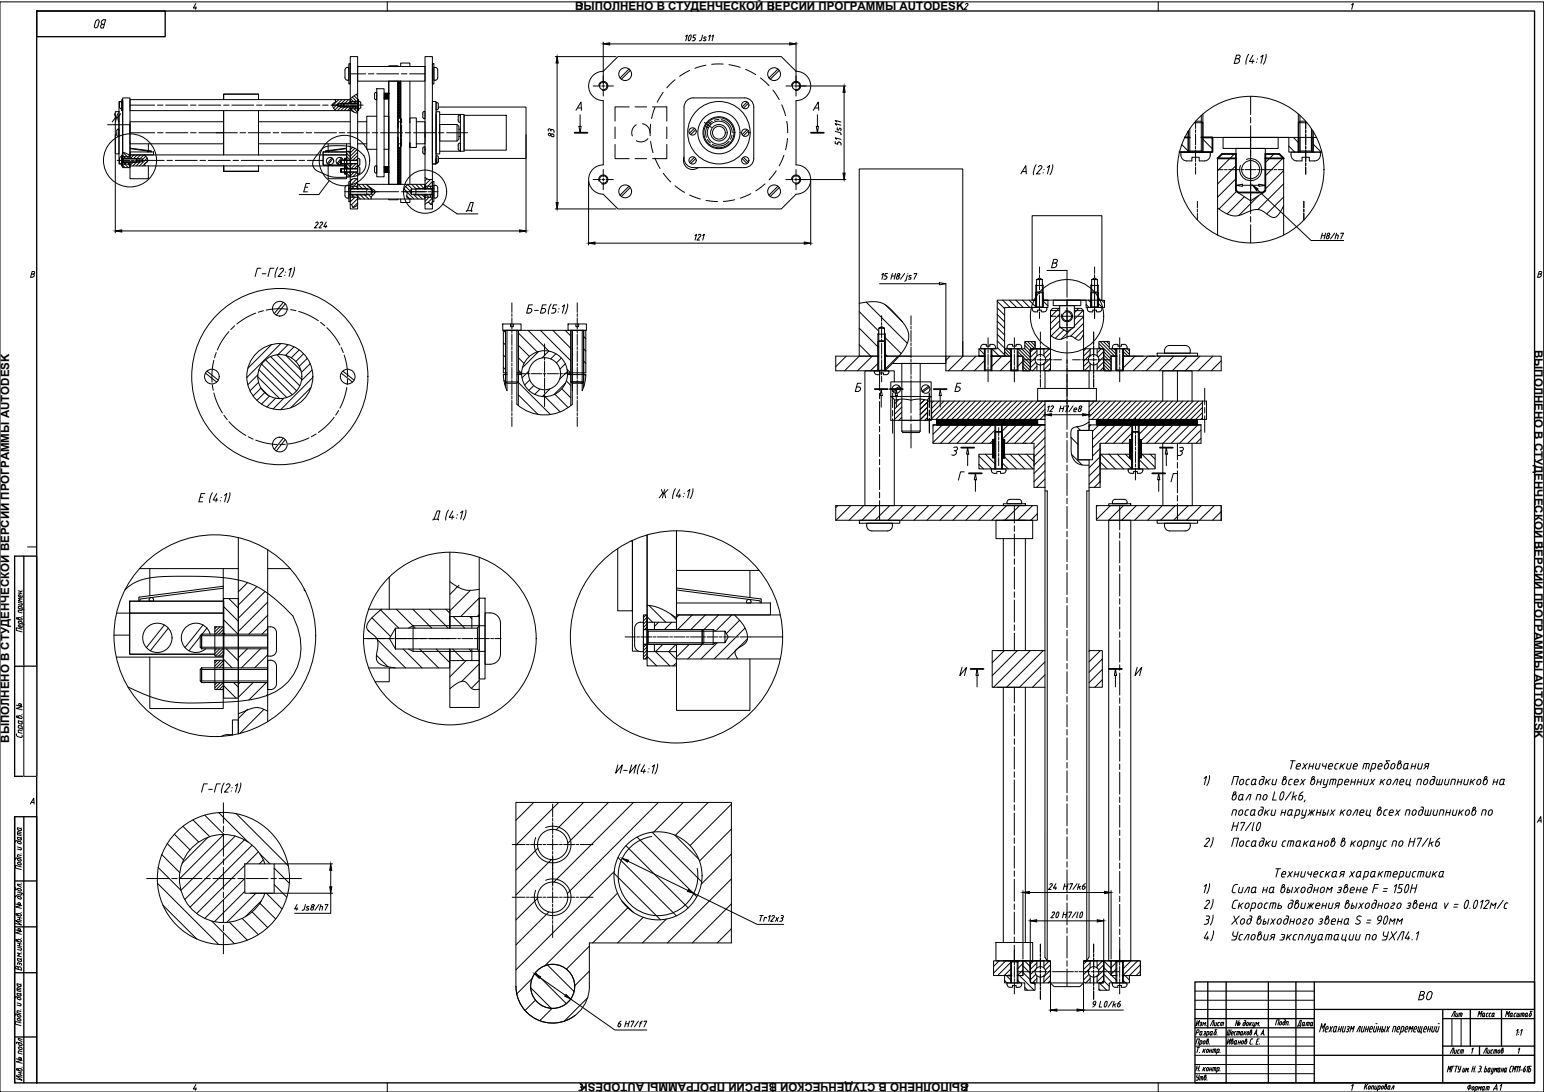
[picture p129: page 1]

ВЫПОЛНЕНО В СТУДЕНЧЕСКОЙ ВЕРСИИ ПРОГРАММЫ AUTODESK
