orku/course_project_dmm/с одной зубчатой передчей/мусор/Компоновка Шестаков А. А.СМ11-61Б.pdf

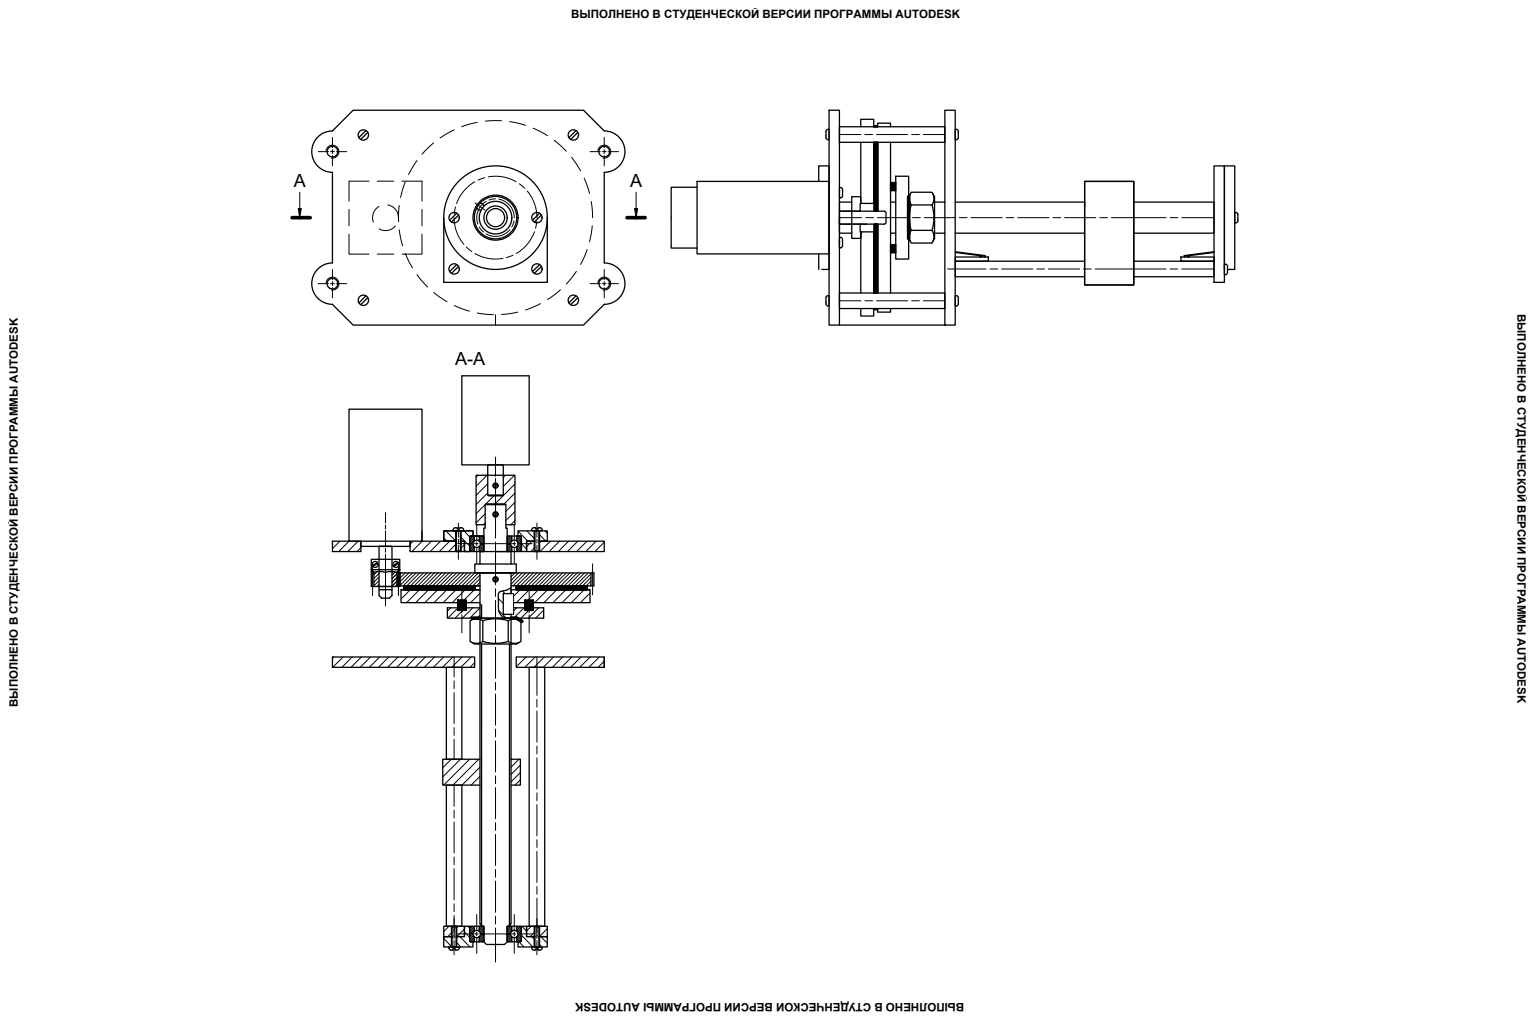
[picture p130: page 1]

ВЫПОЛНЕНО В СТУДЕНЧЕСКОЙ ВЕРСИИ ПРОГРАММЫ AUTODESK
