orku/course_project_dmm/с одной зубчатой передчей/мусор/Принципиальная Кинематическая Схема Шесактаков А. А.СМ11-61Б.pdf

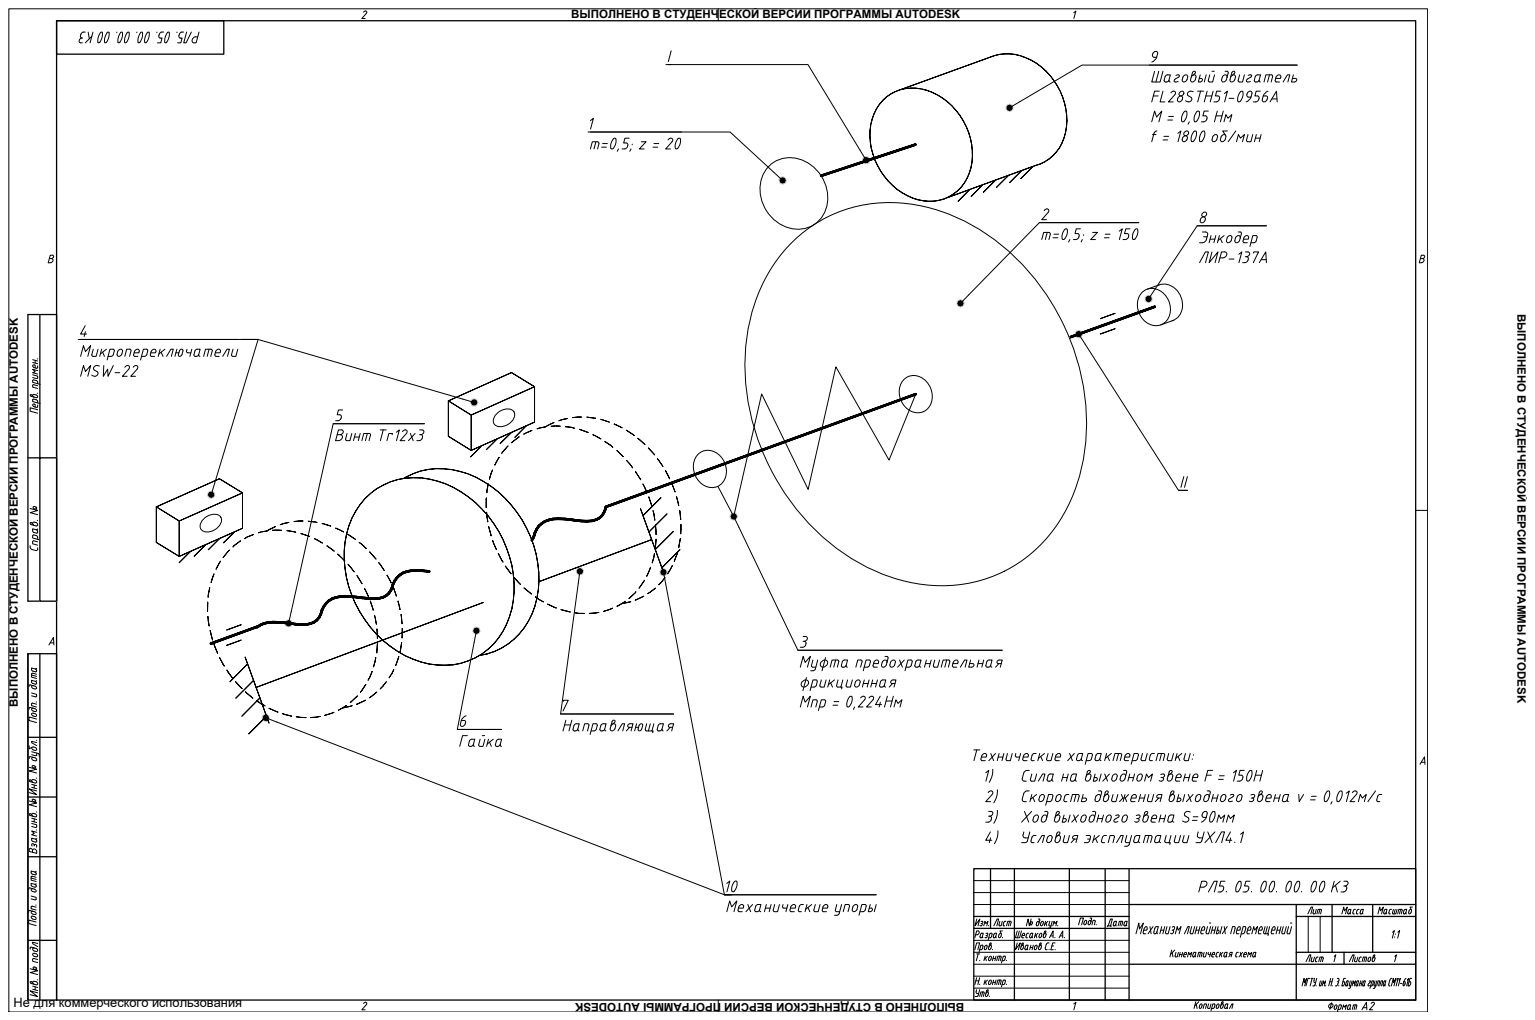
[picture p131: page 1]

ВЫПОЛНЕНО В СТУДЕНЧЕСКОЙ ВЕРСИИ ПРОГРАММЫ AUTODESK

Не для коммерческого использования
