orku/course_project_dmm/с одной зубчатой передчей/финишная прямая/на защиту/msw22_2.pdf

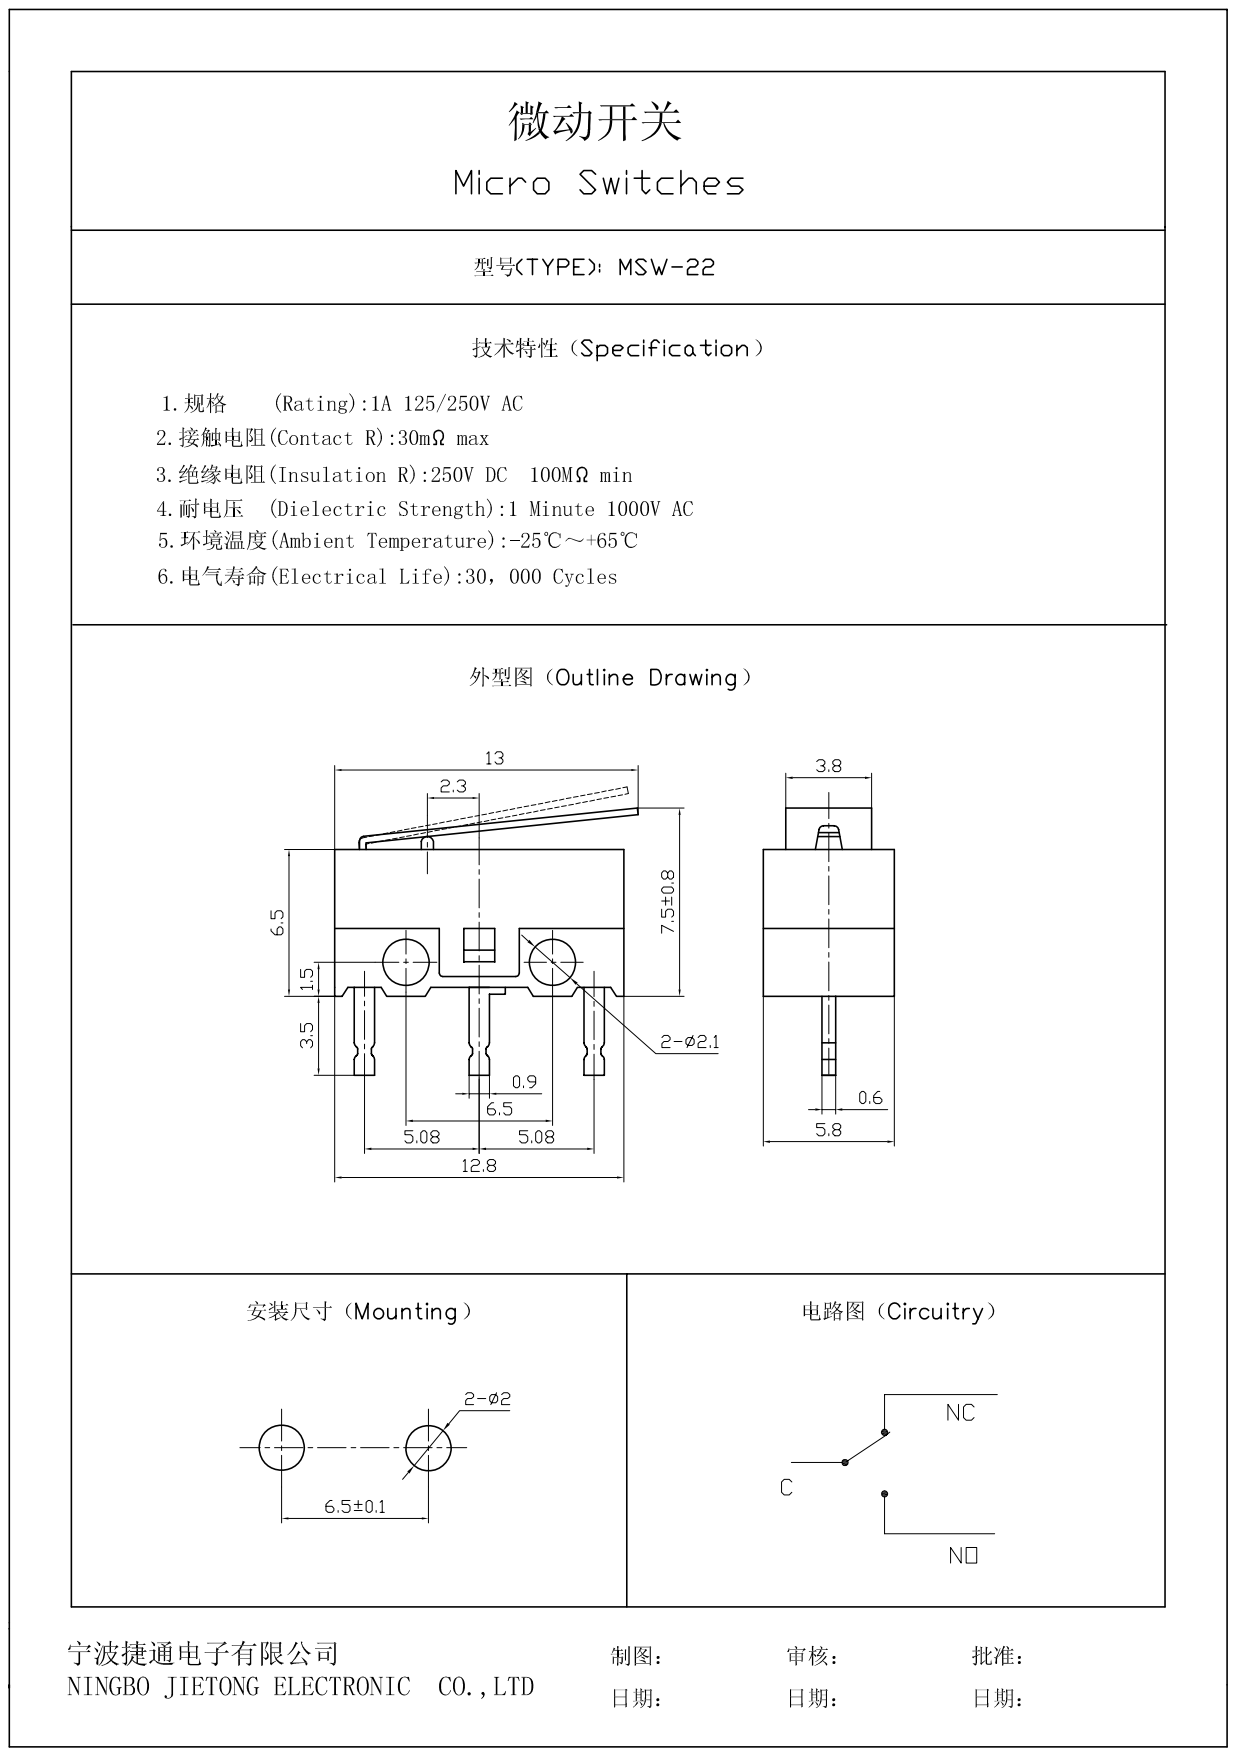
[picture p132: page 1]
