orku/course_project_dmm/с одной зубчатой передчей/финишная прямая/на защиту/перень элементов.pdf

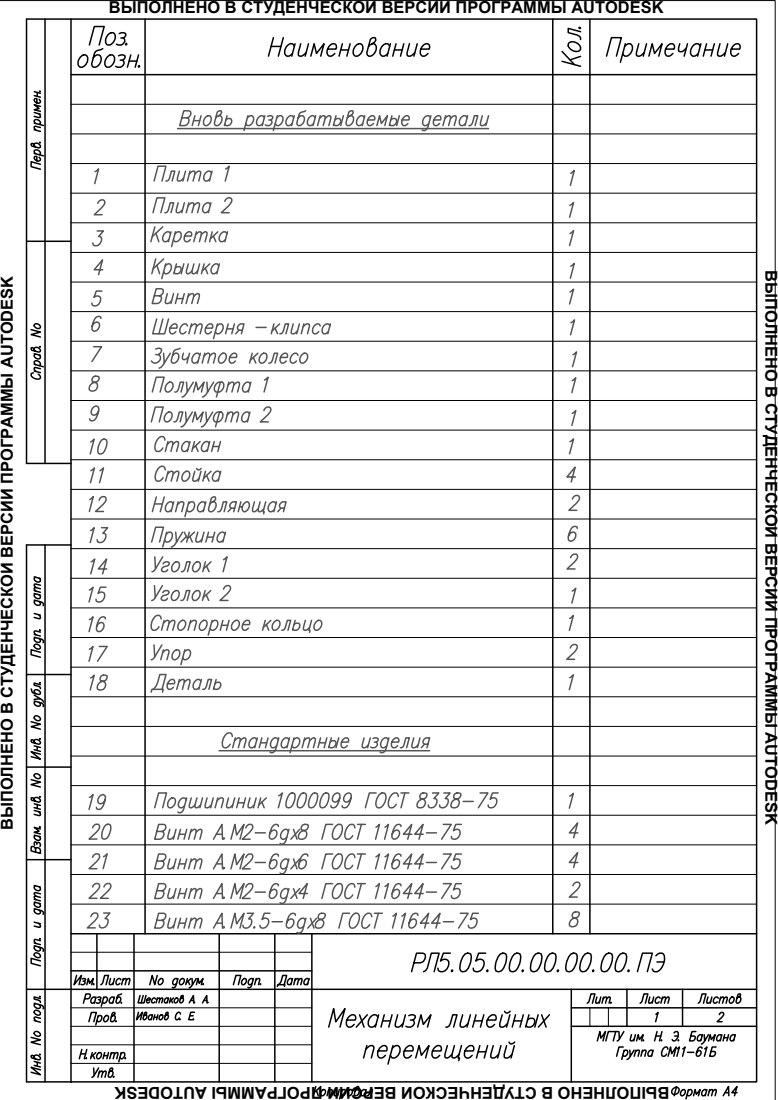
[picture p133: page 1]

ВЫПОЛНЕНО В СТУДЕНЧЕСКОЙ ВЕРСИИ ПРОГРАММЫ AUTODESK

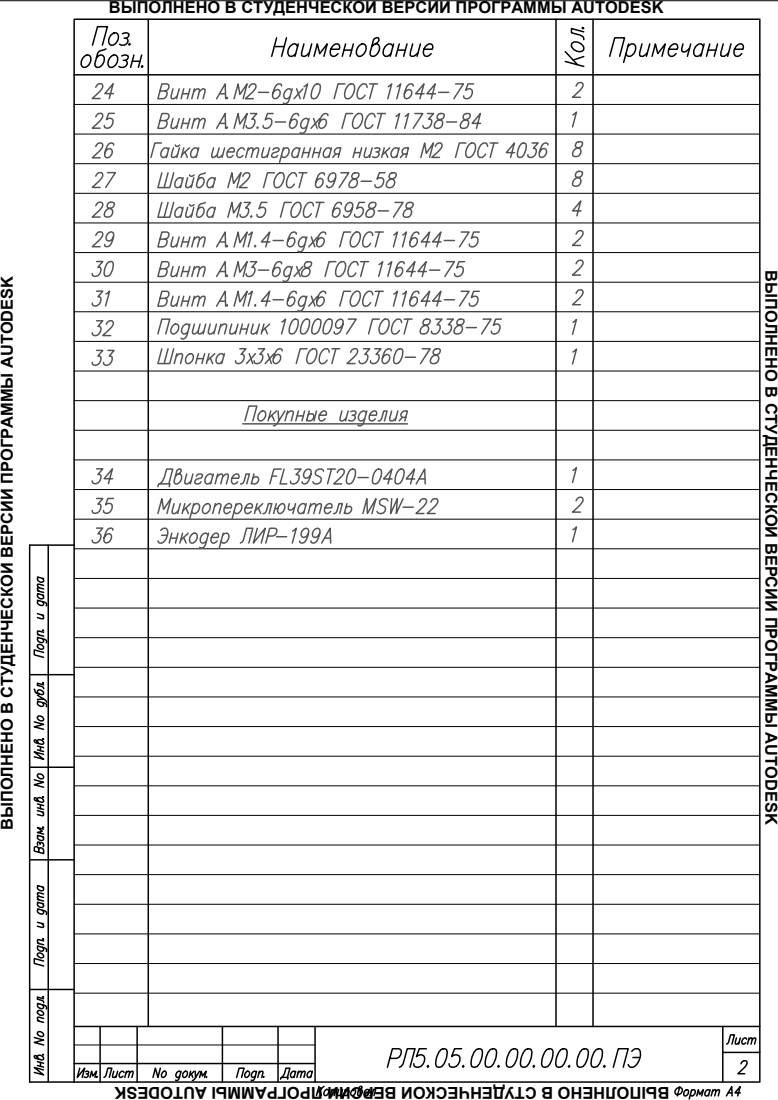
[picture p134: page 2]

ВЫПОЛНЕНО В СТУДЕНЧЕСКОЙ ВЕРСИИ ПРОГРАММЫ AUTODESK
