orku/course_project_dmm/(commit log)

2020-03-12 все проектировачные расчёты на 13 марта
    [РАСЧЁТЫ_РПЗ (Автосохраненный).xlsx]
2020-03-12 на консу 14 марта проектные расчёты
    [кин_схема.dwg]
2020-03-14 после консультации 14 марта
    [РАСЧЁТЫ_РПЗ (Автосохраненный)-LAPTOP-VDOEU2V2.xlsx, принципиальная_кин_схема.dwg, принципиальная_кин_схема_2.dwg, рамка А2.dwg]
2020-04-02 начал делать ВО
    начал делать ВО
    [М2х8.dwg, РАСЧЁТЫ_РПЗ (Автосохраненный).xlsx, кин_схема.dwg, компонов_очка чистовая.dwg, компонов_очка.dwg, принципиальная_кин_схема.dwg, принципиальная_кин_схема_2.dwg, рамка А2.dwg]
2020-04-09 всё к 09.04, надо переделать вид с лева, на вид с права
    [ВО.dwg, ВО_странный))).bak.dwg, ВО_странный.dwg, ВО_странный___12.dwg, компонов_очка чистовая.dwg]
2020-04-09 Сделал общий вид
    С
    [ВО_странный___12.dwg, ВО_странный___12_1_9777.dwg]
2020-04-16 опять всё переделал
    [ВО_странный___12_1_9777.dwg]
2020-04-28 Create ВО_2_листа.dwg
    добавил проверочные расчёты
    [ВО_2_листа.dwg]
2020-04-28 new changhes
    w
    [ВО_2_листа.dwg, Перень элементов.dwg]
2020-05-05 доделал ещё пару чертежей
    [Перень элементов.dwg, с 1 листом ВО.dwg, схема сборки.dwg]
2020-05-05 и ещё
    [ВО_2_листа.dwg]
2020-05-07 как же меня заебал этот курсач
    [Перень элементов.dwg, Спецификация.dwg, с 1 листом ВО.dwg, с 1 листом ВО_1_4296_32a8caf2.sv$.dwg, схема сборки.dwg, схема сборки_1_4138_8a844f9d.sv$.dwg]
2020-05-07 ух бля
    [Перень элементов.dwg, с 1 листом ВО.dwg, схема сборки.dwg]
2020-05-07 прибрался
    [ВО.dwg, ВО_2_листа.dwg, ВО_странный))).bak.dwg, ВО_странный.dwg, ВО_странный___12.dwg, ВО_странный___12_1_9777.dwg, М2х8.dwg, компонов_очка чистовая.dwg]
2020-05-07 ещё допилил немного
    [РАСЧЁТЫ_РПЗ (Автосохраненный)-LAPTOP-VDOEU2V2.xlsx, РАСЧЁТЫ_РПЗ (Автосохраненный).xlsx, кин_схема.dwg, принципиальная_кин_схема_2.dwg]
2020-05-08 все на консу 08.05.2020, исправил некоторые нелочёты
    [принципиальная_кин_схема_2.dwg, с 1 листом ВО.dwg]
2020-05-18 добил до 5А1(вроде)
    [val.SLDPRT, Антону.dwg, Перень элементов.dwg, Чертеж пружины.dwg, вал в сборе.dwg, вал.dwg, габаритный-2.dwg, габаритный.dwg]
2020-05-18 переделал ГБ
    [ВО А1.dwg, ГБ А1.dwg, Чертеж пружины А4.dwg, вал А2.dwg, вал в сборе А2.dwg, вал в сборе.dwg, габаритный_1_11322А2.dwg, плита 1А2.dwg]
2020-05-20 добавил чертежи зк и двигатель в сборе
    [ВО А1.dwg, ГБ А1.dwg, Двигатель в сборе А3.dwg, ЗК А3.dwg, Перень элементов.dwg, вал А2.dwg, вал в сборе А2.dwg, габаритный_1_11322А2.dwg]
2020-05-21 исправил рпз
    [val_2.SLDPRT, ВО А1.dwg, Двигатель в сборе А3.dwg, ЗК А3.dwg, Каретка.dwg, Кириллу пружина А4.dwg, Чертеж пружины А4.dwg, вал А2.dwg]
2020-05-21 к предзащите кп
    [ВО А1.dwg, ГБ А1.dwg, Каретка.dwg, Перень элементов.dwg, габаритный_1_11322А2.dwg, принципиальная_кин_схема_2 А2.dwg]
2020-05-26 НА ЗАЩИТУ КУРСАЧАЧААААЧАЧАЧАЧ
    [val_2.SLDPRT, Антону.dwg, ВО А1.dwg, ГАБАРИТНЫЙ ЧЕРТЁЖ.dwg, ГБ А1.dwg, Двигатель в сборе А3.dwg, ЗК А3.dwg, Каретка.dwg]
